lsy041015/capstone-design-hanyang-university/README.md

<p align="center">
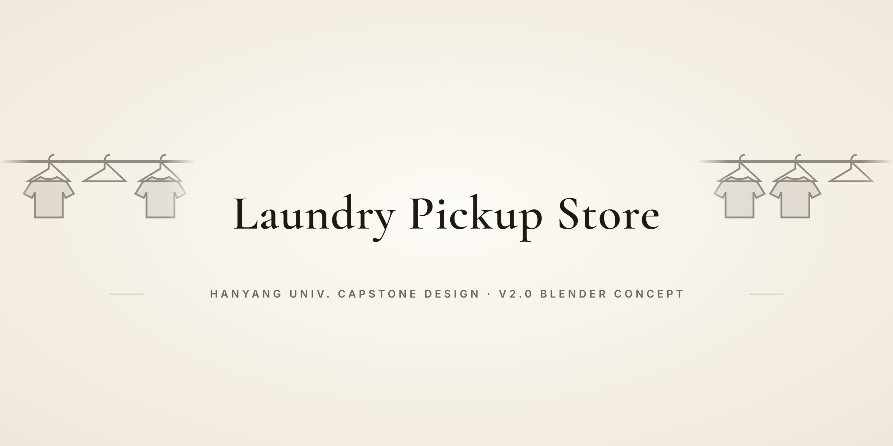
[picture p1: assets/capstone-banner.png]
무인 세탁물 수령 시스템 V2.0 — 세탁 완료품을 보관하고 인증한 고객에게 24시간 내주는 무인 세탁 수령소의 Blender 컨셉
  
</p>

<p align="center"><b>한국어</b> · <a href="README.en.md">English</a></p>

# 무인 세탁물 수령 시스템 (Automated Unmanned Laundry Pickup System)

한양대학교 캡스톤디자인(Hanyang University Capstone Design) 프로젝트입니다.

> **세탁이 끝난 의류와 신발을 자동화 셀이 보관하고, 인증한 고객에게 24시간 내주는 무인 세탁 수령소 컨셉입니다.**
> V2.0은 매장 전체(고객 로비, 셀프 빨래방, 자동화 셀, 직원 공간)와 직원·고객·휠체어 사용자의 동작을 하나의 1:1 Blender 타임라인에 담았습니다.
> 로봇은 옷감이나 신발 대신 운반구의 10 mm 고정 탭만 잡고, 사람은 움직이는 기계 밖에 머뭅니다.

> **상태: V2.0 — 시각·기하·동작 설계 컨셉입니다. 제작하거나 인증받은 기계가 아닙니다.** 저장한 모델을 다시 열어 자동 검사 7개를 통과했습니다
> (인터록 6,620프레임 위반 0, 로봇 동작 1,004프레임 간섭 0 등). 시간은 가정 축 속도로 계산한 모델 시간이고, 로봇 형상은 목표 기종 FR5e가 아닌
> UR5 CB-series 대체 메시입니다. [한계와 다음 단계](#16-한계와-다음-단계)를 먼저 읽어 주세요.

> **새 PoC (2026-11):** 졸업작품 2.5 m 셀 PoC(변형 4안, 포토 렌더, 2D 도면)는 [아래 최신 섹션](#최신-졸업작품-poc-25-m-셀-2026-11)에 모았습니다. → [poc_2.5m_cell/](poc_2.5m_cell/README.md)

---

## 목차

- [최신: 졸업작품 PoC 2.5 m 셀 (2026-11)](#최신-졸업작품-poc-25-m-셀-2026-11)

1. [왜 만들었나](#1-왜-만들었나)
2. [한눈에 보기](#2-한눈에-보기)
3. [동작 방식](#3-동작-방식)
4. [세부 공정 이미지](#4-세부-공정-이미지)
5. [모션스터디 티저 (V2.0)](#5-모션스터디-티저-v20)
6. [자료 보는 방법](#6-자료-보는-방법)
7. [매장 배치와 기구 구성](#7-매장-배치와-기구-구성)
8. [공정 순서와 허용 조건](#8-공정-순서와-허용-조건)
9. [사이클 시간](#9-사이클-시간)
10. [안전 · 정비 · 접근성](#10-안전--정비--접근성)
11. [검증](#11-검증)
12. [이전 버전 (v7 · v4)](#12-이전-버전-v7--v4)
13. [저장소 구조](#13-저장소-구조)
14. [기술 스택](#14-기술-스택)
15. [만들면서 고민한 것](#15-만들면서-고민한-것)
16. [한계와 다음 단계](#16-한계와-다음-단계)
17. [출처와 라이선스](#17-출처와-라이선스)

---

## 최신: 졸업작품 PoC 2.5 m 셀 (2026-11)

V2.0 매장의 의류 출고 공정만 2.5 m × 2.5 m 알루미늄 프로파일 셀 하나로 줄인 졸업작품 PoC입니다.
UR5e와 DH-Robotics AG-95 적응형 그리퍼를 쓰고, 같은 셀에서 옷을 보관해 로봇에게 가져다주는 방식만 바꾼 4안을 모델링했습니다.
상세 수치와 설계는 [poc_2.5m_cell/README.md](poc_2.5m_cell/README.md)에 있습니다.

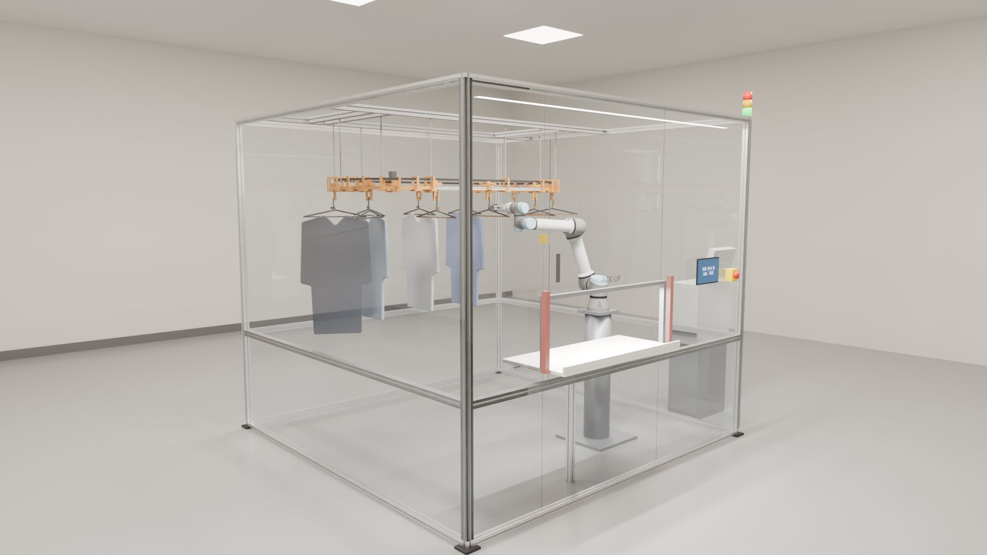
[picture p2: poc_2.5m_cell/renders/photo/P01_hero_front_left.jpg]
A안 PoC 셀 전경: 앞 왼쪽에서 본 2.5 m 프로파일 셀, UR5e, 오버헤드 컨베이어, 앞면 픽업 선반

<p align="center"><sub>A안, 앞 왼쪽에서 본 셀 전경 (Blender Cycles 포토 렌더)</sub></p>

**구성안 4가지**

A안이 처음 설계한 원안이고, B·C·D안은 접은 옷을 트레이에 담는 변형입니다. 셀 크기(2.5 × 2.5 m), 로봇, 그리퍼, 앞면 픽업 개구부는 같습니다.

| 안 | 보관 방식 | 용량 | 1사이클 (모델 시간) |
|---|---|---|---|
| A 오버헤드 컨베이어 | 옷걸이째 매달아 순환, 0.8 m 선반에 거치 | 캐리어 10개 | 46.9 s (고객 수령까지) |
| B 트레이 선반 | 접은 옷을 트레이에 담아 로봇 뒤 선반에 보관 | 2열 × 5단 = 10칸 | 38.1 s (고객이 꺼낼 때까지) |
| C 중앙 로봇 | 셀 중앙 로봇, 3면 트레이 선반, 픽업 벨트 | 3면 × 2열 × 5단 = 30칸 | 약 32.0 s (고객이 꺼낼 때까지) |
| D 서랍식 선반 | 얇은 트레이를 서랍처럼 꽂는 선반 + QR 확인, 빈 트레이는 되돌려 꽂음 | 3면 × 3열 × 15단 = 135칸 | 65.7 s (빈 트레이 복귀까지) |

사이클 시간은 끝나는 지점이 달라 그대로 비교할 수 없습니다.

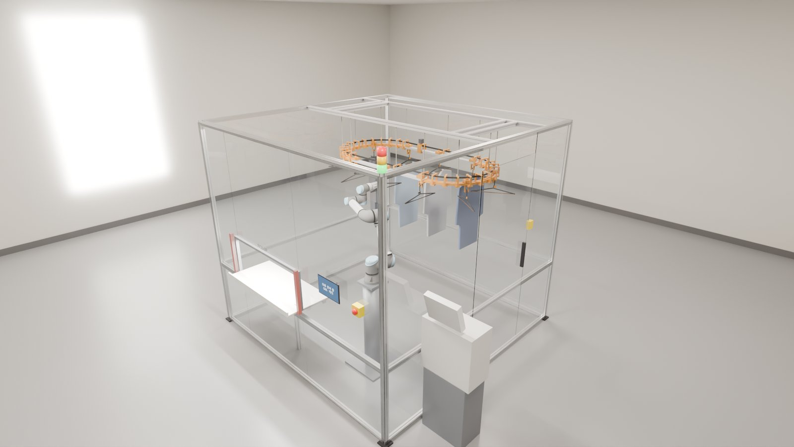
[picture p3: poc_2.5m_cell/renders/photo/P03_high_corner.jpg]
A안: 높은 모서리에서 본 오버헤드 컨베이어 셀
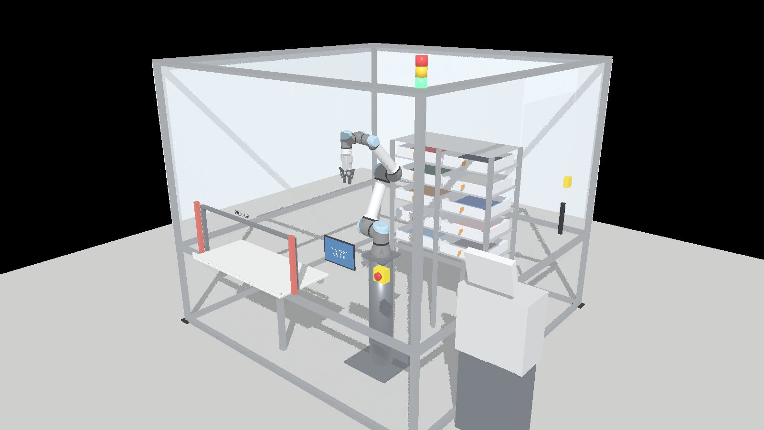
[picture p4: poc_2.5m_cell/renders/tray/T01_overview.jpg]
B안: 로봇 뒤 2열 5단 트레이 선반 전경

<p align="center"><sub>A안 오버헤드 컨베이어 (Cycles 포토) · B안 트레이 선반 (B안은 포토 렌더가 없어 Eevee 작업 렌더)</sub></p>
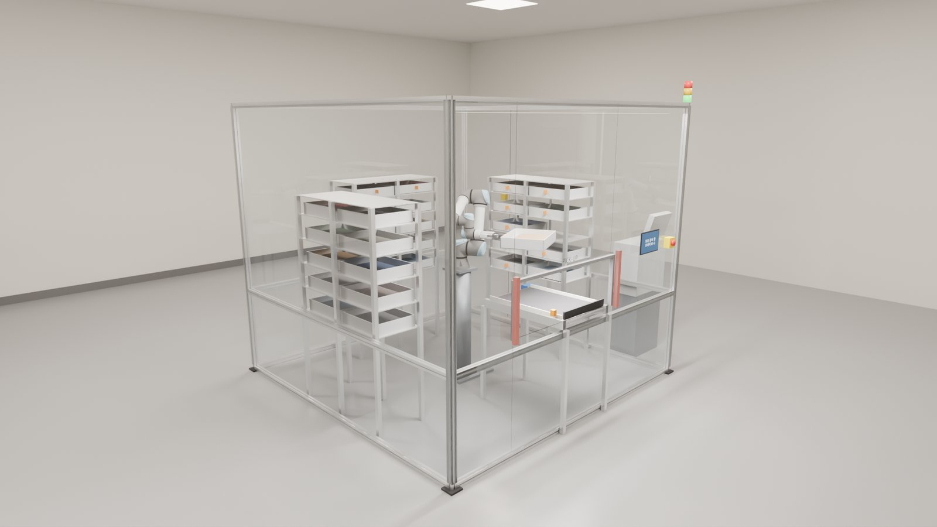
[picture p5: poc_2.5m_cell/renders/center_photo/S01_hero_front_left.jpg]
C안: 셀 중앙 로봇과 좌·뒤·우 3면 트레이 선반, 앞면 픽업 벨트
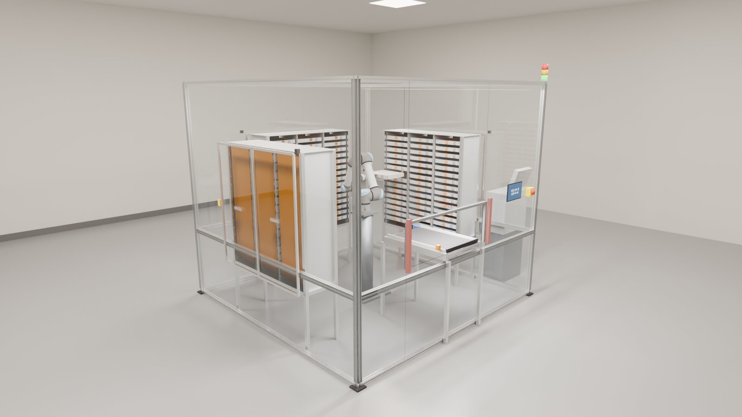
[picture p6: poc_2.5m_cell/renders/files_photo/F01_hero_front_left.jpg]
D안: 셀 중앙 로봇과 3면 135칸 서랍식 선반

<p align="center"><sub>C안 중앙 로봇과 30칸 선반 (Cycles 포토) · D안 135칸 서랍식 선반 (Cycles 포토)</sub></p>

**2D 도면**

Creo 13.4 교육용 버전에서 3각법 뷰를 만들고 ANSI C 또는 A3 도면으로 냈습니다. 치수는 Creo 뷰 위에 덧그린 주석입니다. 이미지를 누르면 PDF가 열립니다.

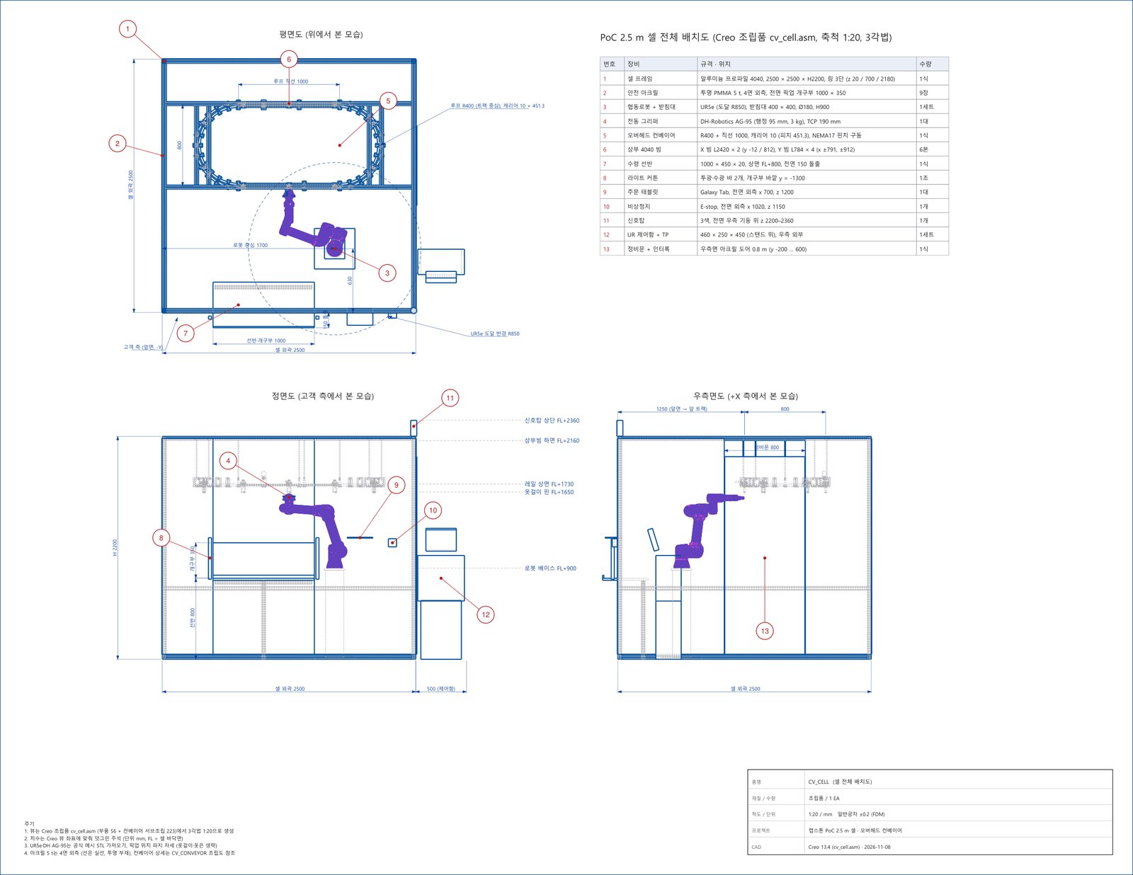
[picture p7: poc_2.5m_cell/drawings/preview/CV_CELL_LAYOUT.jpg]
A안 셀 전체 배치도 CV_CELL_LAYOUT: 평면도, 정면도, 우측면도와 부품표
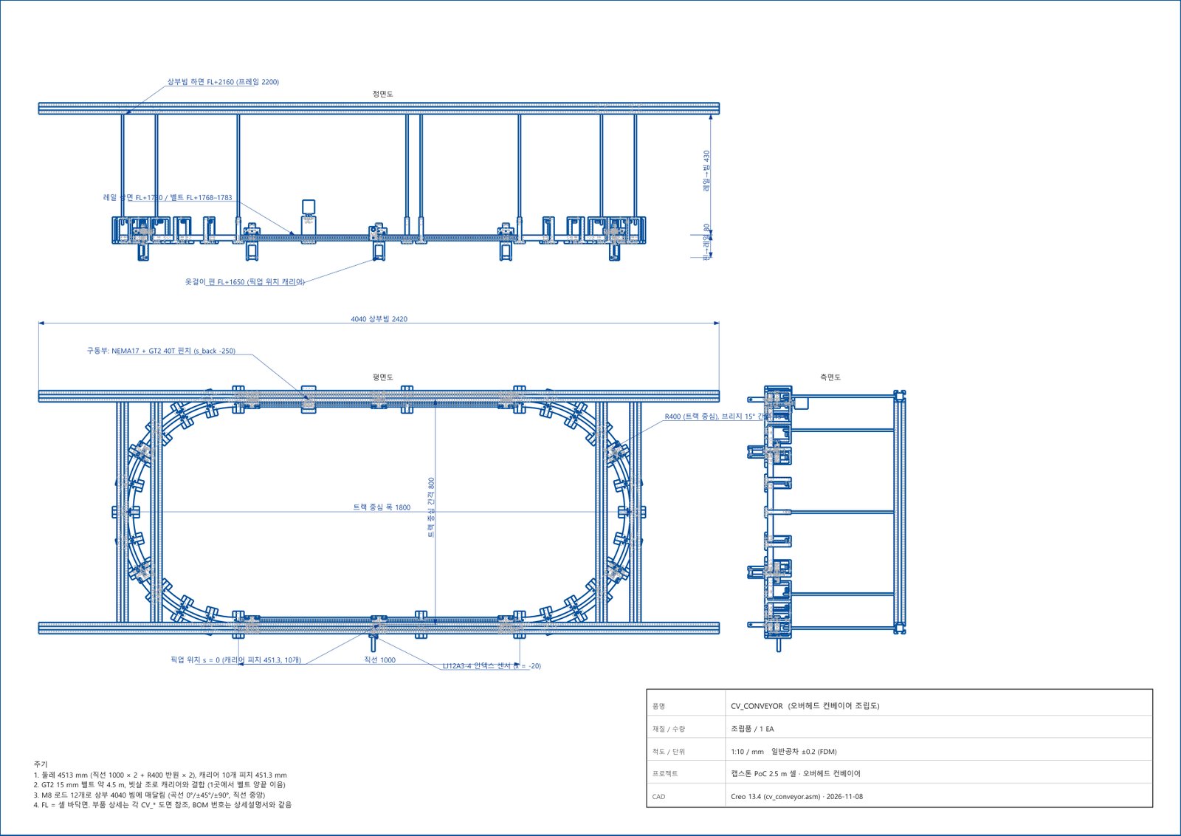
[picture p8: poc_2.5m_cell/drawings/preview/CV_CONVEYOR.jpg]
오버헤드 컨베이어 조립도 CV_CONVEYOR
<p align="center"> </p>
<p align="center"><sub>A안 셀 배치도 <code>CV_CELL_LAYOUT</code> (1:20) · 컨베이어 조립도 <code>CV_CONVEYOR</code> (1:10)</sub></p>
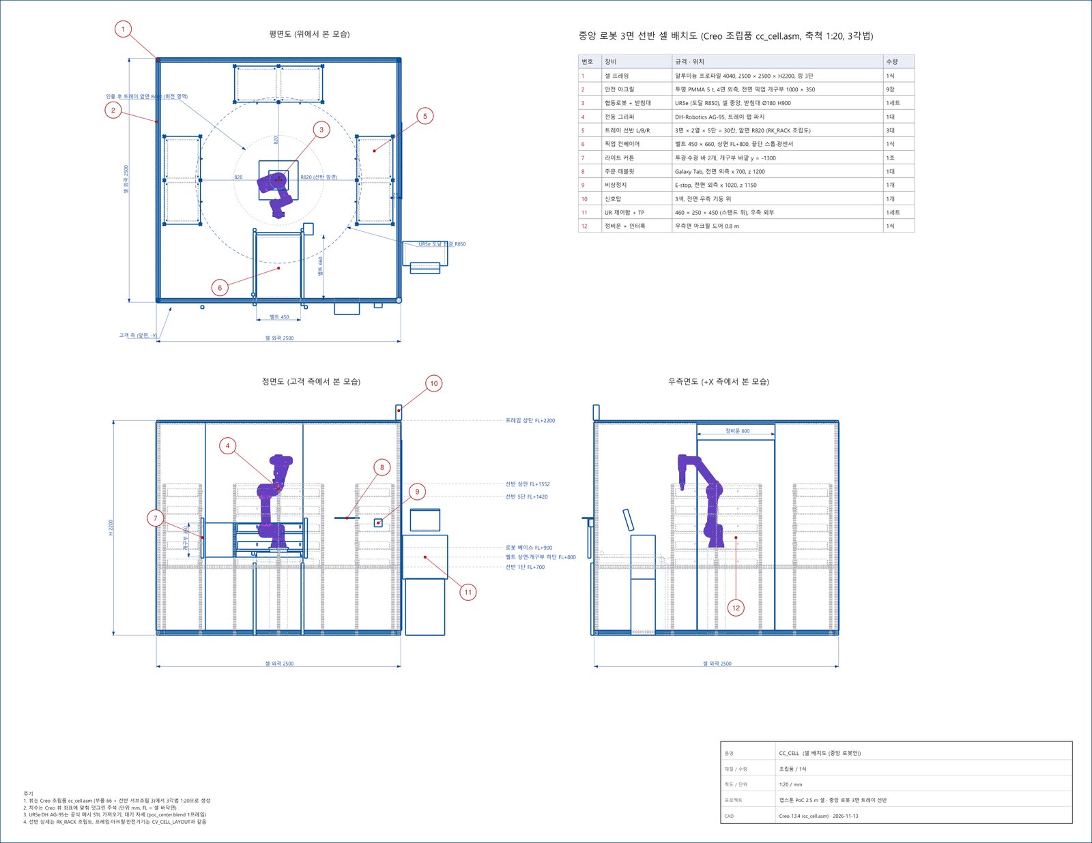
[picture p9: poc_2.5m_cell/drawings/preview/CC_CELL.jpg]
C안 셀 배치도 CC_CELL: 중앙 로봇과 3면 트레이 선반
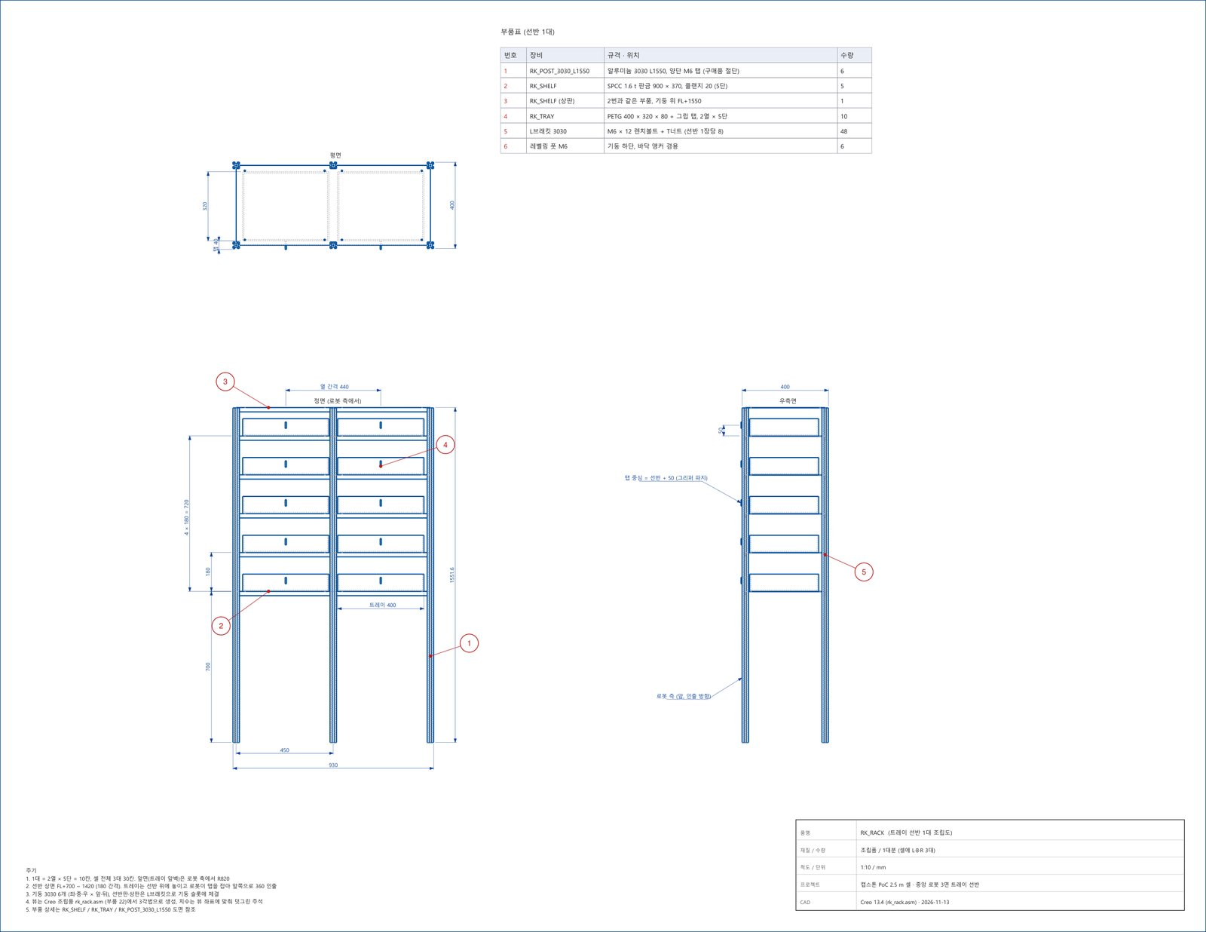
[picture p10: poc_2.5m_cell/drawings/preview/RK_RACK.jpg]
C안 트레이 선반 조립도 RK_RACK: 정면, 우측면, 평면과 부품표
<p align="center"> </p>
<p align="center"><sub>C안 셀 배치도 <code>CC_CELL</code> (1:20) · 트레이 선반 조립도 <code>RK_RACK</code> (1:10)</sub></p>

가공품 도면 묶음: [`CV_drawings_all.pdf`](poc_2.5m_cell/drawings/CV_drawings_all.pdf)(컨베이어 조립도와 가공품 9장), [`RK_drawings_all.pdf`](poc_2.5m_cell/drawings/rack_center/RK_drawings_all.pdf)(C안 선반 조립도, 선반 부품, 셀 배치도 5장).

**확인한 것과 모델뿐인 것**

- 확인한 것: A안은 Creo 파트 17종과 어셈블리 223개 컴포넌트를 배치했고(실패 0), 셀 사이클 2프레임 간격 524샘플에서 간섭 0건입니다. C안은 주문 접수부터 고객 수령까지 전체 사이클에서 0건, D안은 대표 15칸에서 0건입니다.
- 모델뿐인 것: 사이클 시간은 가정 축 속도로 계산한 모델 시간이고, 제작하거나 인증받은 설비가 아닙니다. D안의 나머지 120칸은 경로 계획만 했고, B안은 간섭 검사 결과를 남기지 않았습니다. B·C·D안의 선반, 트레이, 벨트는 Blender 개념 모델이고, Creo 선반 도면은 C안만 있습니다.
- 진행 중: 옷걸이 순환과 트레이 선반을 합친 하이브리드 변형안은 제작 중이며 아직 수치가 없습니다.

---

## 1. 왜 만들었나

매장 직원이 직접 건네주지 않아도 고객이 세탁 완료품을 찾아가게 하려면 세 가지를 함께 풀어야 합니다.

- **맞는 물품을 맞는 사람에게.** 인증한 고객에게 그 주문의 의류나 신발만 나와야 하고, 같은 재고를 두 요청이 가져가면 안 됩니다.
- **사람은 기계 밖에.** 직원이 물품을 넣을 때도, 고객이 꺼낼 때도 움직이는 기구에 손이 닿지 않아야 합니다.
- **모양이 다른 두 물품.** 옷걸이에 거는 의류와 한 켤레씩 담는 신발을 한 셀 안에서 따로 보관하고 내줘야 합니다.

V2.0은 셀만 따로 그리지 않고 매장 하나를 통째로 설계했습니다. 고객은 로비, 직원은 뒤쪽 직원 공간, 기계는 보호된 셀 안에만 있고,
서로 만나는 곳은 양문 수령함 2개와 라이트 커튼 보충구 2개뿐입니다. 직원이 무엇을 넣고 고객이 어디에 손을 뻗는지까지 1:1 시간으로 따라가며 확인했습니다.
세탁·건조, 옷을 옷걸이에 거는 일, 검수·포장은 사람의 일로 남깁니다. 저장소에는 시장 조사나 비용 분석 자료가 없습니다.

## 2. 한눈에 보기

시연 모델의 규모입니다. 상용 매장의 용량이나 수익성을 뜻하지 않습니다.

- 매장 실내 10.5 × 7.5 m(약 79 m²), 천장 2.8 m
- 의류 캐리어 26개(C01 순환 보관), 신발 트레이 12개(C03 수직 보관기, VLM)
- 직원 의류 보충창 1곳, VLM 직원 베이 1곳, 고객 수령함 A(의류)·B(신발)
- 로봇 셀 1개: FR5e 적용 검토를 위해 공식 UR5 CB-series STL을 형상·공칭 기구학 대체물로 사용
- 1:1 마스터 타임라인 6,620프레임(220.6초, 30 fps), 세부 공정 25단계

| 기능 | 하는 일 |
|---|---|
| **직원 입고** | 의류는 보충창 RFID 스캔 → 빈 캐리어 인덱싱 → 걸기 → 완료 버튼 순서입니다. 신발은 VLM이 빈 트레이를 직원 베이로 내보내면 새들백을 올리고 완료를 누릅니다. 라이트 커튼이 손을 감지하는 동안 해당 축은 멈춥니다. |
| **보관** | 의류는 C01 수평 체인 루프(캐리어 26개, 피치 203.2 mm)에, 신발은 C03 VLM(2열 × 7단, 보관 12칸)에 둡니다. |
| **고객 인증** | 키오스크에서 QR이나 수령번호로 인증하면 주문을 확인하고 물품을 예약한 뒤 준비를 시작합니다. 화면은 목업입니다. |
| **의류 출고** | C01 인덱싱·핀 체결·RFID 재확인 → C05 로봇 탭 파지 → 28 mm 리프트오프 → 0.5 m 인출 → 90° 회전 → A 수령 핀 거치·래치 → 내부 셔터 닫힘 → Y 450 mm 이송. |
| **신발 출고** | 의류와 동시에 VLM 승강·후크 추출 → 포트 컨베이어 → 로봇 → B 롤러 컨베이어 → 내부 셔터 닫힘 순서로 진행합니다. |
| **수령** | 양문 인터록: 내부 셔터가 닫히고 잠겨야 고객문이 열립니다. 옷걸이는 1.43 m, 신발 트레이 면은 0.85 m에서 받습니다. |
| **빈 운반구 회수** | 고객은 옷걸이째 의류와 새들백만 가져갑니다. 빈 어댑터는 원래 캐리어로, 빈 트레이는 VLM 빈 칸으로 자동 복귀합니다. |
| **접근성** | 낮은 위치 모드를 고르면 걸이를 23 cm 내려 1.20 m에서 받습니다. 회전 공간 지름 1.5 m, 조작부 0.4–1.2 m. |
| **정비** | SERVICE 키 → 로봇 원점·전 축 정지 확인 → 가드 잠금 해제 → 정비문 → LOTO → 닫힘·잠금 → AUTO 키 → 리셋. 자동 재기동은 없습니다. |
| **결과물** | 공정 분류도, 세부 공정 이미지 42장(6개 공정 폴더), 기구 분해도 8장, 2분 V2.0 티저와 한국어 자막, 공정 설계서, 검증 기록, 설계 신호·부품·제어 속성 목록(CSV). |

## 3. 동작 방식

매장은 고객 로비, 셀프 빨래방, 자동화 셀, 직원 공간으로 나뉩니다. 셀은 2.4 m 고정 가드와 메시 지붕으로 막혀 있고,
모든 전환은 위치·ID·안착·잠금 가운데 하나를 확인한 뒤에만 일어납니다.

```text
 1. 직원 입고 (라이트 커튼이 손을 감지하는 동안 해당 축 정지)
    의류: RFID 스캔 → 빈 캐리어 인덱싱 · 핀 → 보충창에 걸기 → 완료 · ID 재확인 → C01
    신발: 빈 트레이 → VLM 직원 베이 → 새들백 올리기 → 완료 → C03 빈 칸

 2. 고객 인증 (키오스크 QR 또는 수령번호)
    주문 확인 → 물품 예약 → 의류 · 신발 준비를 동시에 시작

 3. 의류 출고 (주문 → A 준비 27.5 s)
    C01 인덱싱 · 핀 · RFID → C05 탭 파지 → 28 mm 리프트오프 → 0.5 m 인출
    → 90° 회전 → C02 수령 핀 · 래치 → 내부 셔터 닫힘 → Y 450 mm → A 고객문 해제

 4. 신발 출고 (주문 → B 준비 40.1 s, 의류와 병렬)
    C03 승강 · 후크 추출 → 포트 컨베이어 → C05 → C06 롤러 → 내부 셔터 닫힘 → B 고객문 해제

 5. 수령과 회수
    옷걸이째 의류 · 새들백 수령 → 문 닫힘 · 제거 확인 → 주문 완료
    빈 어댑터 → C01 원래 캐리어, 빈 트레이 → C03 빈 칸

 6. 접근성과 정비
    낮은 위치 모드: Z 230 mm 하강 → 걸이 1.20 m
    SERVICE 키 → 로봇 원점 · 전 축 정지 → 가드 잠금 해제 → 정비 → 리셋 (자동 재기동 없음)
```

## 4. 세부 공정 이미지

V2.0 모델의 1:1 타임라인에서 세부 공정마다 뽑은 렌더 42장입니다. 공정별 폴더 `images/v2.0/<공정>/`에 나눠 두었고,
이미지마다 설명을 붙인 전체 목록은 [docs/v2.0_process_images.md](docs/v2.0_process_images.md)에 있습니다.
사람은 동선·도달 검토용 양식화 인형이고, 4-2 걸이 하강은 A 수령함 동쪽 라이너만 숨긴 단면 표현입니다.

먼저 공정 분류도로 전체 구성을 봅니다. 공정군 5개 아래 세부 공정 25단계를 두고, 단계마다 수행 주체(직원 · 고객 · 로봇 · 자동 설비)와 담당 모듈(C01–C06), 마스터 타임라인 시간을 붙였습니다. 모델 타임라인의 단계 목록에서 그대로 만들었습니다.

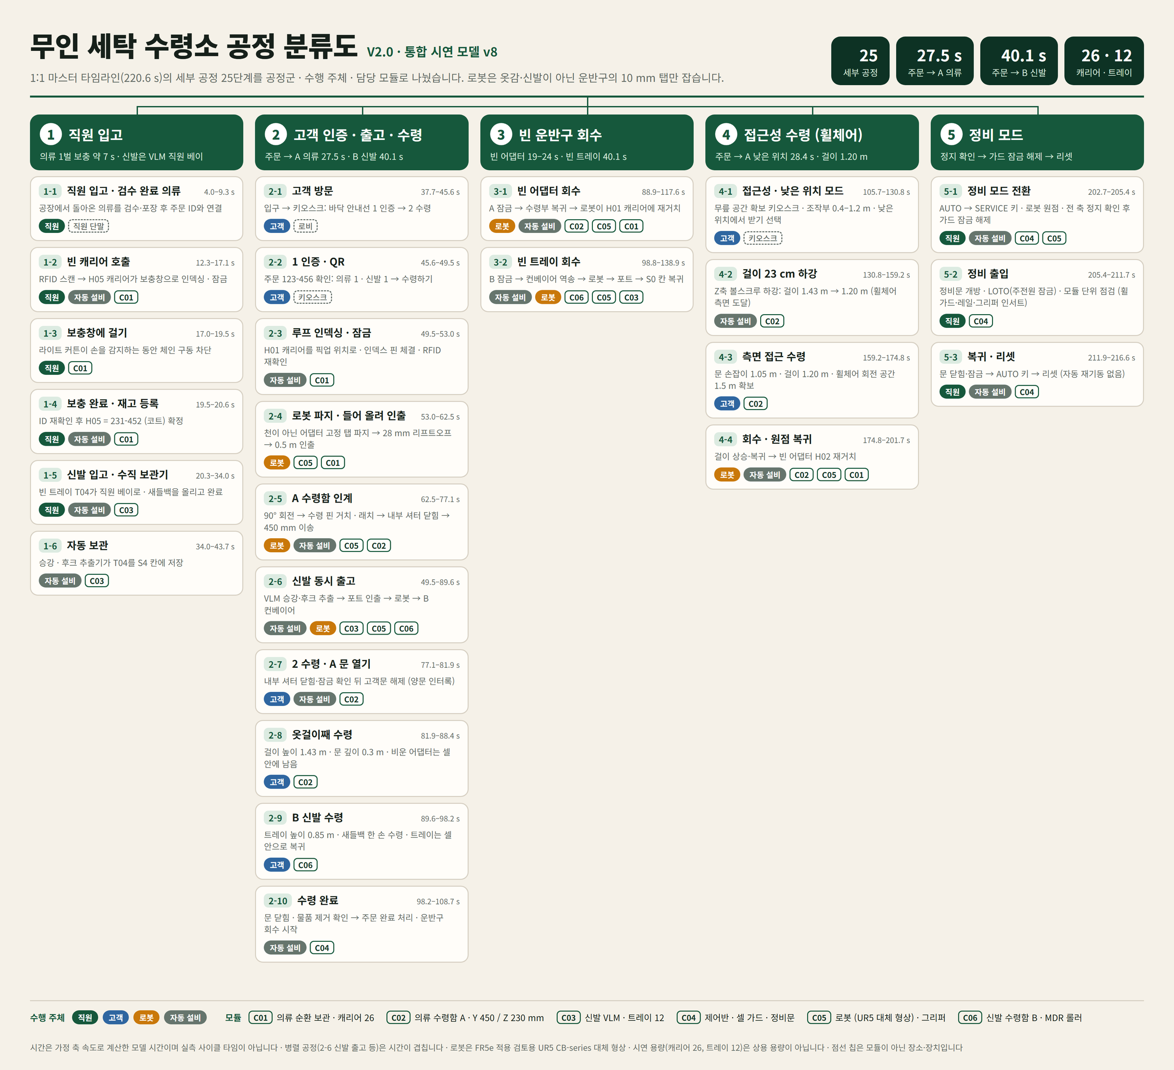
[picture p11: images/v2.0/process_map.png]
무인 세탁 수령소 V2.0 공정 분류도: 공정군 5개와 세부 공정 25단계를 수행 주체와 담당 모듈로 분류

<p align="center"><sub>공정 분류도 — 공정군 5개 · 세부 공정 25단계 · 수행 주체 · 담당 모듈 (시간은 가정 축 속도로 계산한 모델 시간)</sub></p>

<!-- v2.0-images:start -->
### 0 · 매장 구조와 동선

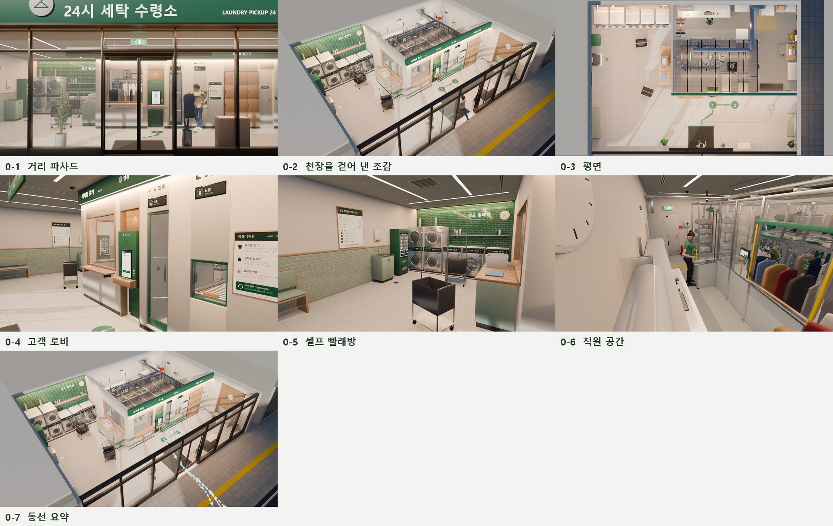
[picture p12: images/v2.0/0_store.jpg]
매장 구조와 동선 공정 이미지 모음


| 번호 | 공정 | 이미지 |
|---|---|---|
| 0-1 | 거리 파사드 — 24시 세탁 수령소 입구(자동문 폭 1.6 m), 옷을 찾아 나오는 고객 | [0-1_street_facade.jpg](images/v2.0/0_store/0-1_street_facade.jpg) |
| 0-2 | 천장을 걷어 낸 조감 — 셀프 빨래방 · 고객 로비 · 자동화 셀 · 직원 공간 | [0-2_cutaway_iso.jpg](images/v2.0/0_store/0-2_cutaway_iso.jpg) |
| 0-3 | 평면 — 실내 10.5 × 7.5 m, 자동화 셀 4.3 × 2.7 m | [0-3_plan.jpg](images/v2.0/0_store/0-3_plan.jpg) |
| 0-4 | 고객 로비 — 키오스크, A 의류 · B 신발 수령함, 이용 안내판, 대기 벤치 | [0-4_lobby.jpg](images/v2.0/0_store/0-4_lobby.jpg) |
| 0-5 | 셀프 빨래방 — 세탁기 3대, 2단 건조기 2조, 세제 자판기, 접이대 | [0-5_self_laundry.jpg](images/v2.0/0_store/0-5_self_laundry.jpg) |
| 0-6 | 직원 공간 — 검수 · 포장대, 의류 보충창, VLM 직원 베이 | [0-6_staff_area.jpg](images/v2.0/0_store/0-6_staff_area.jpg) |
| 0-7 | 동선 요약 — 고객 · 직원 · 휠체어 사용자의 이동 궤적 | [0-7_flow_summary.jpg](images/v2.0/0_store/0-7_flow_summary.jpg) |

### 1 · 직원 입고 (의류 · 신발)

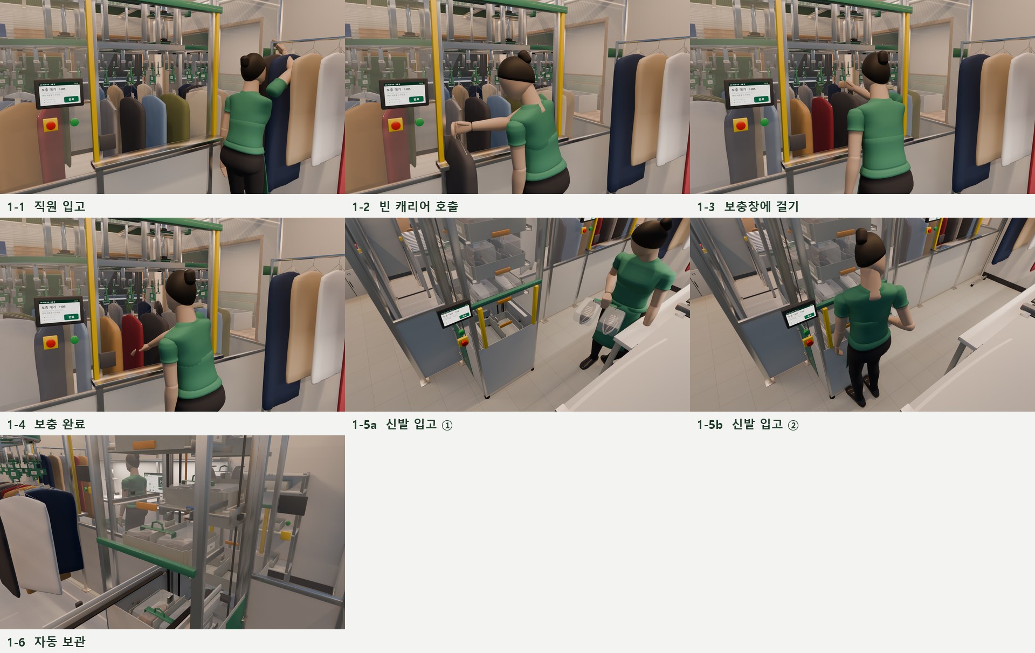
[picture p13: images/v2.0/1_staff_loading.jpg]
직원 입고 (의류 · 신발) 공정 이미지 모음


| 번호 | 공정 | 이미지 |
|---|---|---|
| 1-1 | 직원 입고 — 검수 · 포장한 의류를 주문 ID와 연결 | [1-1_inspect_garment.jpg](images/v2.0/1_staff_loading/1-1_inspect_garment.jpg) |
| 1-2 | 빈 캐리어 호출 — RFID 스캔 뒤 H05 캐리어가 보충창으로 인덱싱 · 잠금 | [1-2_call_empty_carrier.jpg](images/v2.0/1_staff_loading/1-2_call_empty_carrier.jpg) |
| 1-3 | 보충창에 걸기 — 라이트 커튼이 손을 감지하는 동안 체인 구동 차단 | [1-3_hang_at_window.jpg](images/v2.0/1_staff_loading/1-3_hang_at_window.jpg) |
| 1-4 | 보충 완료 — 완료 버튼, ID 재확인 뒤 재고 확정 | [1-4_confirm_stock.jpg](images/v2.0/1_staff_loading/1-4_confirm_stock.jpg) |
| 1-5a | 신발 입고 ① — 빈 트레이 T04가 VLM 직원 베이에 나오고, 직원이 새들백을 가져옴 | [1-5a_tray_to_staff_bay.jpg](images/v2.0/1_staff_loading/1-5a_tray_to_staff_bay.jpg) |
| 1-5b | 신발 입고 ② — 새들백을 트레이 칸막이에 걸쳐 올리고 완료 버튼 | [1-5b_place_saddle_bag.jpg](images/v2.0/1_staff_loading/1-5b_place_saddle_bag.jpg) |
| 1-6 | 자동 보관 — 승강 플랫폼과 후크 추출기가 T04를 S4 칸에 저장 | [1-6_vlm_auto_store.jpg](images/v2.0/1_staff_loading/1-6_vlm_auto_store.jpg) |

### 2 · 고객 인증 · 출고 · 수령

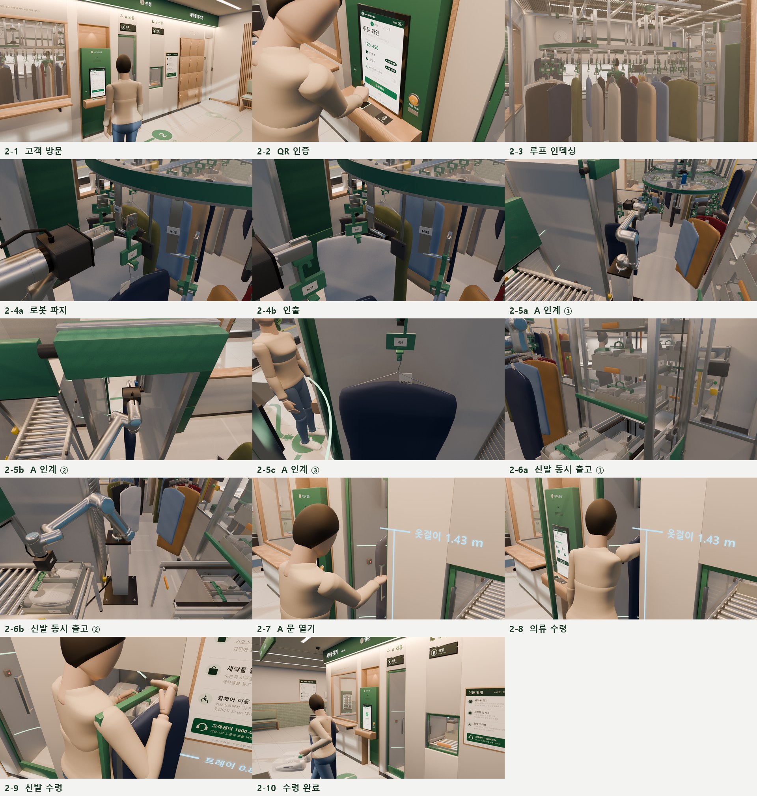
[picture p14: images/v2.0/2_order_pickup.jpg]
고객 인증 · 출고 · 수령 공정 이미지 모음


| 번호 | 공정 | 이미지 |
|---|---|---|
| 2-1 | 고객 방문 — 입구에서 바닥 안내선(1 인증 → 2 수령)을 따라 키오스크로 | [2-1_customer_arrives.jpg](images/v2.0/2_order_pickup/2-1_customer_arrives.jpg) |
| 2-2 | QR 인증 — 주문 123-456 확인: 의류 1 · 신발 1 | [2-2_kiosk_qr.jpg](images/v2.0/2_order_pickup/2-2_kiosk_qr.jpg) |
| 2-3 | 루프 인덱싱 — H01 캐리어가 픽업 위치로, 인덱스 핀 체결 · RFID 재확인 | [2-3_loop_indexing.jpg](images/v2.0/2_order_pickup/2-3_loop_indexing.jpg) |
| 2-4a | 로봇 파지 — 천이 아닌 어댑터의 10 mm 고정 탭을 잡음 | [2-4a_robot_tab_grip.jpg](images/v2.0/2_order_pickup/2-4a_robot_tab_grip.jpg) |
| 2-4b | 인출 — 28 mm 들어 올려 핀에서 빼고 반지름 방향으로 0.5 m 인출 | [2-4b_liftoff_extract.jpg](images/v2.0/2_order_pickup/2-4b_liftoff_extract.jpg) |
| 2-5a | A 인계 ① — 의류를 든 채 90° 회전 이송 | [2-5a_rotate_to_a.jpg](images/v2.0/2_order_pickup/2-5a_rotate_to_a.jpg) |
| 2-5b | A 인계 ② — 수령 핀에 거치, 래치 체결 뒤 그리퍼 개방 | [2-5b_place_on_receiver.jpg](images/v2.0/2_order_pickup/2-5b_place_on_receiver.jpg) |
| 2-5c | A 인계 ③ — 내부 셔터가 닫힌 뒤 Y축이 450 mm 이송해 고객문 뒤에 도착 (라이너를 숨긴 단면) | [2-5c_y_transfer.jpg](images/v2.0/2_order_pickup/2-5c_y_transfer.jpg) |
| 2-6a | 신발 동시 출고 ① — VLM 승강 · 후크 추출로 T01 인출 | [2-6a_vlm_fetch.jpg](images/v2.0/2_order_pickup/2-6a_vlm_fetch.jpg) |
| 2-6b | 신발 동시 출고 ② — 포트 컨베이어 → 로봇 → B 롤러 컨베이어 | [2-6b_port_to_b.jpg](images/v2.0/2_order_pickup/2-6b_port_to_b.jpg) |
| 2-7 | A 문 열기 — 내부 셔터 닫힘 · 잠금 확인 뒤 고객문 해제(양문 인터록) | [2-7_open_a_door.jpg](images/v2.0/2_order_pickup/2-7_open_a_door.jpg) |
| 2-8 | 의류 수령 — 옷걸이째 꺼냄(걸이 높이 1.43 m), 어댑터는 셀 안에 남음 | [2-8_take_garment.jpg](images/v2.0/2_order_pickup/2-8_take_garment.jpg) |
| 2-9 | 신발 수령 — 트레이 면 0.85 m, 새들백을 한 손으로 꺼냄 | [2-9_take_shoes.jpg](images/v2.0/2_order_pickup/2-9_take_shoes.jpg) |
| 2-10 | 수령 완료 — 문 닫힘 · 물품 제거 확인 뒤 주문 완료, 운반구 회수 시작 | [2-10_order_complete.jpg](images/v2.0/2_order_pickup/2-10_order_complete.jpg) |

### 3 · 빈 운반구 회수

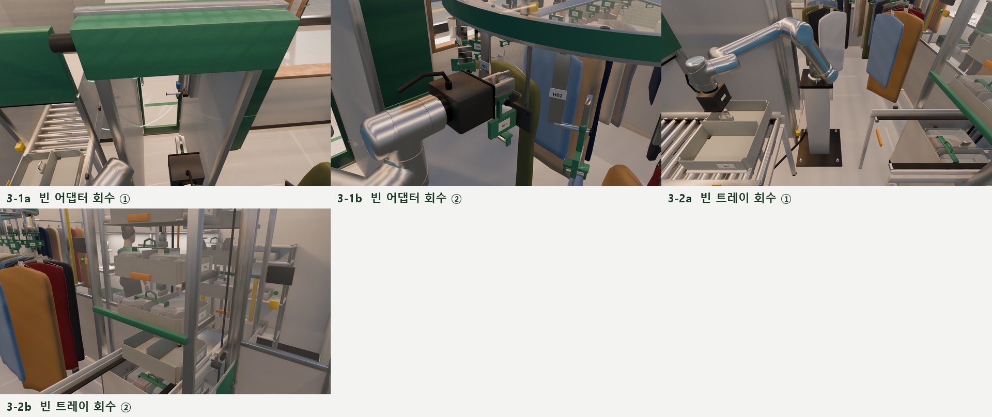
[picture p15: images/v2.0/3_carrier_return.jpg]
빈 운반구 회수 공정 이미지 모음


| 번호 | 공정 | 이미지 |
|---|---|---|
| 3-1a | 빈 어댑터 회수 ① — A 잠금, Y 복귀, 로봇이 빈 어댑터를 집음 | [3-1a_adapter_from_a.jpg](images/v2.0/3_carrier_return/3-1a_adapter_from_a.jpg) |
| 3-1b | 빈 어댑터 회수 ② — 원래 H01 캐리어 핀에 다시 거치 | [3-1b_rehang_on_h01.jpg](images/v2.0/3_carrier_return/3-1b_rehang_on_h01.jpg) |
| 3-2a | 빈 트레이 회수 ① — B 컨베이어 역송 → 로봇 → VLM 포트 | [3-2a_tray_back_to_port.jpg](images/v2.0/3_carrier_return/3-2a_tray_back_to_port.jpg) |
| 3-2b | 빈 트레이 회수 ② — 추출기가 트레이를 S0 칸으로 되돌림 | [3-2b_tray_to_s0.jpg](images/v2.0/3_carrier_return/3-2b_tray_to_s0.jpg) |

### 4 · 접근성 수령 (휠체어)

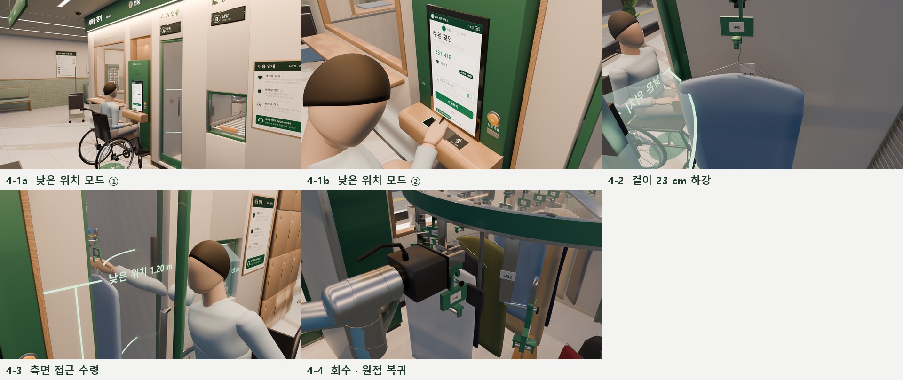
[picture p16: images/v2.0/4_accessible_pickup.jpg]
접근성 수령 (휠체어) 공정 이미지 모음


| 번호 | 공정 | 이미지 |
|---|---|---|
| 4-1a | 낮은 위치 모드 ① — 무릎 공간이 있는 키오스크에 휠체어로 정면 접근 | [4-1a_kiosk_knee_space.jpg](images/v2.0/4_accessible_pickup/4-1a_kiosk_knee_space.jpg) |
| 4-1b | 낮은 위치 모드 ② — 주문 231-418 인증, 낮은 위치에서 받기 선택 (조작부 0.4–1.2 m) | [4-1b_low_position_select.jpg](images/v2.0/4_accessible_pickup/4-1b_low_position_select.jpg) |
| 4-2 | 걸이 23 cm 하강 — Z축 볼스크루가 1.43 m → 1.20 m (라이너를 숨긴 단면) | [4-2_hanger_lowering.jpg](images/v2.0/4_accessible_pickup/4-2_hanger_lowering.jpg) |
| 4-3 | 측면 접근 수령 — 손잡이 1.05 m, 걸이 1.20 m, 회전 공간 1.5 m | [4-3_side_reach.jpg](images/v2.0/4_accessible_pickup/4-3_side_reach.jpg) |
| 4-4 | 회수 · 원점 복귀 — 빈 어댑터를 H02 캐리어에 재거치 | [4-4_return_home.jpg](images/v2.0/4_accessible_pickup/4-4_return_home.jpg) |

### 5 · 정비 모드

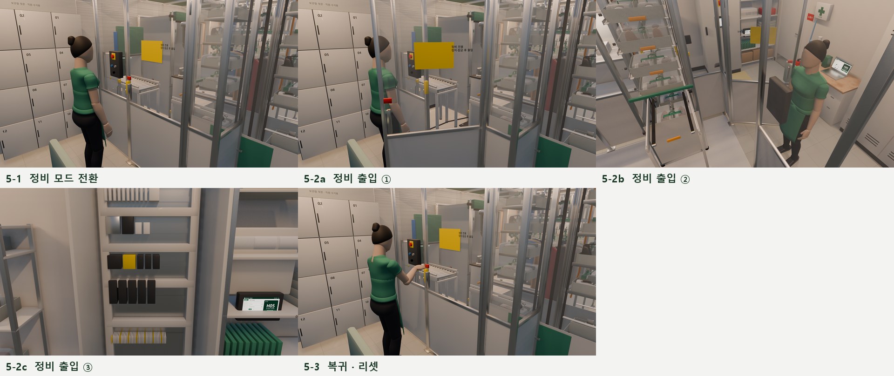
[picture p17: images/v2.0/5_service.jpg]
정비 모드 공정 이미지 모음


| 번호 | 공정 | 이미지 |
|---|---|---|
| 5-1 | 정비 모드 전환 — SERVICE 키, 로봇 원점 · 전 축 정지 확인 뒤 가드 잠금 해제 | [5-1_service_key.jpg](images/v2.0/5_service/5-1_service_key.jpg) |
| 5-2a | 정비 출입 ① — 정비문 개방(바깥 여닫이 60°) | [5-2a_service_door_open.jpg](images/v2.0/5_service/5-2a_service_door_open.jpg) |
| 5-2b | 정비 출입 ② — 셀 안에서 본 열린 정비문과 공구함을 든 정비 담당자 | [5-2b_door_from_inside.jpg](images/v2.0/5_service/5-2b_door_from_inside.jpg) |
| 5-2c | 정비 출입 ③ — C04 제어반 내부 (문을 연 상태로 렌더) · 셀 안 작업 전 주차단기에 LOTO | [5-2c_cabinet_inside.jpg](images/v2.0/5_service/5-2c_cabinet_inside.jpg) |
| 5-3 | 복귀 · 리셋 — 문 닫힘 · 잠금 → AUTO 키 → 리셋(자동 재기동 없음) | [5-3_close_and_reset.jpg](images/v2.0/5_service/5-3_close_and_reset.jpg) |

<!-- v2.0-images:end -->

## 5. 모션스터디 티저 (V2.0)

1:1 마스터 타임라인에서 15개 샷을 잘라 공정과 매장 구조, 사람과 기계가 만나는 지점을 2분 동안 설명하는 영상입니다.

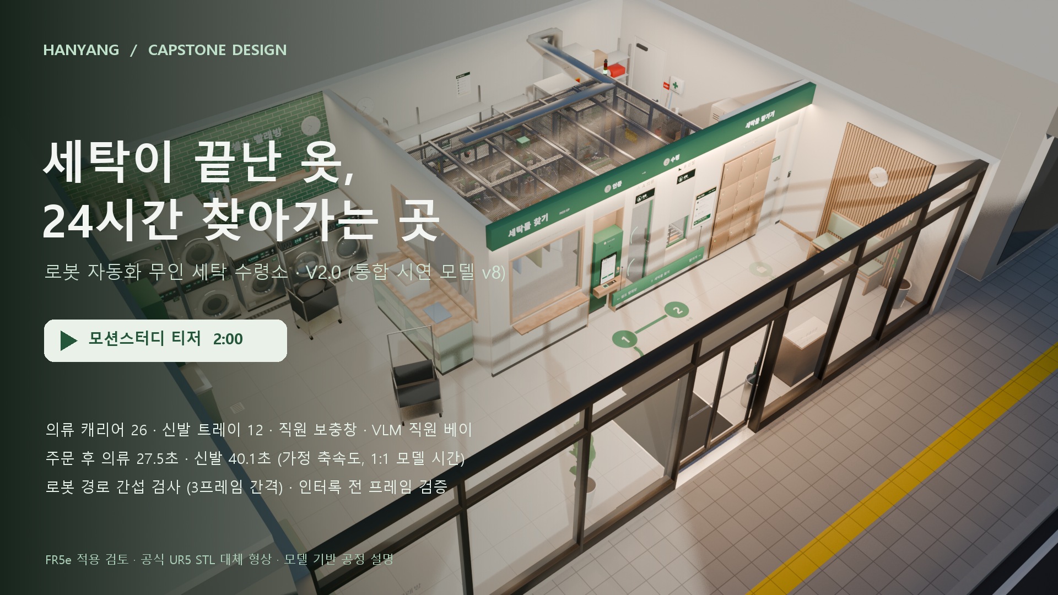
[picture p18: images/v2.0_teaser_poster.jpg]
V2.0 모션스터디 티저 포스터 — 누르면 영상 파일로 이동합니다


**[V2.0 티저 보기](videos/process_v2.0_teaser_120s_1080p30.mp4)** · 2:00 · 1920×1080 · 30 fps · 한국어 내레이션·그래픽 · [한국어 자막](videos/process_v2.0_ko.srt) · [샷별 설명](docs/v2.0_teaser.md)

- **재생**: GitHub은 저장소의 MP4를 README 안에서 재생하지 않습니다. 포스터를 누르면 파일 페이지로 이동하고, 내려받아 재생할 수 있습니다.
- **규격**: 120.0초, 3,600프레임, H.264(yuv420p) 1920×1080 30 fps, AAC 48 kHz 2채널, 챕터 15개, 36.9 MB. 음량은 −16 LUFS 목표로 정규화했습니다.
- **소리**: Windows Microsoft Heami Desktop 한국어 합성 음성과 NumPy로 합성한 앰비언트 배경음입니다. 내레이션 구간에서는 배경음이 자동으로 줄어듭니다.
- **자막**: MP4 안에 자막 트랙은 없습니다. 한국어 대사는 `videos/process_v2.0_ko.srt`에 있습니다. 화면 그래픽은 한국어입니다.

| 화면 시간 | 샷 | 카메라 | 마스터 구간 (s) |
|---|---|---|---|
| 0:00–0:06 | 오프닝 · 거리 파사드 | `CAM_STREET` | 0–6 |
| 0:06–0:14 | 매장 구조 · 절개 조감 | `CAM_ISO` | 37.5–45.5 |
| 0:14–0:26 | 직원 의류 보충 (라이트 커튼, RFID) | `CAM_STAFF_LOOP` | 8.7–20.7 |
| 0:26–0:34 | 직원 신발 보충 (VLM 베이) ×2 | `CAM_STAFF_VLM` | 25.1–41.1 |
| 0:34–0:47 | 고객 방문 · 키오스크 QR 인증 | `CAM_ENTRY`, `CAM_KIOSK` | 38.0–50.5 |
| 0:47–1:04 | 인덱싱 · 탭 파지 · 인출 · 90° 이송 (×2) | `CAM_TIP`, `CAM_ROBOT` | 51.0–76.0 |
| 1:04–1:10 | 신발 포트 → B 컨베이어 ×2 | `CAM_PORT_B` | 75.6–87.6 |
| 1:10–1:29 | A·B 수령, 높이 표시 | `CAM_A_CUST`, `CAM_B_CUST` | 77.7–97.4 |
| 1:29–1:42 | 걸이 23 cm 하강 (단면) · 휠체어 측면 접근 | `CAM_A_SECTION`, `CAM_A_WHEEL` | 151.7–174.4 |
| 1:42–1:51 | 정비 모드 · 가드 잠금 ×1.2 | `CAM_SERVICE` | 203.7–214.5 |
| 1:51–2:00 | 요약 · 동선 트레일 | `CAM_ISO` | 211.4–220.4 |

**영상을 볼 때 알아 둘 것.** 대기 구간만 1.2–2배로 압축했고, 압축한 샷에는 화면에 배속 표시가 붙습니다. 나머지는 모델의 1:1 시간입니다.
1:1 시간도 가정 축 속도로 계산한 값이며 측정한 설비 처리 속도가 아닙니다. QR 화면, 센서, 인터록은 Blender 논리 상태로 표현한 설계 신호입니다.

## 6. 자료 보는 방법

설치하거나 빌드할 소프트웨어가 없는 문서·미디어 저장소입니다.

**필요한 것**: 웹 브라우저. 자막과 함께 보려면 외부 SRT 자막을 불러올 수 있는 동영상 재생기.

```bash
git clone https://github.com/lsy041015/capstone-design-hanyang-university.git
cd capstone-design-hanyang-university

# 예: mpv에서 한국어 자막을 붙여 V2.0 티저 재생
mpv --sub-file=videos/process_v2.0_ko.srt videos/process_v2.0_teaser_120s_1080p30.mp4
```

- 읽는 순서: 이 README → [docs/v2.0_process_images.md](docs/v2.0_process_images.md)(공정별 이미지) →
  [docs/v2.0_process_design.md](docs/v2.0_process_design.md)(공정 설계서) → [docs/v2.0_verification.md](docs/v2.0_verification.md)(검증 기록).
- 설계 신호 52개는 [docs/v2.0_io_signals.csv](docs/v2.0_io_signals.csv), 부품 분류와 정비 제안은 [docs/v2.0_parts_maintenance.csv](docs/v2.0_parts_maintenance.csv),
  제어 리그의 축·신호 속성은 [docs/v2.0_control_properties.csv](docs/v2.0_control_properties.csv)에 있습니다.
- 편집 가능한 Blender 모델(`.blend`)과 생성 스크립트는 V2.0에도 포함하지 않았습니다. 모델을 직접 열거나 검사를 다시 돌릴 수는 없습니다.

## 7. 매장 배치와 기구 구성

실내 10.5 × 7.5 m를 네 구역으로 나눴습니다. 좌표는 모델 원점(남서쪽 모서리) 기준입니다.

| 구역 | 범위 (x, y m) | 내용 |
|---|---|---|
| 고객 로비 | 4.2–10.5, 0–3.0 | 자동문 입구(폭 1.6 m), 키오스크, A 의류·B 신발 수령함, 맡기기 사물함 12칸, 대기 벤치 |
| 셀프 빨래방 | 0–4.2, 0–7.5 | 세탁기 3대, 2단 건조기 2조, 세제 자판기, 접이대, 개수대 |
| 자동화 셀 | 4.2–8.5, 3.0–5.7 | 로봇(받침대 1.0 m), C01 순환 보관, C02·C06 수령부, C03 VLM, 가드 높이 2.4 m + 메시 지붕 |
| 직원 공간 | 4.2–8.5 × 5.7–7.5, 8.5–10.5 × 3.0–7.5 | 검수·포장대, 보충창, VLM 베이, C04 제어반, 로봇 컨트롤러, 정비문, 후문 |

셀은 C01–C06 여섯 모듈로 나뉩니다. 치수는 모델의 공칭 설계값이고, 부품명은 분류 예시입니다. V2.0의 모듈 번호는 v7과 뜻이 다릅니다.

| 코드 | 모듈 | 구성과 사양 |
|---|---|---|
| **C01** | 의류 순환 보관 | 수평 사이드플렉스 체인(피치 25.4 mm, 208 링크)을 알루미늄 U 트랙에 넣고 8링크(203.2 mm)마다 캐리어를 둡니다. 128포켓 휠 2개(피치 지름 1,035 mm), 경로 5.283 m. 동쪽 휠은 감속 모터·브레이크·절대 엔코더와 인덱스 핀(부시 16개), 서쪽 휠은 스크루 테이크업입니다. 가정 속도 0.25 m/s. |
| **C02** | 의류 수령함 A | 로봇 쪽 롤업 셔터(슬랫 46장), 타이밍벨트 Y축(행정 450 mm), 볼스크루 Z축(Ø12, 리드 10 mm, 행정 230 mm), 수령 핀과 솔레노이드 래치, 유리 고객문(0.46 × 1.85 m, 손잡이 1.05 m). |
| **C03** | 신발 수직 보관기 (VLM) | 남쪽 열(로봇 측)·북쪽 열(직원 측) 각 7단, 피치 250 mm. 2단(0.85 m)은 남쪽 로봇 포트와 북쪽 직원 베이입니다. 양측 타이밍벨트 승강(0.5 m/s 가정), 16 mm 상승 후크 추출기, 0.41 m 포트 컨베이어. |
| **C04** | 제어반과 셀 구조 | 800 × 550 × 2,000 mm 제어반(전원부 → 보호 → 24 V·UPS·안전 접촉기 → PLC·안전 컨트롤러·I/O → 서보 드라이브 → 단자대), 45 mm 프로파일 가드, 동쪽 정비문, 신호탑. |
| **C05** | 로봇과 그리퍼 | UR5 CB-series 대체 형상, 받침대 기준면 1.00 m. 서보 평행 그리퍼의 POM 인서트에 V 리브 2줄이 있어 탭 리브와 맞물립니다. 접근 간격 30 mm, 파지 간격 10 mm, TCP는 플랜지에서 170 mm. |
| **C06** | 신발 수령함 B | 24 V MDR 롤러 컨베이어(Ø50, 피치 75 mm, 14본). 트레이가 0.65 m 이동해 수직 슬라이딩 내부 셔터를 지나 고객 수령 위치에 섭니다. 롤러 면 0.85 m, 고객문 0.48 × 0.52 m. |

세 가지 공통 운반구가 모든 인계를 맡습니다.

| 운반구 | 형상 | 인터페이스 |
|---|---|---|
| 의류 어댑터 | PC 몸체, J-컬 새들, 스테인리스 탭, 하부 걸이봉, RFID | 캐리어·수령 핀 Ø12 위에 앉고, 28 mm 들어 올리면 빠집니다. 고객은 일반 철사 옷걸이째 가져가고 어댑터는 셀에 남습니다. |
| 신발 트레이 | 420 × 320 × 100 mm, 측면 POM 러너, 양 끝 추출 홈, 칸막이 위 탭(바닥 위 190 mm) | VLM 레일·덱·벨트·롤러의 공통 바닥면 |
| 신발 새들백 | 투명 파우치 2개를 칸막이 위 스트랩으로 연결, 손잡이 고리 | 고객·직원이 한 손으로 한 켤레를 넣고 뺍니다. 스트랩은 로봇 탭과 겹치지 않게 앞쪽 100 mm에 있습니다. |

### 기구 분해도

모듈마다 부품 그룹을 벌려 놓고 정사영으로 렌더한 분해도 8장입니다. C01–C06 여섯 모듈에, 핵심 세부 공정인 2-4 탭 파지의 그리퍼·어댑터·캐리어 인터페이스와 신발 트레이·새들백을 더했습니다. 부품 번호표는 [docs/v2.0_exploded_views.md](docs/v2.0_exploded_views.md)에 있습니다.

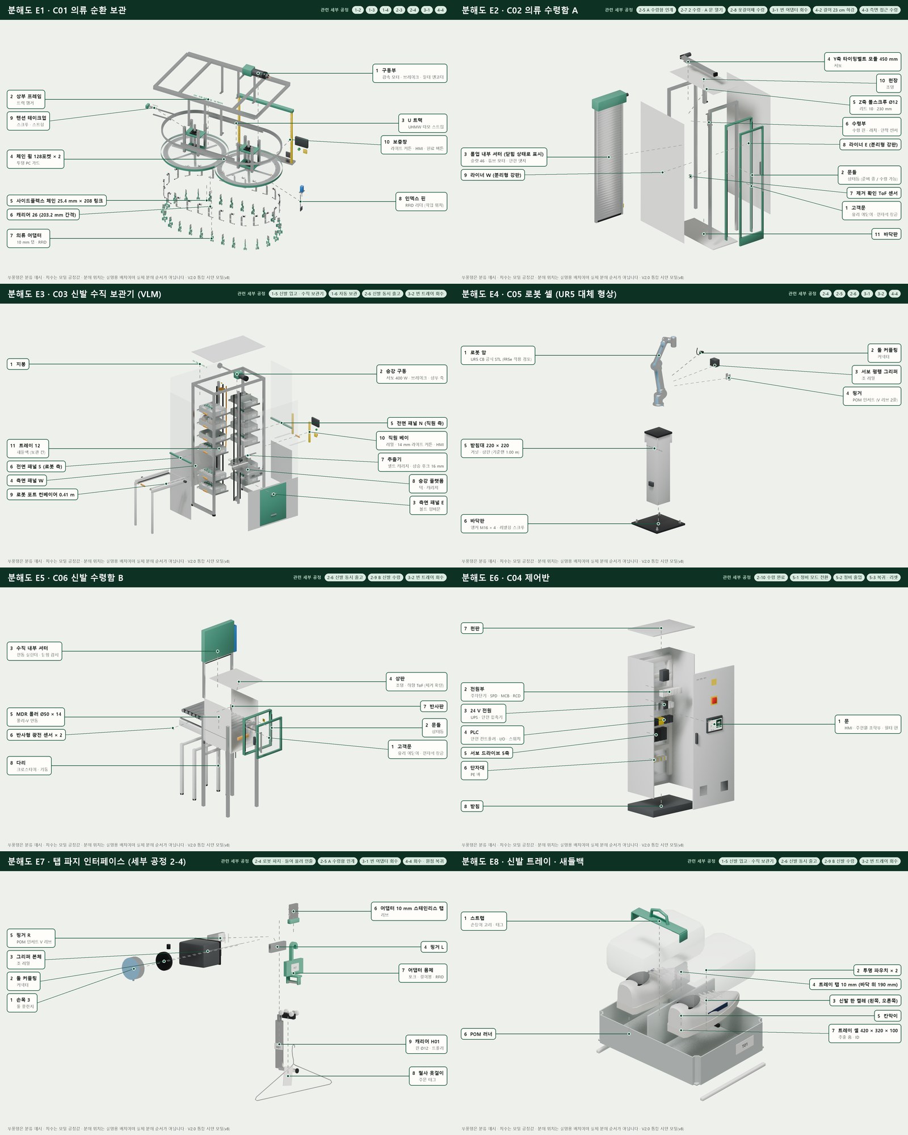
[picture p19: images/v2.0/exploded_sheet.jpg]
기구 분해도 8장 모음: C01 의류 루프, C02 A 수령함, C03 VLM, C05 로봇 셀, C06 B 수령함, C04 제어반, 탭 파지 인터페이스, 신발 트레이·새들백


<!-- v2.0-exploded:start -->
| 분해도 | 대상 | 관련 세부 공정 |
|---|---|---|
| [E1](images/v2.0/exploded/E1_c01_garment_loop.png) | C01 의류 순환 보관 | 1-2 · 1-3 · 1-4 · 2-3 · 2-4 · 3-1 · 4-4 |
| [E2](images/v2.0/exploded/E2_c02_garment_compartment_a.png) | C02 의류 수령함 A | 2-5 · 2-7 · 2-8 · 3-1 · 4-2 · 4-3 |
| [E3](images/v2.0/exploded/E3_c03_shoe_vlm.png) | C03 신발 수직 보관기 (VLM) | 1-5 · 1-6 · 2-6 · 3-2 |
| [E4](images/v2.0/exploded/E4_c05_robot_cell.png) | C05 로봇 셀 (UR5 대체 형상) | 2-4 · 2-5 · 2-6 · 3-1 · 3-2 · 4-4 |
| [E5](images/v2.0/exploded/E5_c06_shoe_compartment_b.png) | C06 신발 수령함 B | 2-6 · 2-9 · 3-2 |
| [E6](images/v2.0/exploded/E6_c04_control_cabinet.png) | C04 제어반 | 2-10 · 5-1 · 5-2 · 5-3 |
| [E7](images/v2.0/exploded/E7_tab_grip_interface.png) | 탭 파지 인터페이스 (세부 공정 2-4) | 2-4 · 2-5 · 3-1 · 4-4 |
| [E8](images/v2.0/exploded/E8_shoe_tray_saddle_bag.png) | 신발 트레이 · 새들백 | 1-5 · 2-6 · 2-9 · 3-2 |
<!-- v2.0-exploded:end -->

분해 위치는 설명용 배치이며 실제 분해 순서가 아닙니다. E2는 내부 셔터를 닫힌 상태로, E7은 2-4 탭 파지 순간(마스터 56.5 s)의 자세로 렌더했습니다.

## 8. 공정 순서와 허용 조건

각 동작 뒤에는 확인이 하나씩 붙고, 확인이 실패하면 다음 동작을 막습니다. 전체 표는 [공정 설계서 5장](docs/v2.0_process_design.md#5-공정-순서와-허용-조건)에 있습니다.

| 공정 | 동작 | 다음 단계 허용 조건 |
|---|---|---|
| 직원 의류 입고 | 태그를 보충창 RFID 패드에 댐 → 빈 캐리어(H05) 인덱싱·핀 체결 → 옷걸이를 어댑터에 걺 → 완료 버튼 | 주문 ID 유효·빈 캐리어 있음 → 엔코더 위치 = 목표·핀 체결 → 커튼 차단 중 체인 구동 금지 → 캐리어 ID와 품목 ID 일치 |
| 직원 신발 입고 | 빈 트레이(T04)가 직원 베이로 → 새들백 올리고 완료 → 추출기가 S4에 저장 | 베이 비어 있음 → 커튼 차단 중 승강·추출 금지 → 슬롯 점유 센서 확인 뒤 재고 확정 |
| 인증 | QR 인증 → 주문 확인 → 수령하기 | 주문 유효·중복 작업 없음 → 물품 예약 |
| 의류 출고 | 인덱싱·핀·RFID → 탭 파지 → 리프트오프·인출 → 90° 이송 → 거치 → 래치 → 해제 → 후퇴 → 셔터 닫힘 → Y 이송 | 로봇 원점·캐리어 정지 → 그리퍼 위치 센서 → 안착 센서 → 래치 닫힘 뒤 그리퍼 개방 → 로봇이 A 밖·셔터 잠금·고객문 잠금일 때만 Y 이동 |
| 신발 출고 | 승강 → 후크 → 덱 → 2단 → 포트 → 로봇 → B 컨베이어 → 셔터 닫힘 | 포트·안쪽 끝 광전 센서, 셔터 잠금 |
| 수령 | A에서 옷걸이째, B에서 새들백을 꺼냄 | 제거 확인 + 문 닫힘 → 주문 완료 |
| 회수 | 빈 어댑터: A 잠금 → Y 복귀 → 셔터 개방 → 파지 → 래치 해제 → −90° 이송 → H01 거치. 빈 트레이: B 잠금 → 역송 → 로봇 → 포트 → 추출기 → S0 | 문 잠금 확인 뒤에만 셀 쪽 동작 |
| 정비 | SERVICE 키 → 신호탑 황색 → 로봇 원점 → 전 축 정지 → 가드 잠금 해제 → 정비문(60°) → 점검 → 닫힘·잠금 → AUTO 키 → 리셋 | 셀 안 작업 전 C04 주차단기에 개인 자물쇠(LOTO) |

## 9. 사이클 시간

모델 1:1 타임라인에서 잰 시간입니다. 가정 축 속도로 계산했으며 실측값이 아닙니다.

| 작업 | 시간 | 비고 |
|---|---:|---|
| 주문 → A 의류 준비 | 27.5 s | 인덱싱·핀 체결·RFID 약 4 s 포함 |
| 주문 → B 신발 준비 | 40.1 s | VLM은 주문 즉시 병렬 시작, 로봇은 의류 뒤 |
| 주문 → A 준비 (낮은 위치) | 28.4 s | Z 230 mm 하강 포함 |
| 빈 어댑터 회수 | 19–24 s | 로봇 대기 포함 |
| 빈 트레이 회수 | 40.1 s | VLM 저장까지 |
| 직원 의류 1벌 보충 | 약 7 s | 스캔 → 인덱싱 → 걸기 → 완료 |

축 한계 가정: 로봇 관절 90°/s·180°/s²(UR5 최대 180°/s의 절반), 직선 0.25 m/s·삽입 0.06 m/s, 체인 0.25 m/s, VLM 승강 0.5 m/s,
추출기 0.3 m/s, 수령부 Y 0.3 m/s·Z 0.1 m/s, 컨베이어 0.25 m/s.

## 10. 안전 · 정비 · 접근성

안전 개념은 설계 의도이며 적합성 평가가 아닙니다. 참고한 규격은 ISO 10218, ISO 13857, ISO 14119, ISO 14120, ISO 13856-2, IEC 60204-1이고,
이 모델로 위험성 평가나 적합성 확인을 하지 않았습니다.

| 위험 지점 | 대책 | 모델 표현 |
|---|---|---|
| 로봇·체인·승강기 | 2.4 m 고정 가드 + 메시 지붕. 개구부는 수령함 2곳과 보충구 2곳뿐 | 셀 프레임 |
| 고객 수령함 A·B | 양문 인터록: 내부 셔터 닫힘·잠금 전 고객문 해제 금지, 고객문 열림 중 Y·컨베이어 구동 금지 | `a_*`, `b_*` 신호, 전 프레임 논리 검사 |
| 직원 보충창·VLM 베이 | Type 4 라이트 커튼(30 / 14 mm). 차단 시 해당 축 정지 | `curtain` 신호 |
| 정비문 | 가드 잠금 인터록, 정지 확인 뒤 해제, LOTO | `svc_door`, 조작반 |
| 체인 휠 협착점 · 셔터 하단 | 볼트 고정 투명 PC 가드 · 감압식 안전 엣지 | C01 가드, C02 셔터 |

정비는 모듈 단위입니다. C01–C06은 각자 프레임을 가진 교체 단위이고, 커버는 볼트 체결, 점검창은 투명 PC, 그리스 니플은 노란색으로 표시했습니다.
예: C01 체인 윤활 월 1회·늘어남 6개월 점검(2 % 교체), C05 핑거 인서트 V홈 마모 0.5 mm 교체(주기는 가정). 전체는 [부품·정비 목록](docs/v2.0_parts_maintenance.csv)에 있습니다.

| 접근성 항목 | 높이·치수 |
|---|---|
| 키오스크 화면 중심 / QR 리더 | 1.10 m (조작부 ≤ 1.16 m) / 0.84 m |
| A 고객문 손잡이 | 1.05 m |
| 옷걸이 (기본 / 낮은 위치) | 1.43 m / 1.20 m |
| B 트레이 면 / 새들백 손잡이 | 0.85 m / 1.00 m |
| 회전 공간 | 지름 1.5 m (수령함 앞 x 5.8–8.2, y 1.4–3.0을 비워 둠) |

휠체어 사용자는 문에 평행하게 대고 손잡이를 당겨 연 뒤 옆으로 손을 뻗어 옷걸이를 잡습니다. 측면 도달 약 0.65 m는 모형 기준 추정값입니다.

## 11. 검증

검사는 저장한 모델을 다시 열어 프레임을 실제로 평가하는 방식입니다. Blender 안의 형상·논리 상태만 확인하며,
실물 하중, 구매품 정격, PLC·안전 회로, FR5e 실측 기구학은 검사 대상이 아닙니다. 원자료는 [docs/v2.0_verification.json](docs/v2.0_verification.json)입니다.

| 검사 | 기준 | 결과 |
|---|---|---|
| 드라이버 | 모두 유효 + 단순식(Python 자동 실행 불필요) | 223개, 오류 0, 비단순식 0 |
| 기구 연동 | 휠 각 = s/R, 캐리어 = 경로 위치, Y 풀리 = −y/r, Z 스크루 = z/리드×2π, 롤러 = x/r, 승강 = z | 414 표본, 최대 오차 캐리어 0.024 mm |
| 로봇 리그 | Blender TCP = numpy 공칭 순기구학 | 최대 1.2 × 10⁻⁶ m |
| 관절 한계·속도 | ±360°, ≤ 180°/s (UR5 CB 공칭) | 최대 관절 속도 72°/s, TCP 최대 1.08 m/s |
| 화물 인계 연속성 | 모든 소켓 전환 순간의 위치 차 < 2 mm | 31회, 최대 0.78 mm |
| 인터록 논리 | 전 프레임: 양문 동시 개방, 문 열림 중 이송, 핀 체결·커튼 차단 중 체인 구동, 추출기 전개 중 승강, 정비문 개방 중 구동, 셔터 완전 개방 전 A 진입 금지 | 6,620프레임 위반 0 |
| 로봇 간섭 | 로봇 모션 3,012프레임 중 3프레임마다, 로봇 7링크 + 그리퍼 + 들고 있는 화물 vs 반경 2 m 안의 모든 메시 | 1,004프레임 교차 0 |
| 루프 의류 간격 | 체인 위치 12곳 × 의류 26벌 상호 교차 | 2,680쌍, 교차 0 |

- **사람 모형**: 접지 중 발 미끄럼 0.00 mm(접지 구간 195개), 접촉·유지 중 손끝과 목표의 차이 ≤ 0.01 mm(938프레임), 보폭 0.61–0.66 m.
- **화면 확인**: 카메라 샷 26개의 중간 프레임과 티저 15개 샷을 1080p로 렌더해 형상·가림·동작·주석 위치를 눈으로 확인하고, 벽 속 카메라 4대와
  가시성 버그 등을 고쳤습니다.
- **카메라–사람 간격**: 영상 3,600프레임과 공정 이미지 42장에서 카메라가 사람 기준점과 수평 0.5 m 안에 들어간 경우 0건입니다.
- **영상**: 게시 MP4 판정 `PASS`. 3,600프레임 전체 디코딩 오류 0, 챕터 15개, 음량 평균 −18.7 dB · 최대 −1.5 dB. SHA-256 `cc1de31781b3…`, 전체 값은 [docs/v2.0_video_verification.json](docs/v2.0_video_verification.json)에 있습니다.
- **검사하지 않은 것**: 3프레임 간격 사이의 순간 접촉, 의류의 유연 변형, 로봇 자기 충돌, 동역학, 실제 센서 응답, 안전 기능의 성능 수준(PL), 정지 거리, 전장 설계.

자세한 기준과 고친 문제는 [docs/v2.0_verification.md](docs/v2.0_verification.md)에 있습니다.

## 12. 이전 버전 (v7 · v4)

V2.0 이전 공개본의 자료는 지우지 않고 그대로 둡니다. v7 README 전문은 [docs/v7_overview.md](docs/v7_overview.md)에 옮겨 두었습니다.

- **v7 원본 검사 모델**: 정지 검사 포즈 31개, 자동 검사 177개. 렌더 12장은 `images/01_…`–`images/12_…`, 모음 이미지는 `images/process_gallery.jpg`입니다.
- **v7 티저**: [videos/process_v7_teaser_120s_1080p30.mp4](videos/process_v7_teaser_120s_1080p30.mp4) · 2:00 · 21장면 · 한국어·영문 자막 · [장면별 설명](docs/v7_process_teaser.md)
- **v4 영상**: [videos/process_v4_60s_1080p30.mp4](videos/process_v4_60s_1080p30.mp4) · 60초 · 86개 세부 공정 · 음성 없음

v7은 셀만 다룬 모델이고 시연 용량(의류 8, 신발 트레이 4)과 모듈 번호(C01–C07)가 V2.0과 다릅니다. 두 버전의 수치를 섞어 쓰지 마세요.

## 13. 저장소 구조

V2.0 자료는 이름에 `v2.0`이 붙어 있고, 이전 자료는 원래 이름 그대로입니다.

```text
capstone-design-hanyang-university/
├── README.md / README.en.md          # 프로젝트 설명 (한국어 / 영어)
├── assets/capstone-banner.png        # README 배너
├── docs/
│   ├── v2.0_process_images.md          # V2.0 세부 공정 이미지 42장과 설명
│   ├── v2.0_process_design.md          # V2.0 공정 설계서: 배치, 모듈, 순서, 시간, 안전, 정비
│   ├── v2.0_exploded_views.md          # V2.0 기구 분해도 8장과 부품 번호표
│   ├── v2.0_verification.md / .json    # V2.0 모델 검증 기록 7/7
│   ├── v2.0_video_verification.json    # V2.0 티저 검증 기록
│   ├── v2.0_teaser.md                  # V2.0 티저 샷별 설명
│   ├── v2.0_io_signals.csv             # 설계 신호 52개
│   ├── v2.0_parts_maintenance.csv      # 부품 분류 예시와 정비 제안
│   ├── v2.0_control_properties.csv     # 제어 리그 축·신호 속성
│   ├── v7_overview.md / .en.md         # 이전 v7 README (보관)
│   ├── v7_process_teaser.md, v7_video_verification.json
│   └── UR5_LICENSE.txt                 # UR5 메시의 BSD-3-Clause 고지
├── images/
│   ├── v2.0/<공정>/*.jpg                 # 0_store … 5_service, 공정 폴더 6개
│   ├── v2.0/<공정>.jpg                   # 공정별 모음 이미지
│   ├── v2.0/process_map.png              # 공정 분류도 (공정군 5 · 세부 공정 25)
│   ├── v2.0/exploded/*.png               # 기구 분해도 8장 (E1–E8) + exploded_sheet.jpg
│   ├── v2.0_teaser_poster.jpg
│   └── 01–12 렌더, process_gallery.jpg, v7_teaser_poster.jpg   # v7
└── videos/
    ├── process_v2.0_teaser_120s_1080p30.mp4   # V2.0 티저
    ├── process_v2.0_ko.srt                    # V2.0 한국어 대사
    └── process_v7_* / process_v4_*            # 이전 영상과 자막
```

## 14. 기술 스택

모델과 영상은 스크립트로 처음부터 생성했습니다. 스크립트는 저장소에 없고, 버전은 제작 환경에서 확인한 값입니다.

| 도구·자료 | 쓰임 | 버전 |
|---|---|---|
| Blender (EEVEE) | 매장·기구·사람 모델, 1:1 타임라인, 렌더 | 5.2.1 LTS |
| Python (시스템) + NumPy, SciPy, Pillow | 로봇 역기구학, 영상 합성·배경음, 이미지 모음 | 3.10.9 · 1.26.4 · 1.10.0 · 9.5.0 |
| FFmpeg | H.264·AAC 인코딩, 음량 정규화, 챕터 | 8.1.1 |
| UR5 CB-series 메시 | 목표 기종 FR5e 대신 쓴 로봇 형상과 공칭 기구학 | ROS 2 Description 커밋 `89bbe795f38a7ab00fb66fe8831dfff79dc99edf` |
| Microsoft Heami Desktop | 한국어 합성 내레이션 (Windows 음성) | 기록 없음 |

## 15. 만들면서 고민한 것

- **끝단에서 반지름 방향으로 뺍니다.** 의류는 레일에 직교로 걸려 있어서 휠 끝단에서는 이웃 의류가 부채꼴로 벌어집니다. 로봇이 탭을 잡고
  28 mm 들어 올린 뒤 반지름 방향으로 0.5 m 빼면 이웃 의류의 바깥 끝을 지납니다(`images/v2.0/2_order_pickup/2-4b_liftoff_extract.jpg`).
- **어댑터와 트레이가 같은 탭을 씁니다.** 두 운반구 모두 10 mm 스테인리스 탭을 가져서 그리퍼 인서트 하나로 의류와 신발을 다룹니다.
  로봇은 천이나 신발을 직접 잡지 않습니다.
- **팔꿈치를 높게 두는 해를 고릅니다.** 초기 경로에서 로봇 팔이 A 수령함 모서리 기둥을 지나갔습니다. 역기구학에서 팔꿈치-상향 해를 우선하고
  셔터 앞 후퇴 거리를 0.16 m에서 0.40 m로 늘린 뒤, 로봇 동작 1,004프레임에서 간섭이 0이 됐습니다.
- **제어 리그 하나로 움직입니다.** 셀의 모든 축과 신호가 `V8_CTRL`의 속성이고, 드라이버 223개가 모두 단순식이라 Python 자동 실행 없이 동작합니다.
  타임라인은 이 속성만 키로 가집니다([제어 속성 목록](docs/v2.0_control_properties.csv)).
- **물품은 한 번에 한 주인만 가집니다.** 옷걸이·트레이·새들백은 캐리어, 로봇, 수령부, 사람 손 가운데 한 곳에만 붙어 있고, 31번의 인계에서 위치가
  0.78 mm 넘게 튀지 않습니다. 직원이 포장대에서 새들백을 드는 순간이 가장 큽니다.
- **보이지 않으면 단면으로 보여 줍니다.** 걸이 하강은 내부 셔터가 닫힌 뒤에 일어나 밖에서 보이지 않습니다. 기구를 옮기지 않고 A 수령함 동쪽 라이너만
  숨긴 단면 카메라로 보여 주고, 화면에 단면 표현이라고 밝혔습니다(`4-2_hanger_lowering.jpg`).
- **카메라도 사람 동선 밖에 둡니다.** 직원이 신발 베이로 걸어가다 카메라 위치를 지나가서, 영상에 약 0.5초 동안 인형 안쪽이 비치는 검은 화면이 섞였습니다.
  카메라와 사람 사이의 수평 거리를 프레임마다 계산하는 검사를 만들고, VLM 베이 카메라를 직원 경로에서 0.98 m 떨어진 곳으로 옮겨 해당 샷을 다시 렌더했습니다.
- **화면 글자도 공정과 맞춥니다.** 처음에는 키오스크 화면이 한 주문용뿐이라 휠체어 사용자에게도 앞 고객의 주문번호가 떴습니다. 두 번째 주문(231-418, 의류만,
  낮은 위치)용 화면 3장을 따로 두고, 보충창·VLM 베이·직원 단말이 실제 입고 대상(캐리어 H05, 트레이 T04, 주문 231-452)을 표시하게 고쳤습니다.

## 16. 한계와 다음 단계

이 저장소는 시각·기하·동작 컨셉을 기록합니다. 실제로 만들 수 있는 기계임을 보여 주지 않습니다. 제작이나 상용 배치 전에 다음 작업이 필요합니다.

- 실제 FR5e CAD·TCP·툴 질량으로 경로와 자기 충돌을 다시 검증해야 합니다. 의류의 흔들림(유연체)은 강체로 근사했습니다.
- 체인·벨트·볼스크루·브레이크·그리퍼를 하중·토크·처짐·정지 거리로 선정해야 합니다. 지금의 부품명은 분류 예시입니다.
- PLC와 독립 안전 회로(이중 채널, 정지 범주, 재기동)를 구현하고 현물로 시험해야 합니다.
- 직원 보충·고객 수령 동작을 실제 사람으로 측정하고, 휠체어 측면 도달 0.65 m를 실측해야 합니다.
- 결제, QR, 주문, 재고, 알림 서비스를 검증해야 합니다. 지금은 화면과 논리 조건만 있습니다.

그 밖의 주의점입니다.

- 시연 용량(의류 26, 신발 트레이 12)을 상용 매장의 용량이나 수익성으로 해석하면 안 됩니다.
- 1:1 시간과 영상의 2분은 측정한 사이클 타임이 아닙니다.
- 사람 모형은 동선·도달 검토용 양식화 인형입니다. 특정 인구 통계의 대표값을 검증하지 않았습니다.
- 편집 가능한 `.blend` 파일과 생성 스크립트가 없어서, 저장소만으로는 모델을 열거나 검사를 재현할 수 없습니다.

## 17. 출처와 라이선스

이 저장소에 쓰인 외부 자료와 권리 표시입니다.

- **라이선스**: 저장소 전체에 적용되는 라이선스 파일은 없습니다. 아래 UR5 고지는 UR5 메시에만 해당하며, 이 저장소의 글·이미지·영상에는 적용되지 않습니다.
- **UR5 메시**: 렌더와 영상 속 로봇은 Universal Robots의 공식 UR5 CB-series 단순화 STL 형상입니다. 출처는
  [Universal Robots ROS 2 Description](https://github.com/UniversalRobots/Universal_Robots_ROS2_Description/tree/89bbe795f38a7ab00fb66fe8831dfff79dc99edf/meshes/ur5/collision)의
  커밋 `89bbe795f38a7ab00fb66fe8831dfff79dc99edf`로 고정했고, BSD-3-Clause 고지는 [docs/UR5_LICENSE.txt](docs/UR5_LICENSE.txt)에 있습니다.
  이 프로젝트의 창작물이 아닙니다.
- **대체 로봇 주의**: 적용을 검토한 로봇은 FR5e입니다. UR5 메시는 배치와 공칭 기구학 검토를 위한 대체물이며, UR5 사양·형상을 FR5e 성능 자료로 제시하면 안 됩니다.
- **소리**: 내레이션은 Windows Microsoft Heami Desktop 한국어 합성 음성입니다. V2.0 배경음은 NumPy로 직접 합성했고 외부 음원을 쓰지 않았습니다.
- **참고 자료**: [Universal Robots UR5 기술 사양서](https://www.universal-robots.com/media/1828033/ur5_tech_spec_web_en.pdf) ·
  [Universal Robots ROS 2 Description 저장소](https://github.com/UniversalRobots/Universal_Robots_ROS2_Description) ·
  [Metalprogetti 자동 드라이클리닝 시스템](https://www.metalprogetti.it/en/products/automated-dry-cleaning/)

한양대학교 캡스톤디자인 · 무인 세탁물 수령 시스템

---

<p align="center"><sub>LSY.KOR · <a href="https://github.com/lsy041015">다른 프로젝트 보기</a></sub></p>
