lsy041015/capstone-design-hanyang-university/poc_2.5m_cell/drawings/CV_drawings_all.pdf

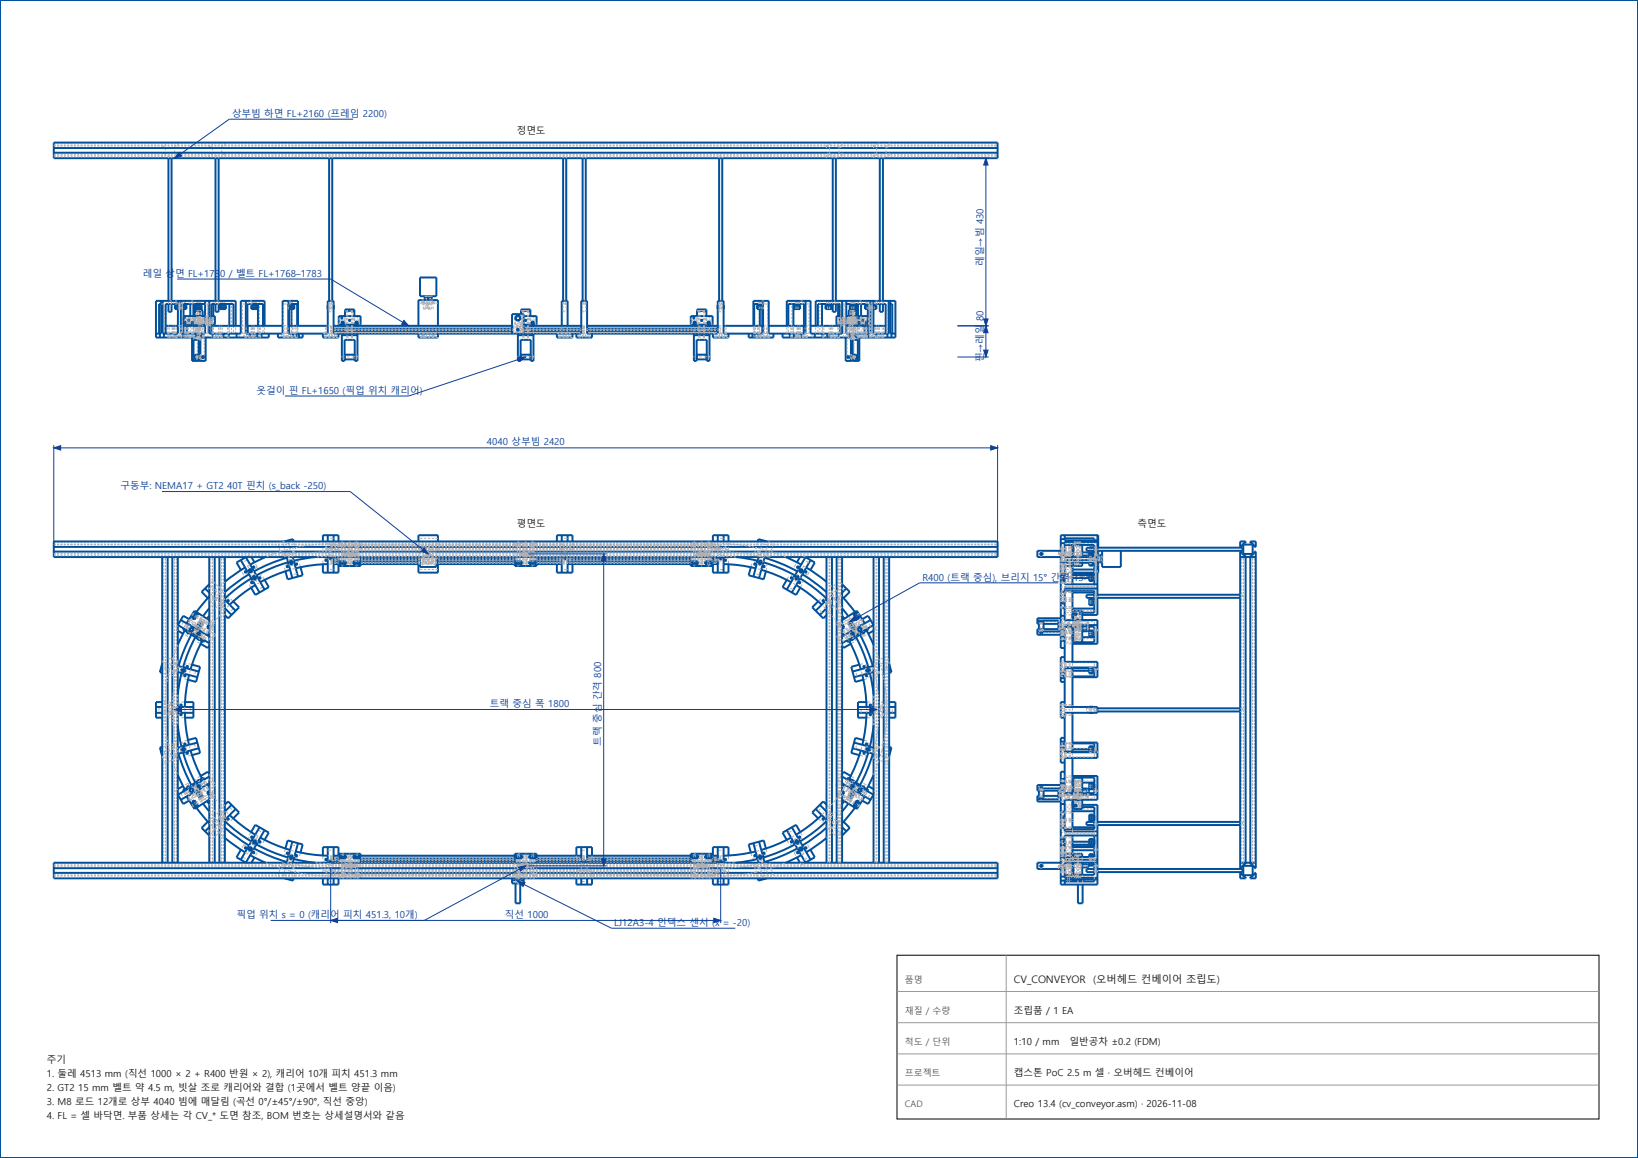
[picture p66: page 1]
구동부: NEMA17 + GT2 40T 핀치 (s_back -250); LJ12A3-4 인덱스 센서 (x = -20); 4040 상부빔 2420; CV_CONVEYOR (오버헤드 컨베이어 조립도); 조립품 / 1 EA; 1:10 / mm 일반공차 ±0.2 (FDM); 프로젝트; 캡스톤 PoC 2.5 m 셀 · 오버헤드 컨베이어; CAD; Creo 13.4 (cv_conveyor.asm) · 2026-11-08; 평면도; 정면도; 측면도

상부빔 하면 FL+2160 (프레임 2200)

옷걸이 핀 FL+1650 (픽업 위치 캐리어)

R400 (트랙 중심), 브리지 15° 간격 13개

픽업 위치 s = 0 (캐리어 피치 451.3, 10개)

1. 둘레 4513 mm (직선 1000 × 2 + R400 반원 × 2), 캐리어 10개 피치 451.3 mm
2. GT2 15 mm 벨트 약 4.5 m, 빗살 조로 캐리어와 결합 (1곳에서 벨트 양끝 이음)
3. M8 로드 12개로 상부 4040 빔에 매달림 (곡선 0°/±45°/±90°, 직선 중앙)
4. FL = 셀 바닥면. 부품 상세는 각 CV_* 도면 참조, BOM 번호는 상세설명서와 같음

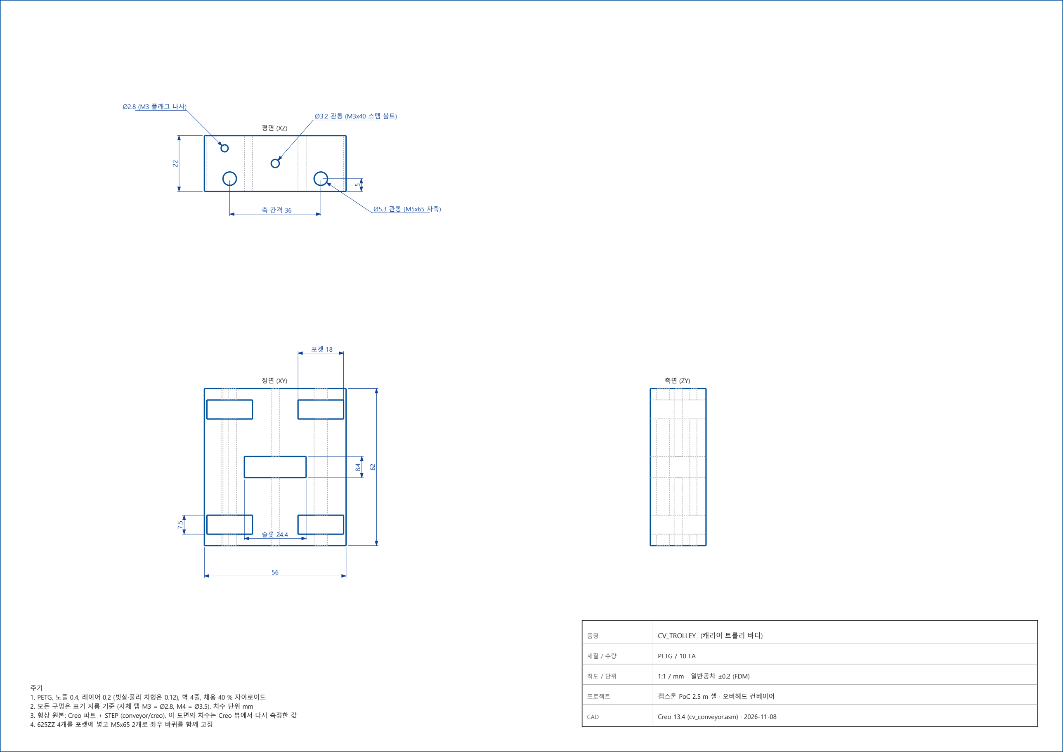
[picture p67: figure]
Ø2.8 (M3 플래그 나사); CV_TROLLEY (캐리어 트롤리 바디); PETG / 10 EA; 1:1 / mm 일반공차 ±0.2 (FDM)

1. PETG, 노즐 0.4, 레이어 0.2 (빗살·풀리 치형은 0.12), 벽 4줄, 채움 40 % 자이로이드
2. 모든 구멍은 표기 지름 기준 (자체 탭 M3 = Ø2.8, M4 = Ø3.5). 치수 단위 mm
3. 형상 원본: Creo 파트 + STEP (conveyor/creo). 이 도면의 치수는 Creo 뷰에서 다시 측정한 값
4. 625ZZ 4개를 포켓에 넣고 M5x65 2개로 좌우 바퀴를 함께 고정

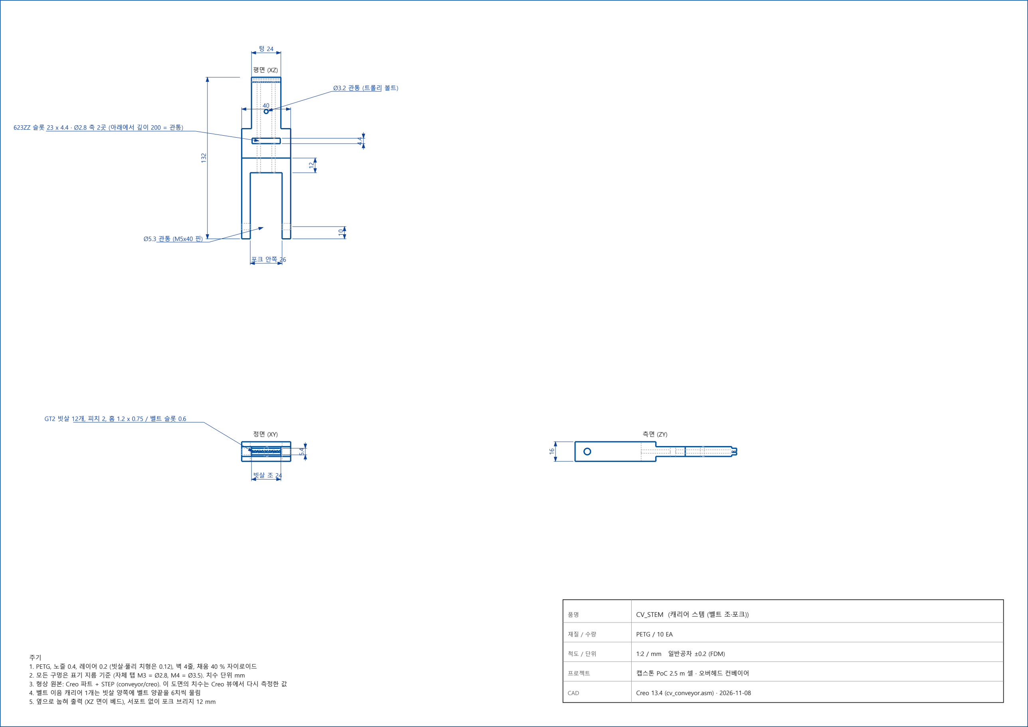
[picture p68: figure]
Ø3.2 관통 (트롤리 볼트); CV_STEM (캐리어 스템 (벨트 조·포크)); PETG / 10 EA; 1:2 / mm 일반공차 ±0.2 (FDM); 4. 벨트 이음 캐리어 1개는 빗살 양쪽에 벨트 양끝을 6치씩 물림

623ZZ 슬롯 23 x 4.4 · Ø2.8 축 2곳 (아래에서 깊이 200 = 관통)

GT2 빗살 12개, 피치 2, 홈 1.2 x 0.75 / 벨트 슬롯 0.6

5. 옆으로 눕혀 출력 (XZ 면이 베드), 서포트 없이 포크 브리지 12 mm

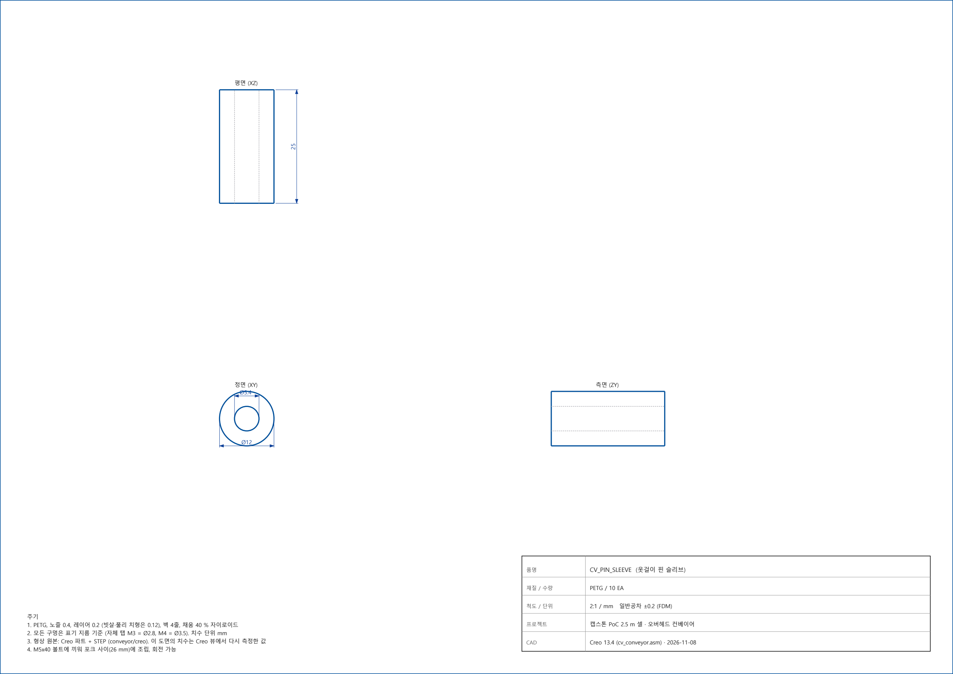
[picture p69: figure]
CV_PIN_SLEEVE (옷걸이 핀 슬리브); PETG / 10 EA; 2:1 / mm 일반공차 ±0.2 (FDM); 4. M5x40 볼트에 끼워 포크 사이(26 mm)에 조립, 회전 가능

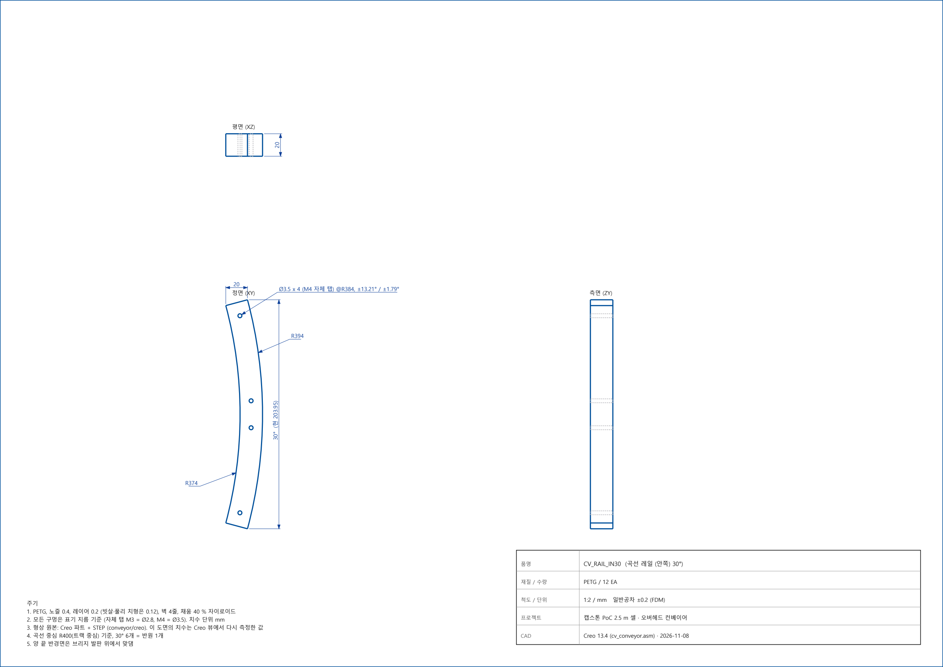
[picture p70: figure]
CV_RAIL_IN30 (곡선 레일 (안쪽) 30°); PETG / 12 EA; 1:2 / mm 일반공차 ±0.2 (FDM); 4. 곡선 중심 R400(트랙 중심) 기준, 30° 6개 = 반원 1개 5. 양 끝 반경면은 브리지 발판 위에서 맞댐

Ø3.5 x 4 (M4 자체 탭) @R384, ±13.21° / ±1.79°

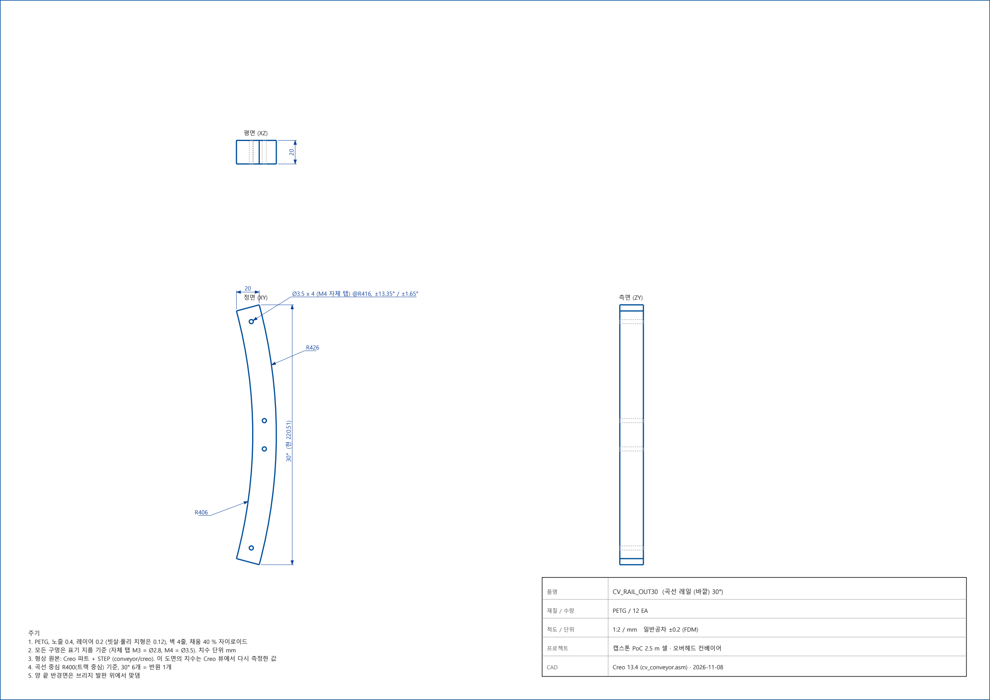
[picture p71: figure]
CV_RAIL_OUT30 (곡선 레일 (바깥) 30°); PETG / 12 EA; 1:2 / mm 일반공차 ±0.2 (FDM); 4. 곡선 중심 R400(트랙 중심) 기준, 30° 6개 = 반원 1개 5. 양 끝 반경면은 브리지 발판 위에서 맞댐

Ø3.5 x 4 (M4 자체 탭) @R416, ±13.35° / ±1.65° ²⁰

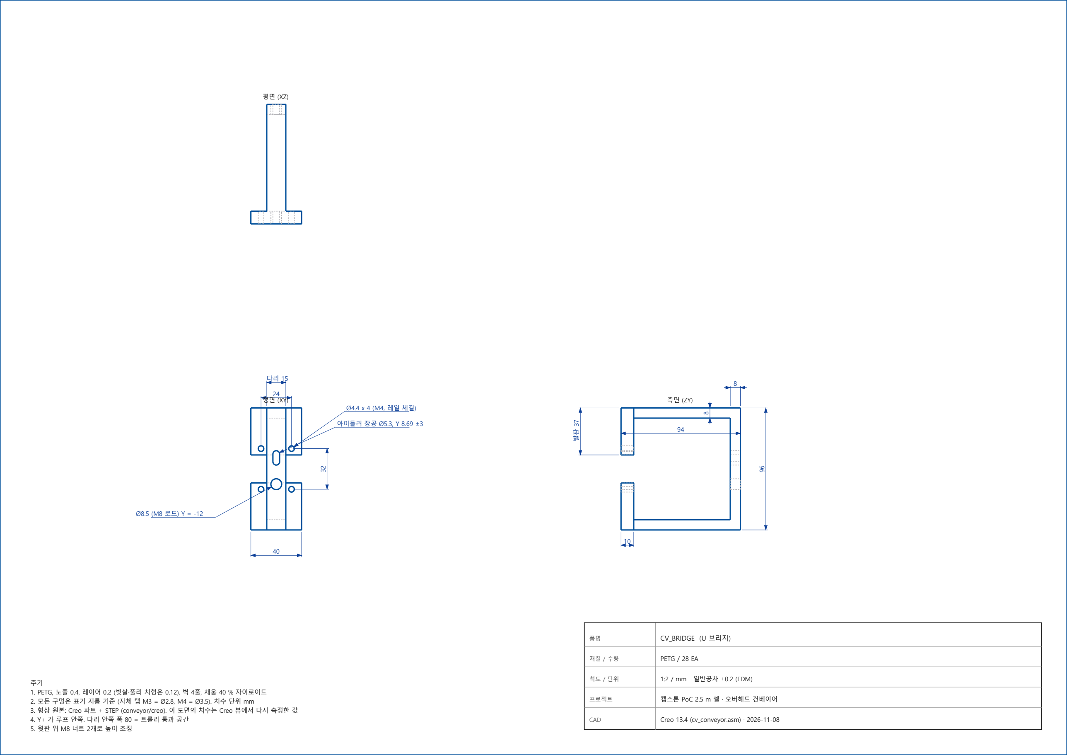
[picture p72: figure]
아이들러 장공 Ø5.3, Y 8.69 ±3; CV_BRIDGE (U 브리지); PETG / 28 EA; 1:2 / mm 일반공차 ±0.2 (FDM); 4. Y+ 가 루프 안쪽. 다리 안쪽 폭 80 = 트롤리 통과 공간 5. 윗판 위 M8 너트 2개로 높이 조정

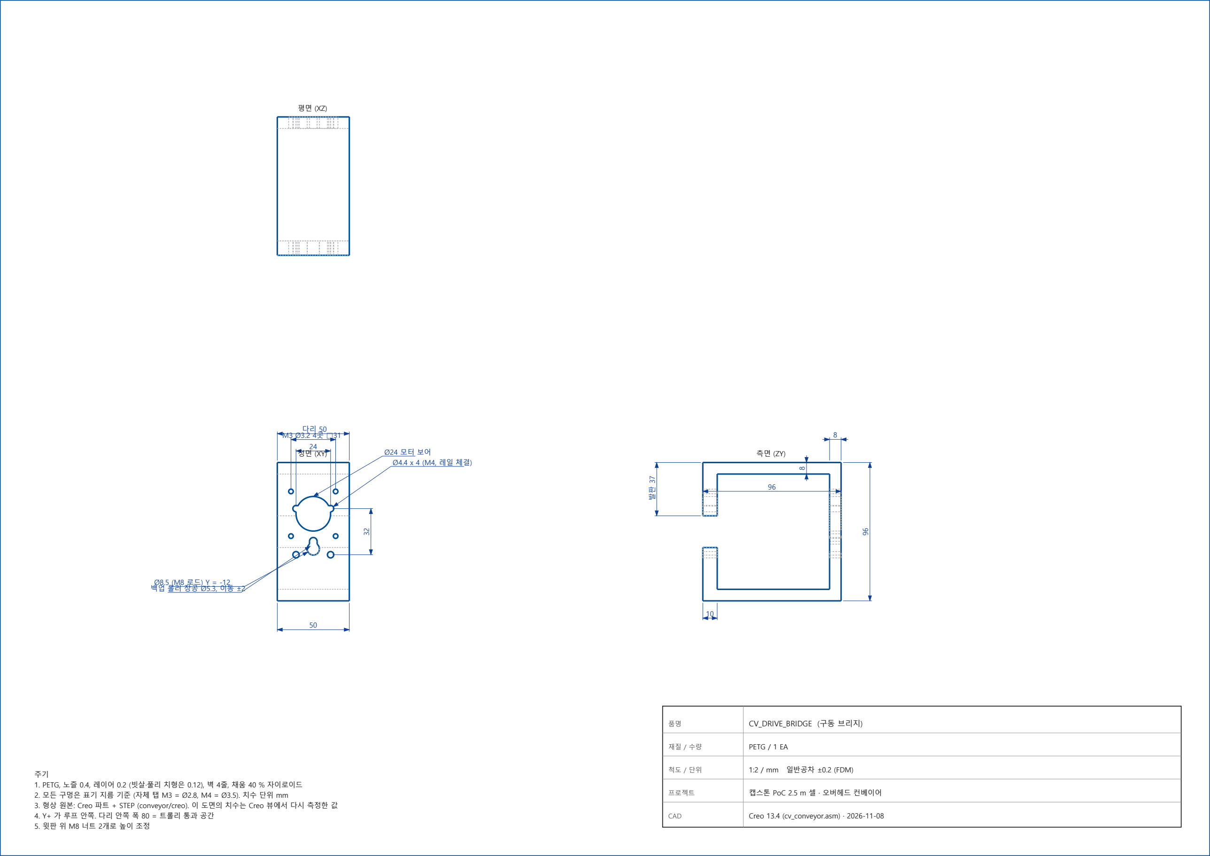
[picture p73: figure]
CV_DRIVE_BRIDGE (구동 브리지); PETG / 1 EA; 1:2 / mm 일반공차 ±0.2 (FDM); 4. Y+ 가 루프 안쪽. 다리 안쪽 폭 80 = 트롤리 통과 공간 5. 윗판 위 M8 너트 2개로 높이 조정

# Ø5.1 보어 (5 mm 축, 리밍) ³²

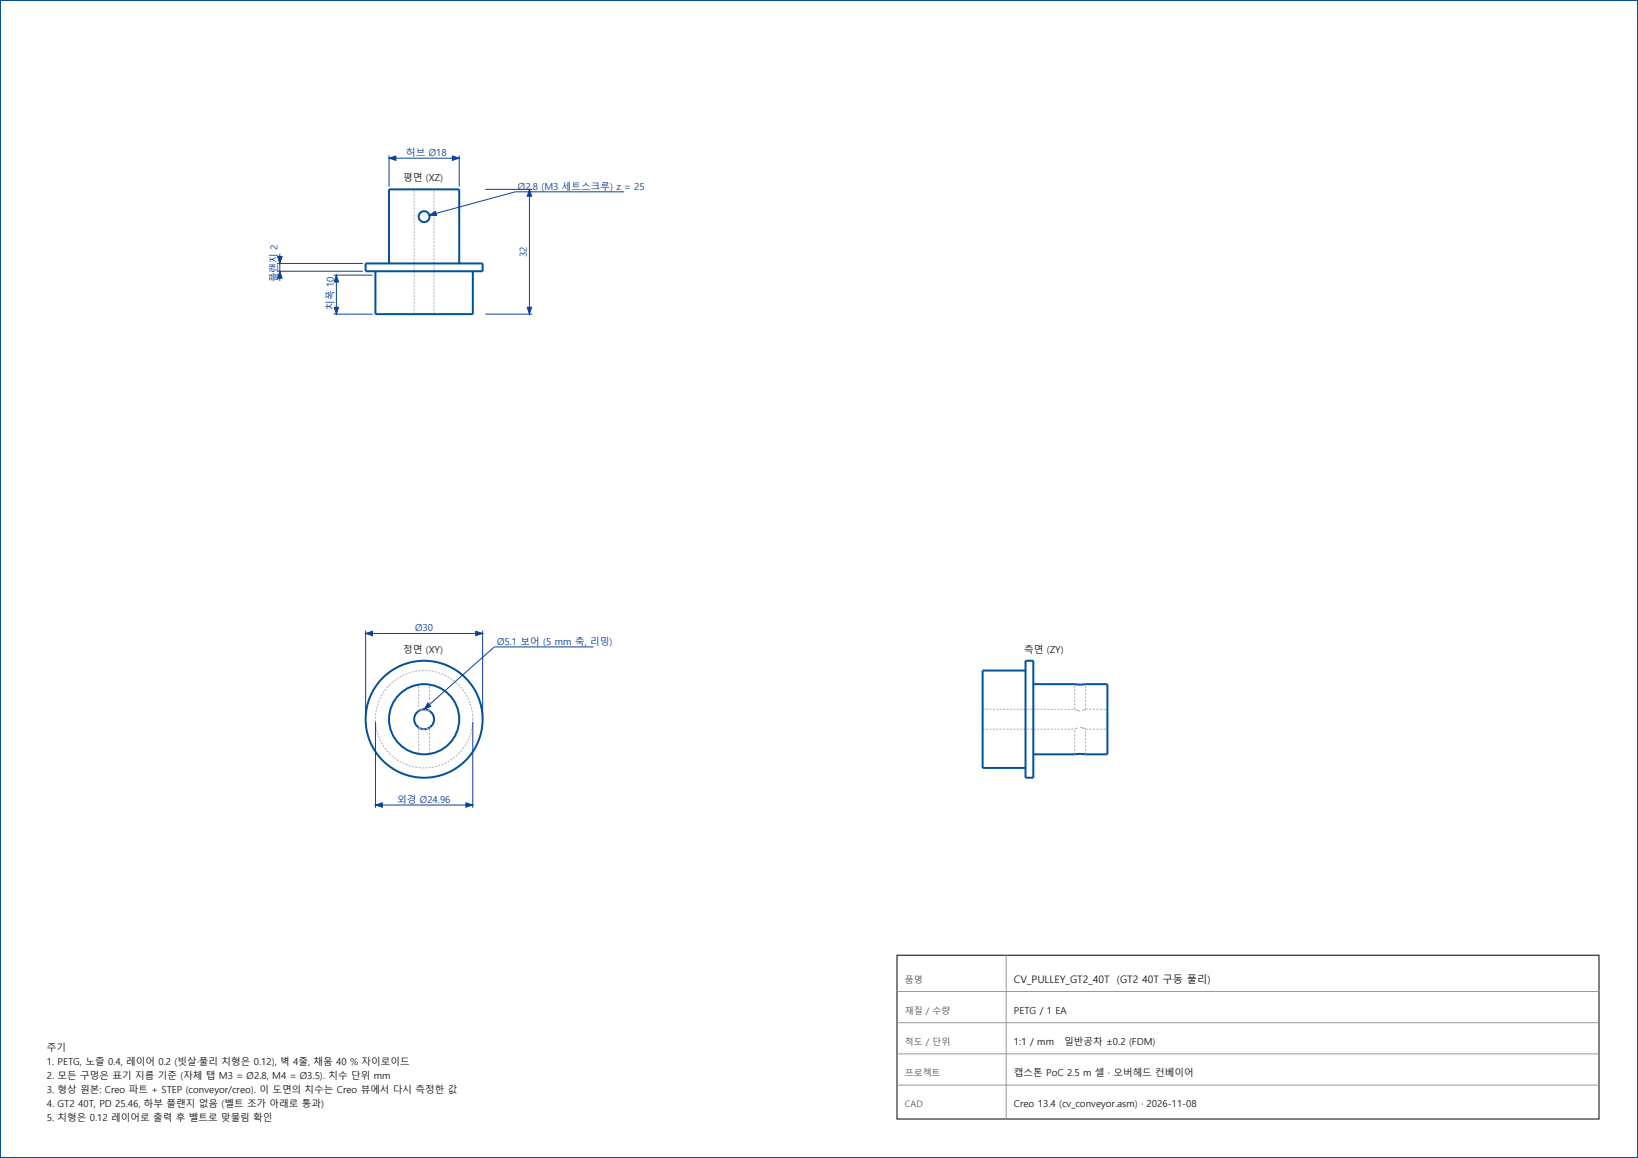
[picture p74: page 9]
플랜지 2; Ø2.8 (M3 세트스크루) z = 25; CV_PULLEY_GT2_40T (GT2 40T 구동 풀리); PETG / 1 EA; 1:1 / mm 일반공차 ±0.2 (FDM)

4. GT2 40T, PD 25.46, 하부 플랜지 없음 (벨트 조가 아래로 통과)
5. 치형은 0.12 레이어로 출력 후 벨트로 맞물림 확인

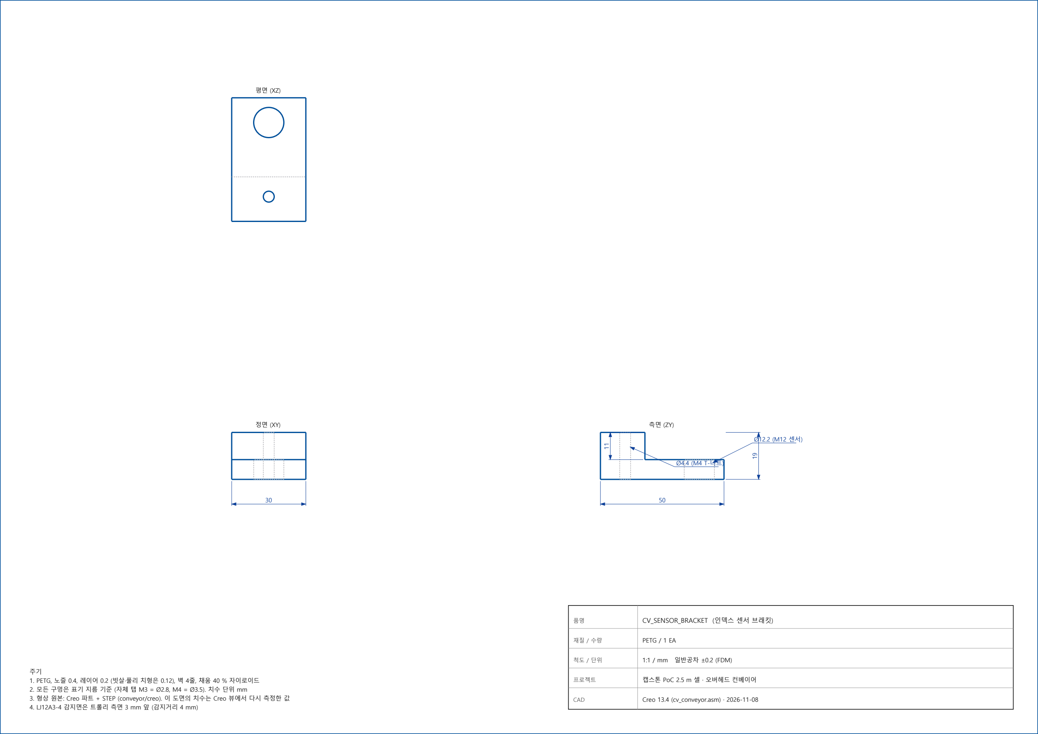
[picture p75: figure]
CV_SENSOR_BRACKET (인덱스 센서 브래킷); PETG / 1 EA; 1:1 / mm 일반공차 ±0.2 (FDM)

4. LJ12A3-4 감지면은 트롤리 측면 3 mm 앞 (감지거리 4 mm)
