lsy041015/capstone-design-hanyang-university/docs/v2.0_process_images.md

# V2.0 세부 공정 이미지

통합 시연 모델(내부 버전 v8)의 1:1 마스터 타임라인에서 세부 공정마다 뽑은 렌더 42장입니다. 1920×1080, Blender 5.2.1 EEVEE, 64 samples. 괄호 안 시간은 마스터 타임라인 위치(모델 시간)이며 측정한 설비 사이클 타임이 아닙니다. 사람은 동선·도달 검토용 양식화 인형입니다. [README로 돌아가기](../README.md)

## 공정 분류도

<p align="center">V2.0 공정 분류도: 공정군 5개와 세부 공정 25단계를 수행 주체와 담당 모듈로 분류</p>

## 0. 매장 구조와 동선

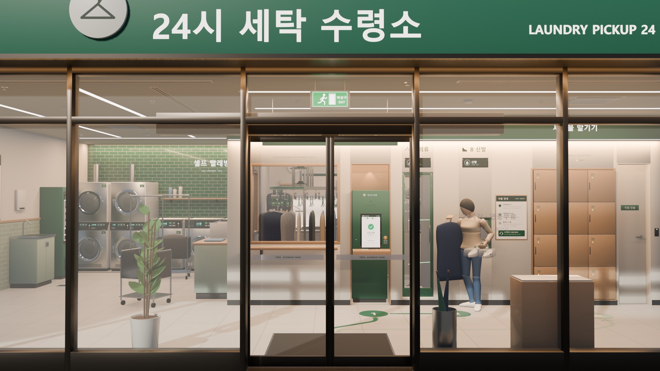
[picture p76: images/v2.0/0_store/0-1_street_facade.jpg]
거리 파사드 — 24시 세탁 수령소 입구(자동문 폭 1.6 m), 옷을 찾아 나오는 고객

<p align="center"><sub>0-1 거리 파사드 — 24시 세탁 수령소 입구(자동문 폭 1.6 m), 옷을 찾아 나오는 고객 (100.0 s · CAM_STREET)</sub></p>

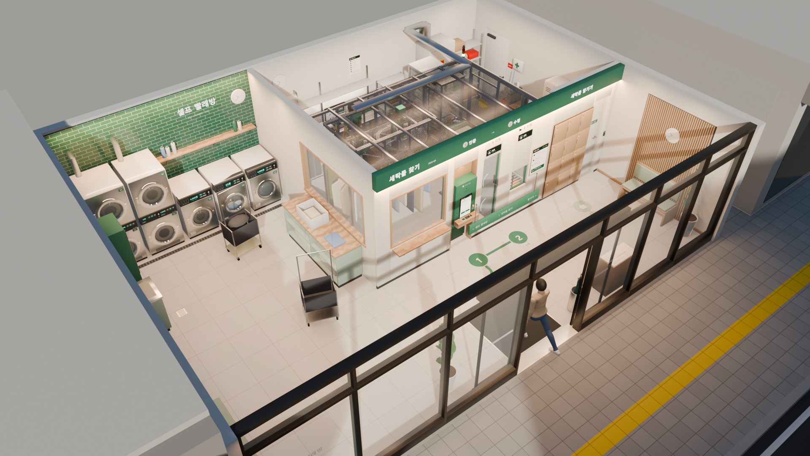
[picture p77: images/v2.0/0_store/0-2_cutaway_iso.jpg]
천장을 걷어 낸 조감 — 셀프 빨래방 · 고객 로비 · 자동화 셀 · 직원 공간

<p align="center"><sub>0-2 천장을 걷어 낸 조감 — 셀프 빨래방 · 고객 로비 · 자동화 셀 · 직원 공간 (41.5 s · CAM_ISO)</sub></p>

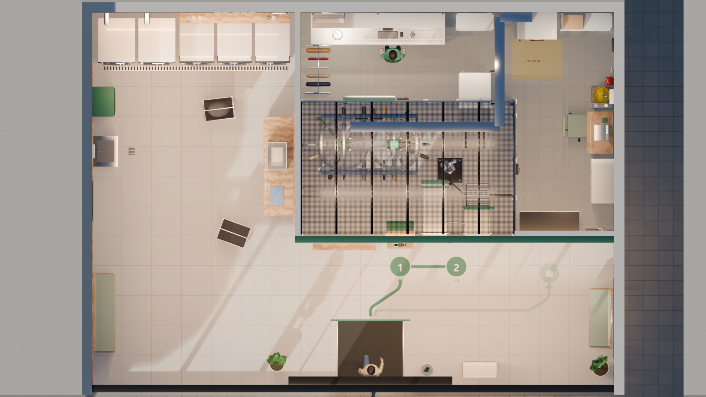
[picture p78: images/v2.0/0_store/0-3_plan.jpg]
평면 — 실내 10.5 × 7.5 m, 자동화 셀 4.3 × 2.7 m

<p align="center"><sub>0-3 평면 — 실내 10.5 × 7.5 m, 자동화 셀 4.3 × 2.7 m (41.5 s · CAM_PLAN_FULL)</sub></p>

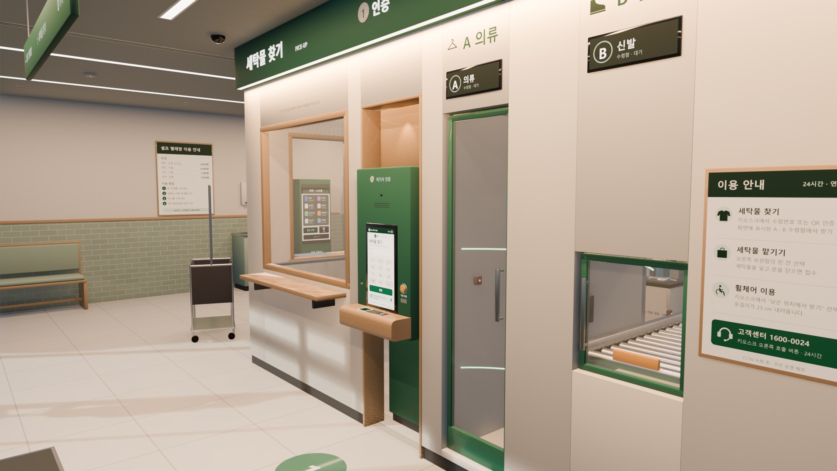
[picture p79: images/v2.0/0_store/0-4_lobby.jpg]
고객 로비 — 키오스크, A 의류 · B 신발 수령함, 이용 안내판, 대기 벤치

<p align="center"><sub>0-4 고객 로비 — 키오스크, A 의류 · B 신발 수령함, 이용 안내판, 대기 벤치 (41.0 s · CAM_LOBBY)</sub></p>

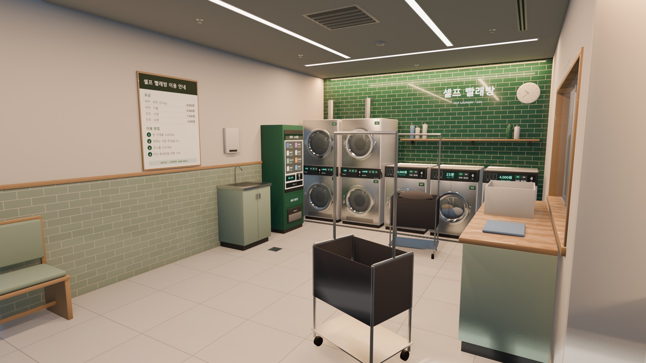
[picture p80: images/v2.0/0_store/0-5_self_laundry.jpg]
셀프 빨래방 — 세탁기 3대, 2단 건조기 2조, 세제 자판기, 접이대

<p align="center"><sub>0-5 셀프 빨래방 — 세탁기 3대, 2단 건조기 2조, 세제 자판기, 접이대 (41.0 s · CAM_LAUNDRY)</sub></p>

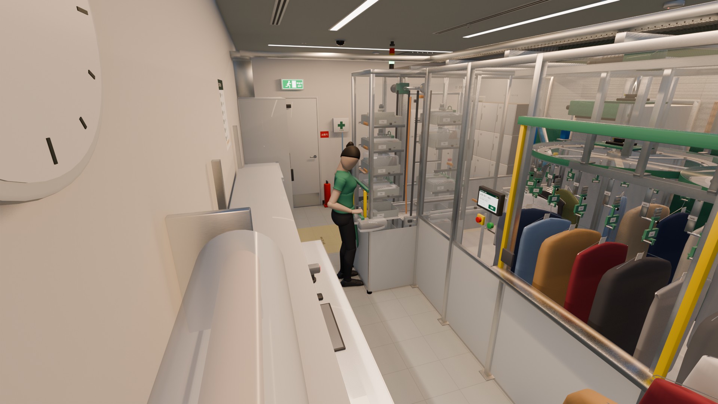
[picture p81: images/v2.0/0_store/0-6_staff_area.jpg]
직원 공간 — 검수 · 포장대, 의류 보충창, VLM 직원 베이

<p align="center"><sub>0-6 직원 공간 — 검수 · 포장대, 의류 보충창, VLM 직원 베이 (30.0 s · CAM_STAFF_NW)</sub></p>

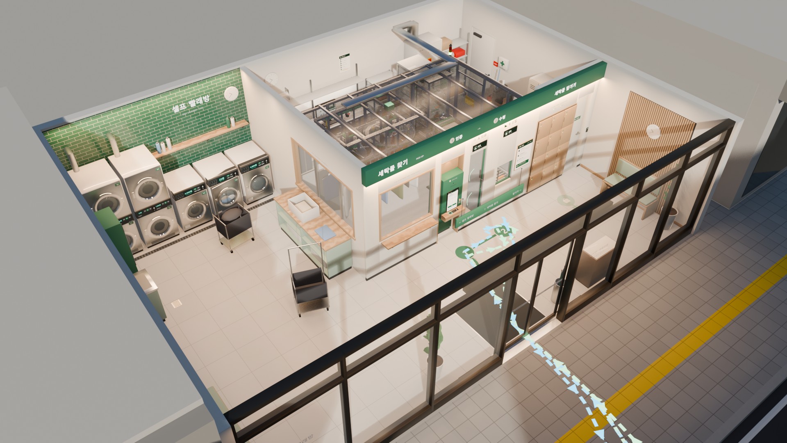
[picture p82: images/v2.0/0_store/0-7_flow_summary.jpg]
동선 요약 — 고객 · 직원 · 휠체어 사용자의 이동 궤적

<p align="center"><sub>0-7 동선 요약 — 고객 · 직원 · 휠체어 사용자의 이동 궤적 (219.0 s · CAM_ISO)</sub></p>

## 1. 직원 입고 (의류 · 신발)

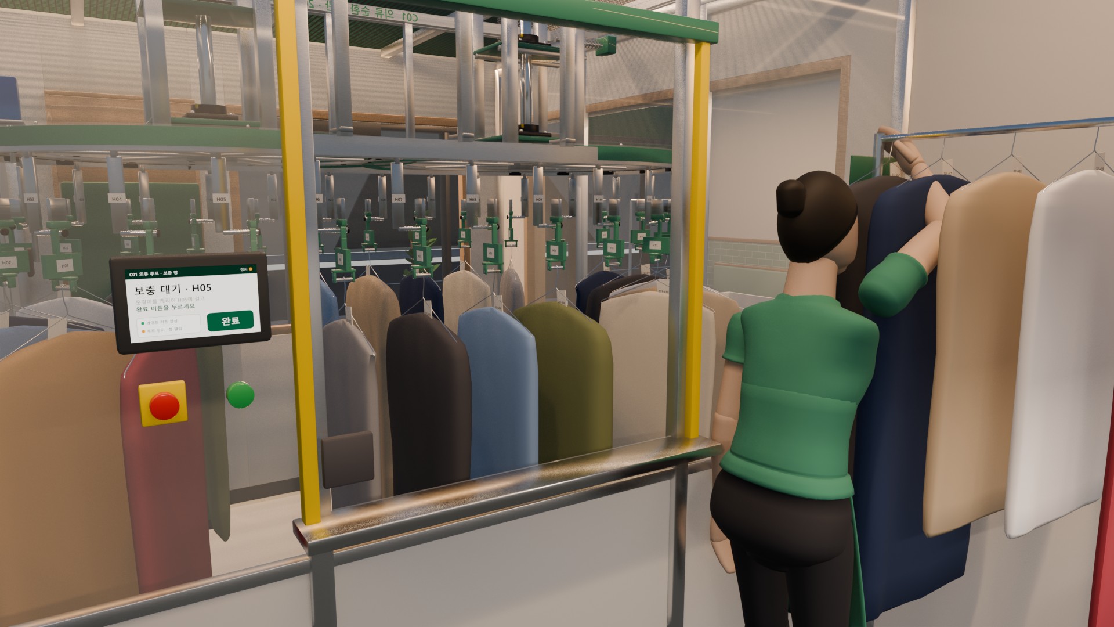
[picture p83: images/v2.0/1_staff_loading/1-1_inspect_garment.jpg]
직원 입고 — 검수 · 포장한 의류를 주문 ID와 연결

<p align="center"><sub>1-1 직원 입고 — 검수 · 포장한 의류를 주문 ID와 연결 (9.0 s · CAM_STAFF_LOOP)</sub></p>

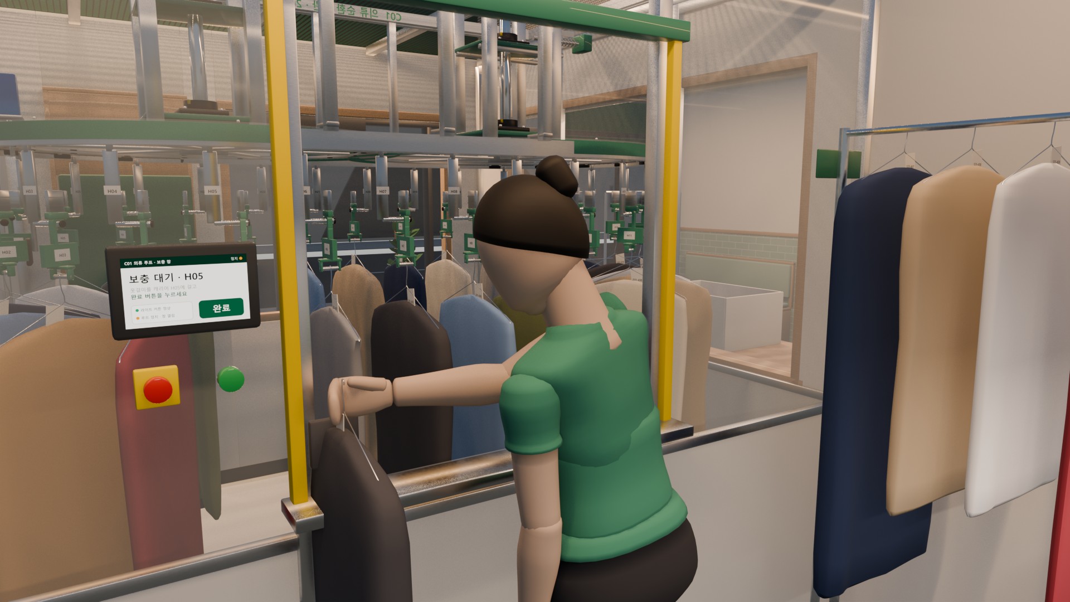
[picture p84: images/v2.0/1_staff_loading/1-2_call_empty_carrier.jpg]
빈 캐리어 호출 — RFID 스캔 뒤 H05 캐리어가 보충창으로 인덱싱 · 잠금

<p align="center"><sub>1-2 빈 캐리어 호출 — RFID 스캔 뒤 H05 캐리어가 보충창으로 인덱싱 · 잠금 (12.8 s · CAM_STAFF_LOOP)</sub></p>

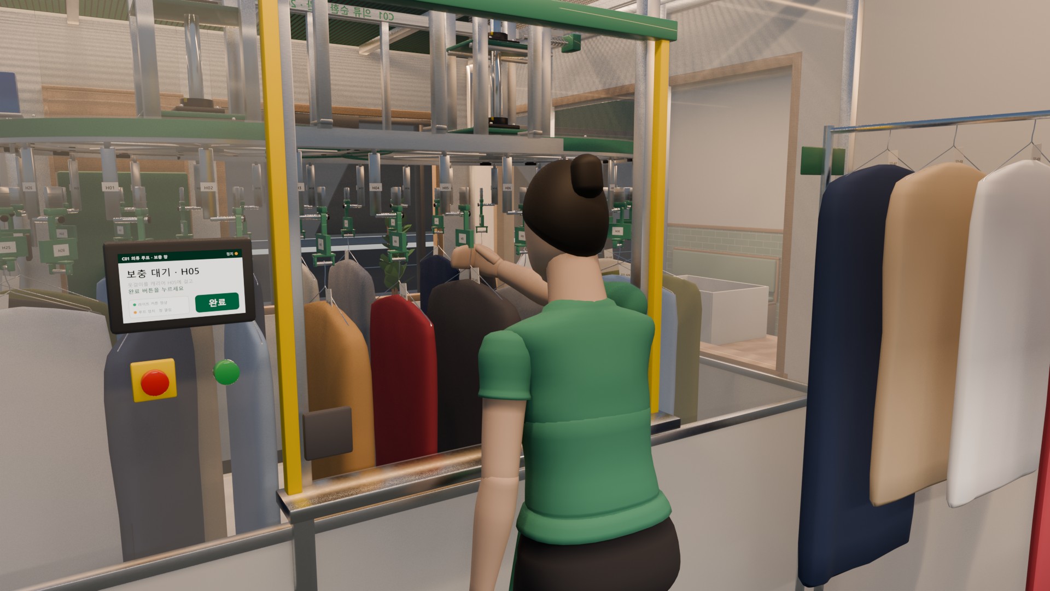
[picture p85: images/v2.0/1_staff_loading/1-3_hang_at_window.jpg]
보충창에 걸기 — 라이트 커튼이 손을 감지하는 동안 체인 구동 차단

<p align="center"><sub>1-3 보충창에 걸기 — 라이트 커튼이 손을 감지하는 동안 체인 구동 차단 (18.3 s · CAM_STAFF_LOOP)</sub></p>

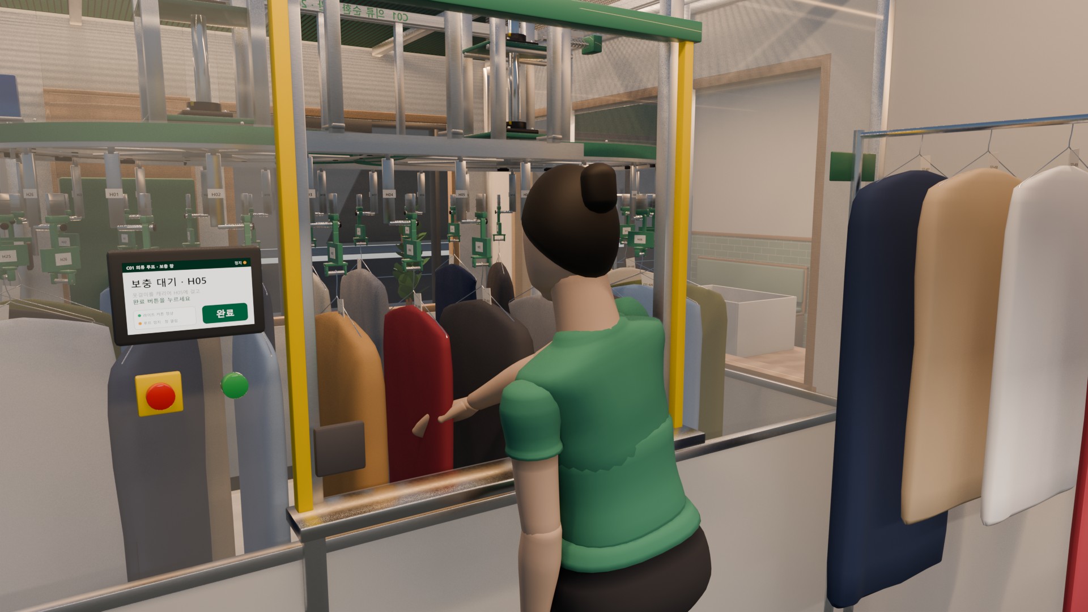
[picture p86: images/v2.0/1_staff_loading/1-4_confirm_stock.jpg]
보충 완료 — 완료 버튼, ID 재확인 뒤 재고 확정

<p align="center"><sub>1-4 보충 완료 — 완료 버튼, ID 재확인 뒤 재고 확정 (20.4 s · CAM_STAFF_LOOP)</sub></p>

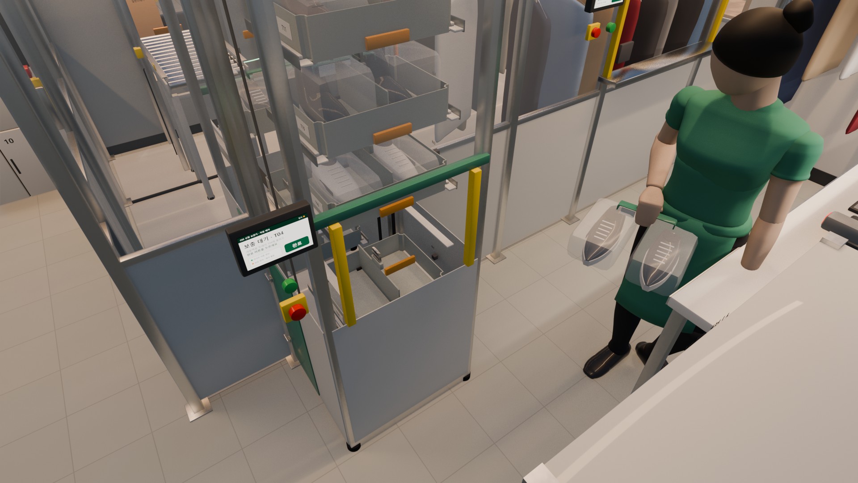
[picture p87: images/v2.0/1_staff_loading/1-5a_tray_to_staff_bay.jpg]
신발 입고 ① — 빈 트레이 T04가 VLM 직원 베이에 나오고, 직원이 새들백을 가져옴

<p align="center"><sub>1-5a 신발 입고 ① — 빈 트레이 T04가 VLM 직원 베이에 나오고, 직원이 새들백을 가져옴 (26.5 s · CAM_STAFF_VLM)</sub></p>

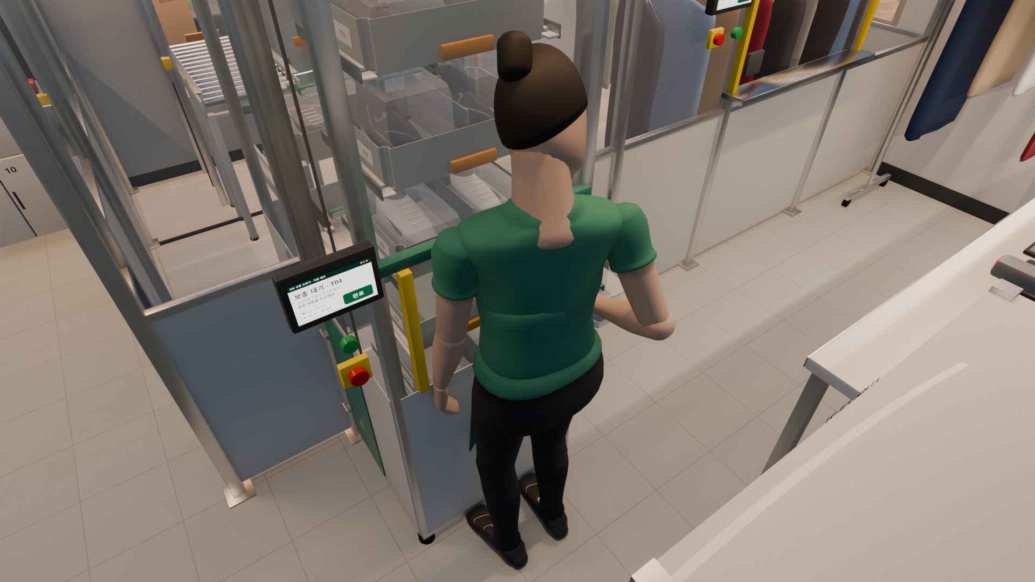
[picture p88: images/v2.0/1_staff_loading/1-5b_place_saddle_bag.jpg]
신발 입고 ② — 새들백을 트레이 칸막이에 걸쳐 올리고 완료 버튼

<p align="center"><sub>1-5b 신발 입고 ② — 새들백을 트레이 칸막이에 걸쳐 올리고 완료 버튼 (30.5 s · CAM_STAFF_VLM)</sub></p>

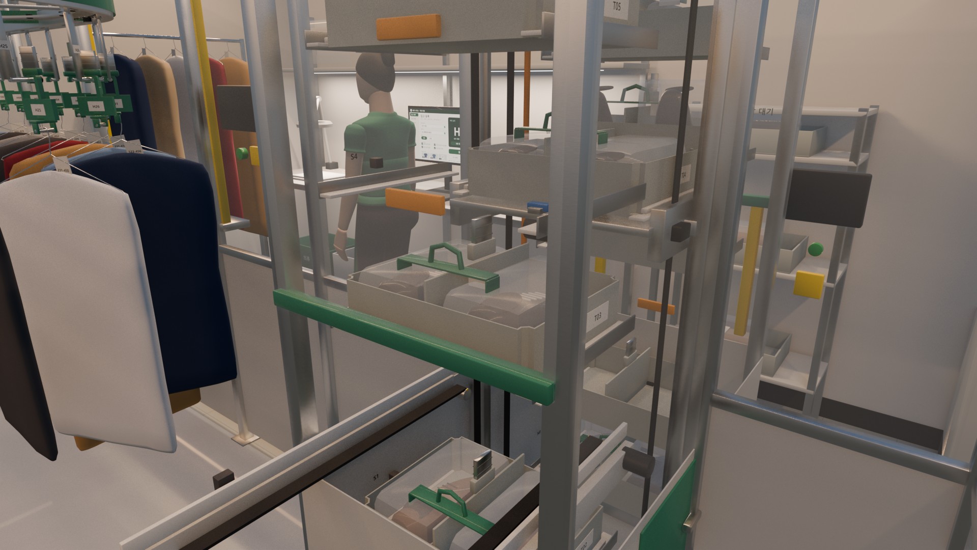
[picture p89: images/v2.0/1_staff_loading/1-6_vlm_auto_store.jpg]
자동 보관 — 승강 플랫폼과 후크 추출기가 T04를 S4 칸에 저장

<p align="center"><sub>1-6 자동 보관 — 승강 플랫폼과 후크 추출기가 T04를 S4 칸에 저장 (38.5 s · CAM_VLM)</sub></p>

## 2. 고객 인증 · 출고 · 수령

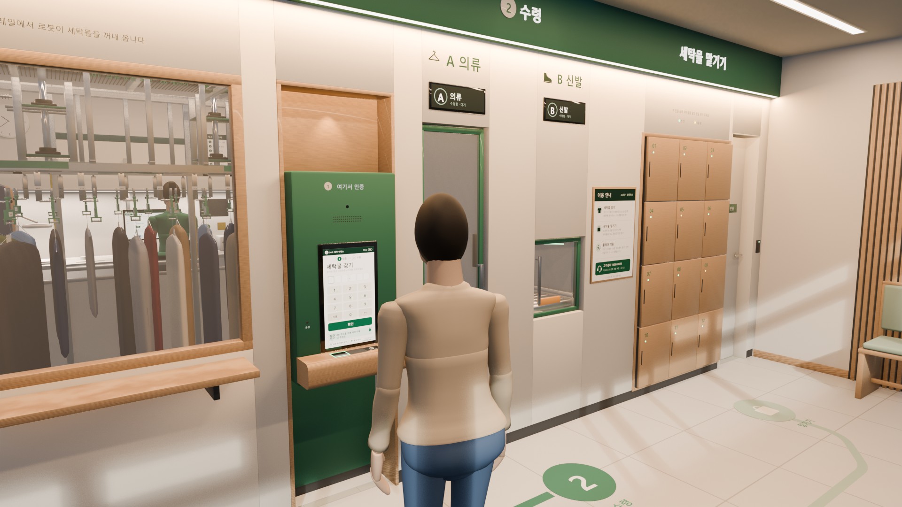
[picture p90: images/v2.0/2_order_pickup/2-1_customer_arrives.jpg]
고객 방문 — 입구에서 바닥 안내선(1 인증 → 2 수령)을 따라 키오스크로

<p align="center"><sub>2-1 고객 방문 — 입구에서 바닥 안내선(1 인증 → 2 수령)을 따라 키오스크로 (44.0 s · CAM_ENTRY)</sub></p>

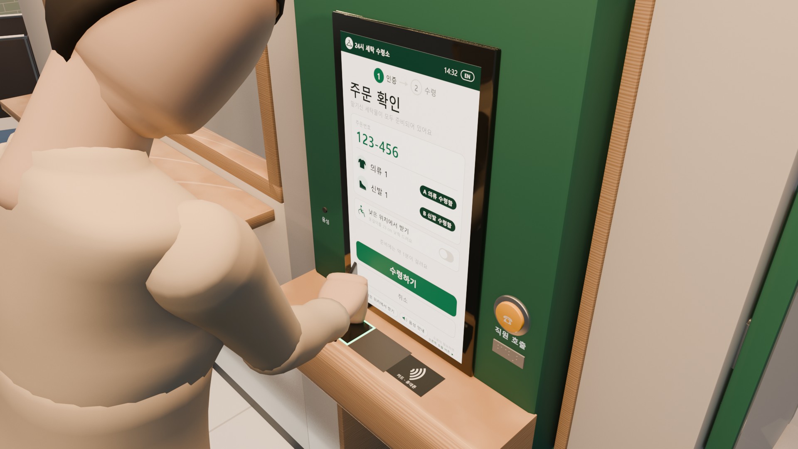
[picture p91: images/v2.0/2_order_pickup/2-2_kiosk_qr.jpg]
QR 인증 — 주문 123-456 확인: 의류 1 · 신발 1

<p align="center"><sub>2-2 QR 인증 — 주문 123-456 확인: 의류 1 · 신발 1 (47.5 s · CAM_KIOSK)</sub></p>

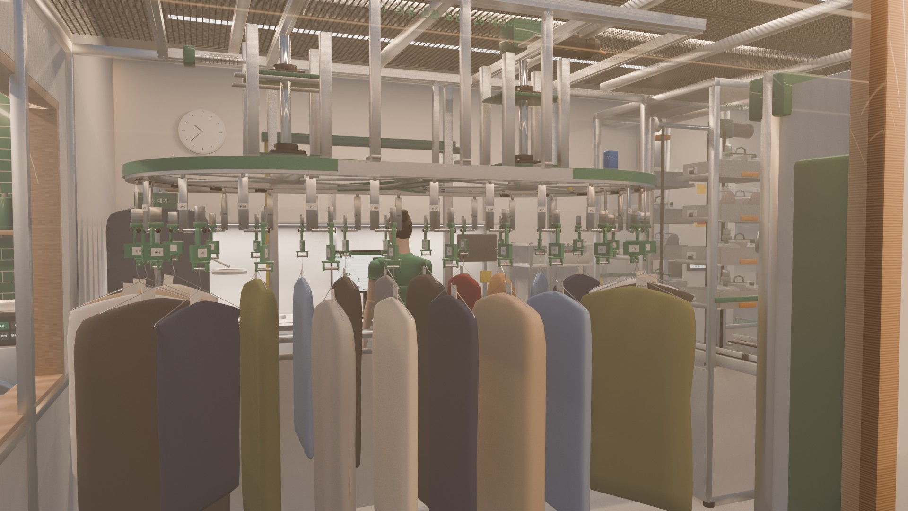
[picture p92: images/v2.0/2_order_pickup/2-3_loop_indexing.jpg]
루프 인덱싱 — H01 캐리어가 픽업 위치로, 인덱스 핀 체결 · RFID 재확인

<p align="center"><sub>2-3 루프 인덱싱 — H01 캐리어가 픽업 위치로, 인덱스 핀 체결 · RFID 재확인 (51.5 s · CAM_VIEWWIN)</sub></p>

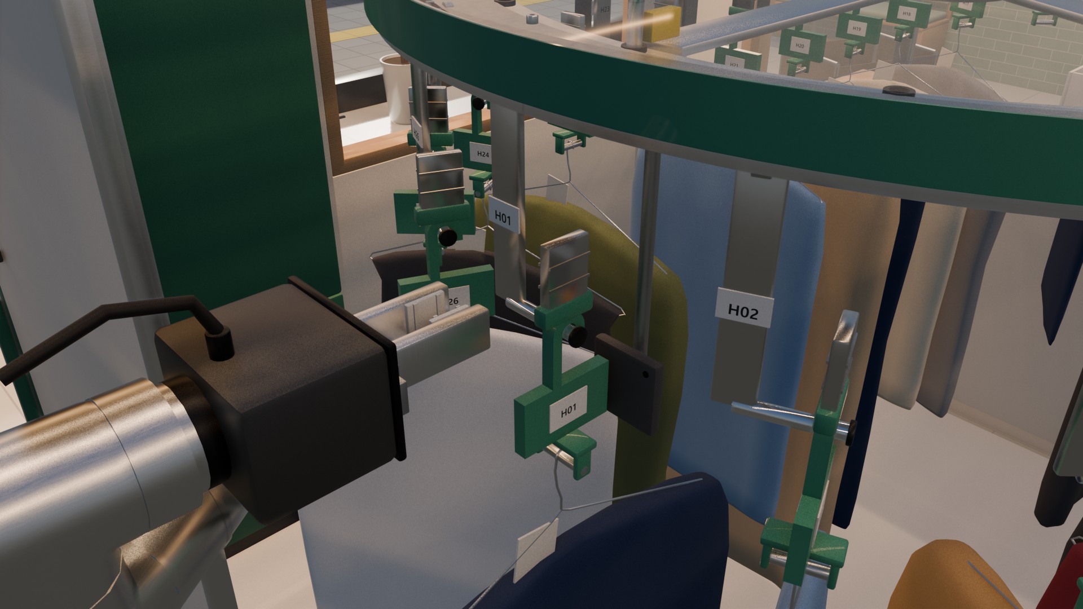
[picture p93: images/v2.0/2_order_pickup/2-4a_robot_tab_grip.jpg]
로봇 파지 — 천이 아닌 어댑터의 10 mm 고정 탭을 잡음

<p align="center"><sub>2-4a 로봇 파지 — 천이 아닌 어댑터의 10 mm 고정 탭을 잡음 (56.5 s · CAM_TIP)</sub></p>

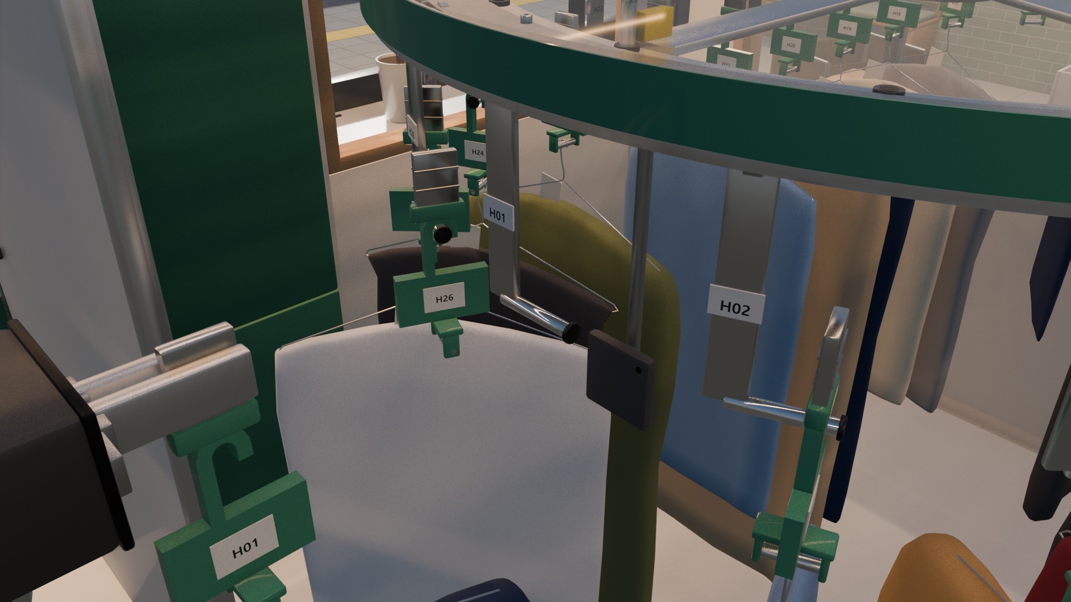
[picture p94: images/v2.0/2_order_pickup/2-4b_liftoff_extract.jpg]
인출 — 28 mm 들어 올려 핀에서 빼고 반지름 방향으로 0.5 m 인출

<p align="center"><sub>2-4b 인출 — 28 mm 들어 올려 핀에서 빼고 반지름 방향으로 0.5 m 인출 (61.0 s · CAM_TIP)</sub></p>

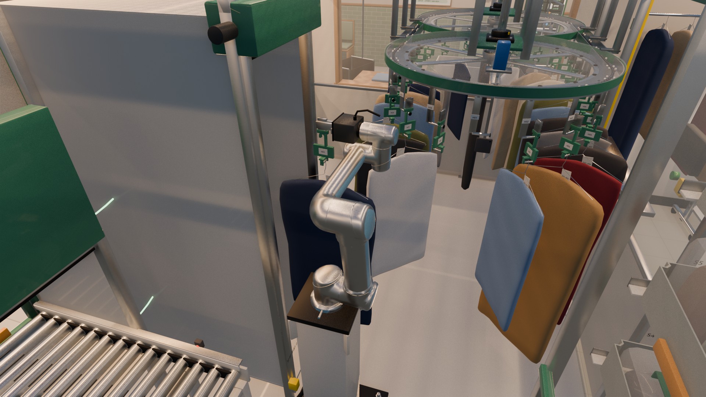
[picture p95: images/v2.0/2_order_pickup/2-5a_rotate_to_a.jpg]
A 인계 ① — 의류를 든 채 90° 회전 이송

<p align="center"><sub>2-5a A 인계 ① — 의류를 든 채 90° 회전 이송 (64.5 s · CAM_ROBOT)</sub></p>

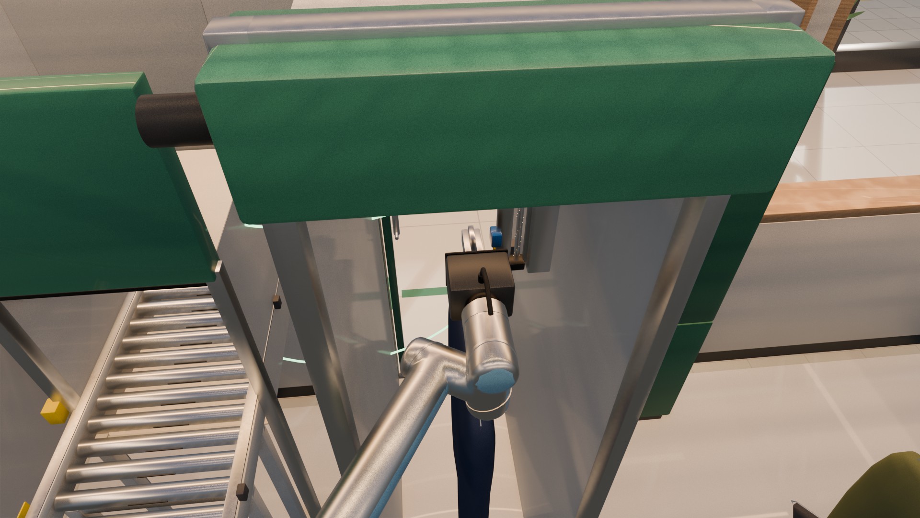
[picture p96: images/v2.0/2_order_pickup/2-5b_place_on_receiver.jpg]
A 인계 ② — 수령 핀에 거치, 래치 체결 뒤 그리퍼 개방

<p align="center"><sub>2-5b A 인계 ② — 수령 핀에 거치, 래치 체결 뒤 그리퍼 개방 (69.0 s · CAM_A_IN)</sub></p>

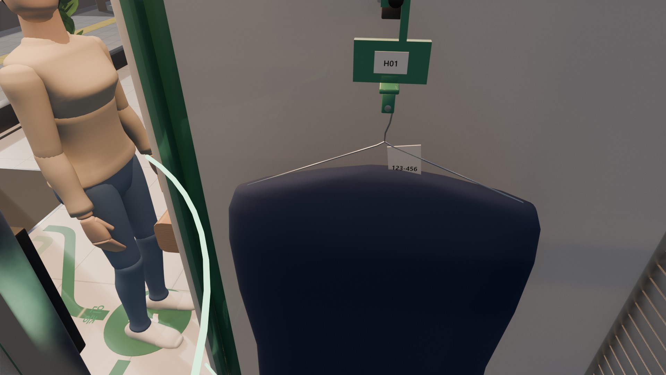
[picture p97: images/v2.0/2_order_pickup/2-5c_y_transfer.jpg]
A 인계 ③ — 내부 셔터가 닫힌 뒤 Y축이 450 mm 이송해 고객문 뒤에 도착 (라이너를 숨긴 단면)

<p align="center"><sub>2-5c A 인계 ③ — 내부 셔터가 닫힌 뒤 Y축이 450 mm 이송해 고객문 뒤에 도착 (라이너를 숨긴 단면) (76.5 s · CAM_A_SECTION)</sub></p>

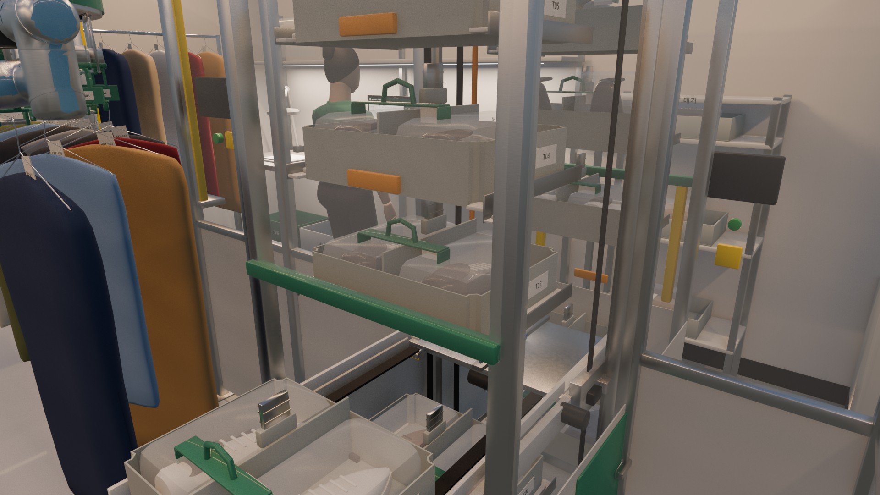
[picture p98: images/v2.0/2_order_pickup/2-6a_vlm_fetch.jpg]
신발 동시 출고 ① — VLM 승강 · 후크 추출로 T01 인출

<p align="center"><sub>2-6a 신발 동시 출고 ① — VLM 승강 · 후크 추출로 T01 인출 (62.0 s · CAM_VLM)</sub></p>

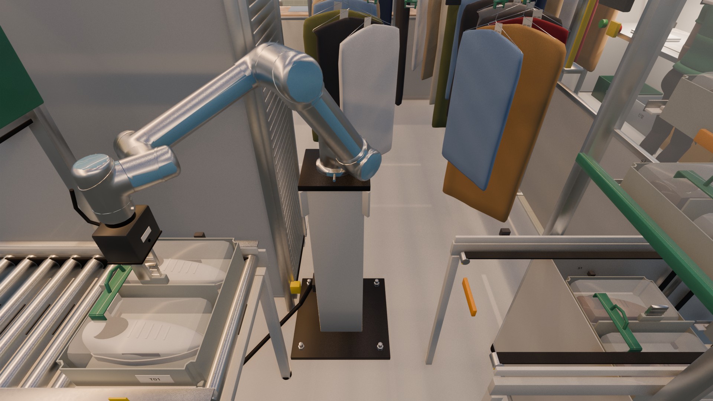
[picture p99: images/v2.0/2_order_pickup/2-6b_port_to_b.jpg]
신발 동시 출고 ② — 포트 컨베이어 → 로봇 → B 롤러 컨베이어

<p align="center"><sub>2-6b 신발 동시 출고 ② — 포트 컨베이어 → 로봇 → B 롤러 컨베이어 (84.0 s · CAM_PORT_B)</sub></p>

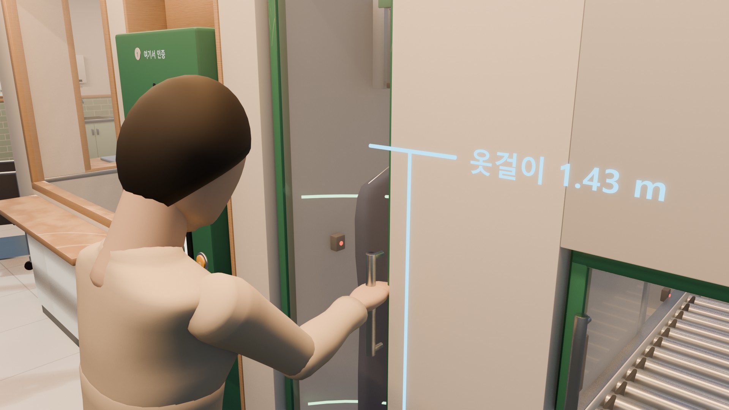
[picture p100: images/v2.0/2_order_pickup/2-7_open_a_door.jpg]
A 문 열기 — 내부 셔터 닫힘 · 잠금 확인 뒤 고객문 해제(양문 인터록)

<p align="center"><sub>2-7 A 문 열기 — 내부 셔터 닫힘 · 잠금 확인 뒤 고객문 해제(양문 인터록) (80.5 s · CAM_A_CUST)</sub></p>

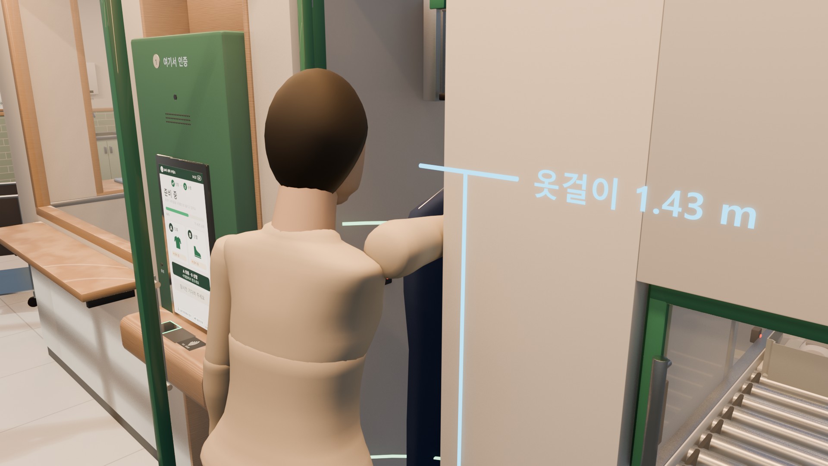
[picture p101: images/v2.0/2_order_pickup/2-8_take_garment.jpg]
의류 수령 — 옷걸이째 꺼냄(걸이 높이 1.43 m), 어댑터는 셀 안에 남음

<p align="center"><sub>2-8 의류 수령 — 옷걸이째 꺼냄(걸이 높이 1.43 m), 어댑터는 셀 안에 남음 (84.5 s · CAM_A_CUST)</sub></p>

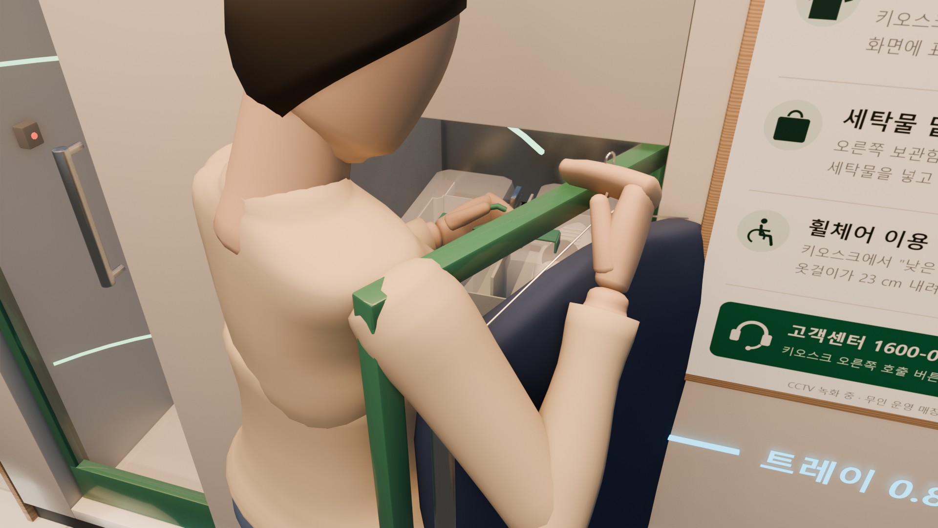
[picture p102: images/v2.0/2_order_pickup/2-9_take_shoes.jpg]
신발 수령 — 트레이 면 0.85 m, 새들백을 한 손으로 꺼냄

<p align="center"><sub>2-9 신발 수령 — 트레이 면 0.85 m, 새들백을 한 손으로 꺼냄 (96.0 s · CAM_B_CUST)</sub></p>

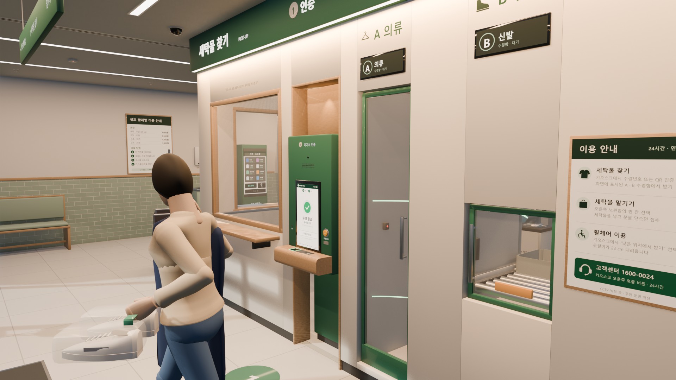
[picture p103: images/v2.0/2_order_pickup/2-10_order_complete.jpg]
수령 완료 — 문 닫힘 · 물품 제거 확인 뒤 주문 완료, 운반구 회수 시작

<p align="center"><sub>2-10 수령 완료 — 문 닫힘 · 물품 제거 확인 뒤 주문 완료, 운반구 회수 시작 (102.0 s · CAM_LOBBY)</sub></p>

## 3. 빈 운반구 회수

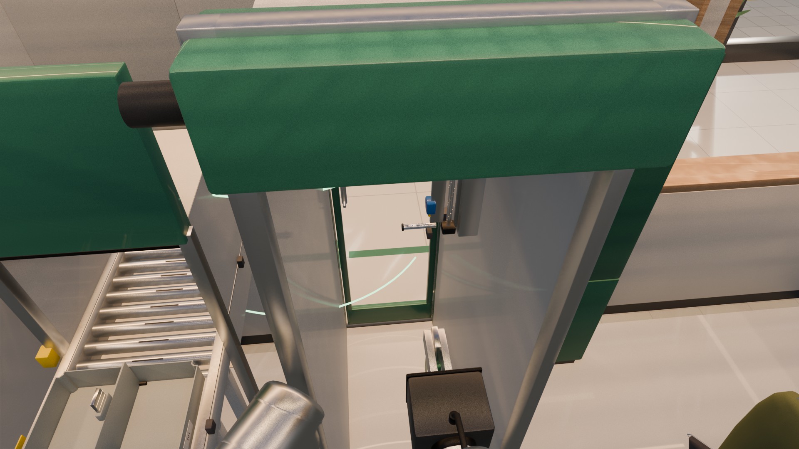
[picture p104: images/v2.0/3_carrier_return/3-1a_adapter_from_a.jpg]
빈 어댑터 회수 ① — A 잠금, Y 복귀, 로봇이 빈 어댑터를 집음

<p align="center"><sub>3-1a 빈 어댑터 회수 ① — A 잠금, Y 복귀, 로봇이 빈 어댑터를 집음 (103.0 s · CAM_A_IN)</sub></p>

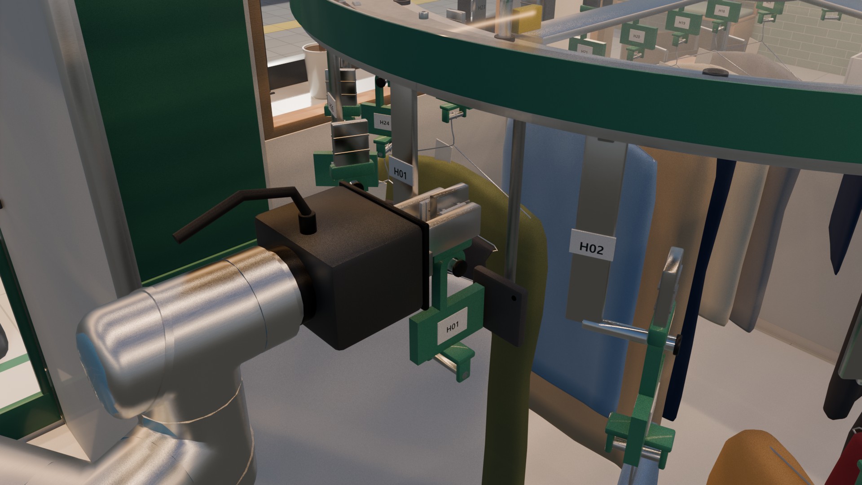
[picture p105: images/v2.0/3_carrier_return/3-1b_rehang_on_h01.jpg]
빈 어댑터 회수 ② — 원래 H01 캐리어 핀에 다시 거치

<p align="center"><sub>3-1b 빈 어댑터 회수 ② — 원래 H01 캐리어 핀에 다시 거치 (112.0 s · CAM_TIP)</sub></p>

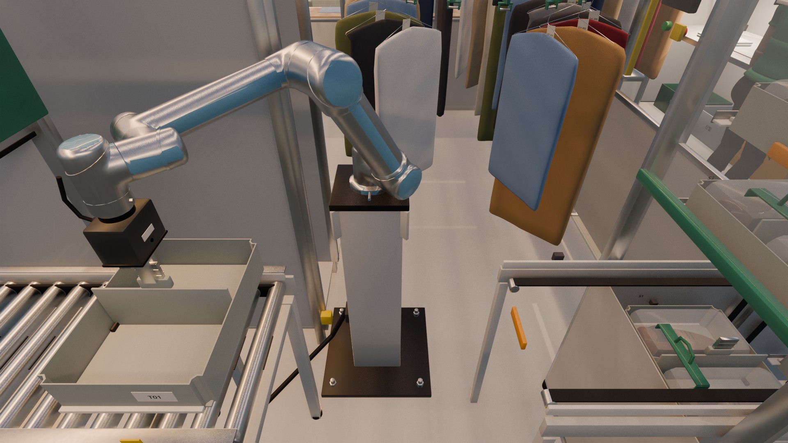
[picture p106: images/v2.0/3_carrier_return/3-2a_tray_back_to_port.jpg]
빈 트레이 회수 ① — B 컨베이어 역송 → 로봇 → VLM 포트

<p align="center"><sub>3-2a 빈 트레이 회수 ① — B 컨베이어 역송 → 로봇 → VLM 포트 (122.5 s · CAM_PORT_B)</sub></p>

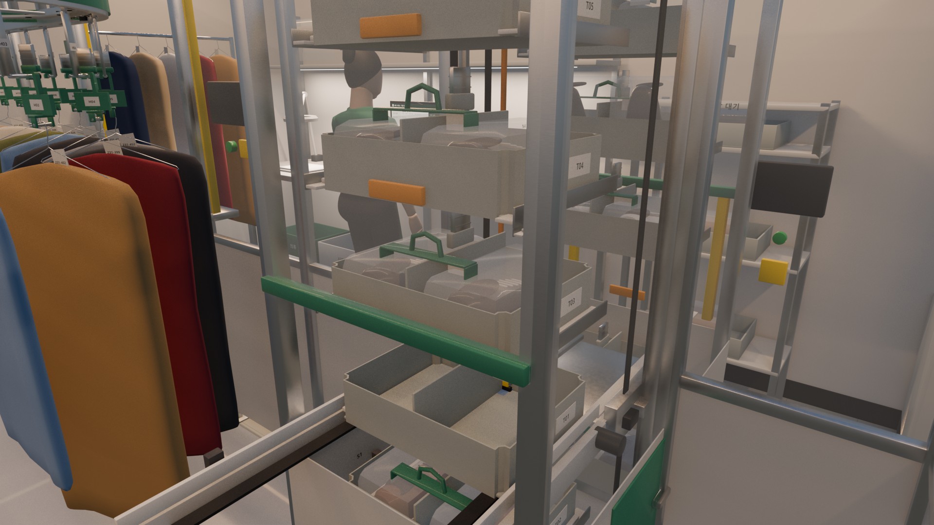
[picture p107: images/v2.0/3_carrier_return/3-2b_tray_to_s0.jpg]
빈 트레이 회수 ② — 추출기가 트레이를 S0 칸으로 되돌림

<p align="center"><sub>3-2b 빈 트레이 회수 ② — 추출기가 트레이를 S0 칸으로 되돌림 (133.0 s · CAM_VLM)</sub></p>

## 4. 접근성 수령 (휠체어)

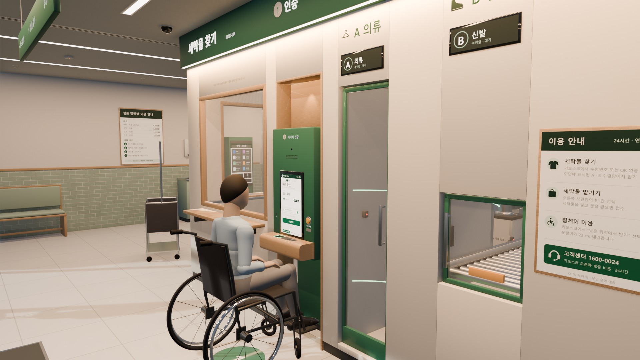
[picture p108: images/v2.0/4_accessible_pickup/4-1a_kiosk_knee_space.jpg]
낮은 위치 모드 ① — 무릎 공간이 있는 키오스크에 휠체어로 정면 접근

<p align="center"><sub>4-1a 낮은 위치 모드 ① — 무릎 공간이 있는 키오스크에 휠체어로 정면 접근 (124.0 s · CAM_LOBBY)</sub></p>

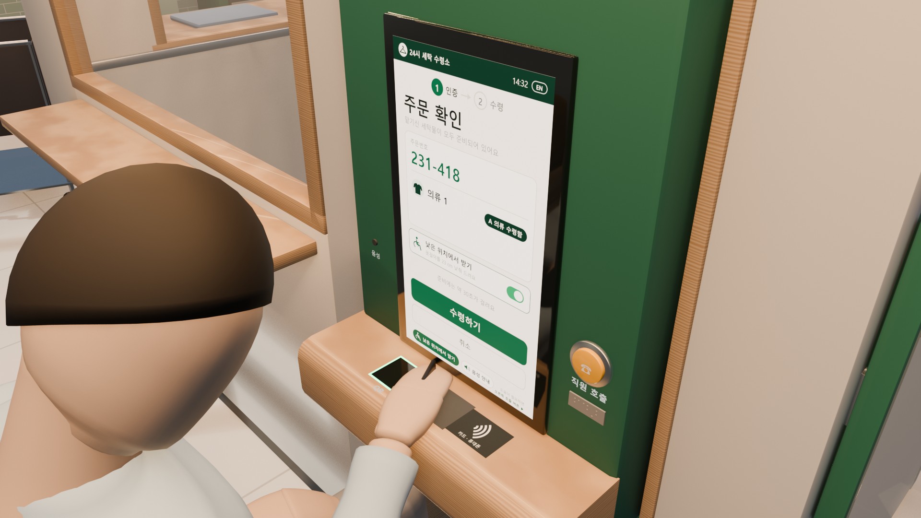
[picture p109: images/v2.0/4_accessible_pickup/4-1b_low_position_select.jpg]
낮은 위치 모드 ② — 주문 231-418 인증, 낮은 위치에서 받기 선택 (조작부 0.4–1.2 m)

<p align="center"><sub>4-1b 낮은 위치 모드 ② — 주문 231-418 인증, 낮은 위치에서 받기 선택 (조작부 0.4–1.2 m) (122.0 s · CAM_KIOSK)</sub></p>

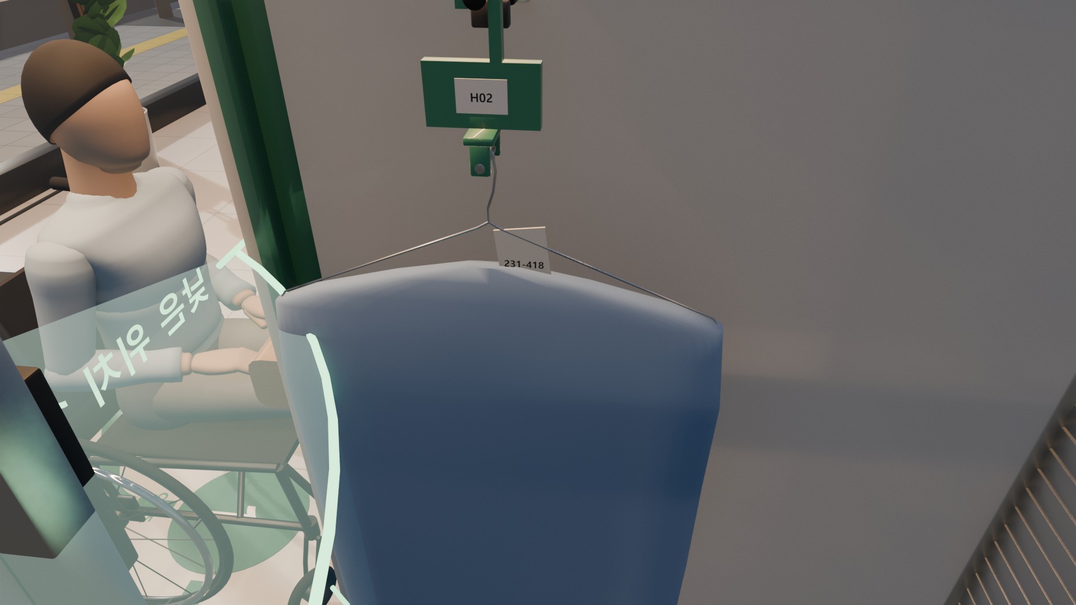
[picture p110: images/v2.0/4_accessible_pickup/4-2_hanger_lowering.jpg]
걸이 23 cm 하강 — Z축 볼스크루가 1.43 m → 1.20 m (라이너를 숨긴 단면)

<p align="center"><sub>4-2 걸이 23 cm 하강 — Z축 볼스크루가 1.43 m → 1.20 m (라이너를 숨긴 단면) (156.7 s · CAM_A_SECTION)</sub></p>

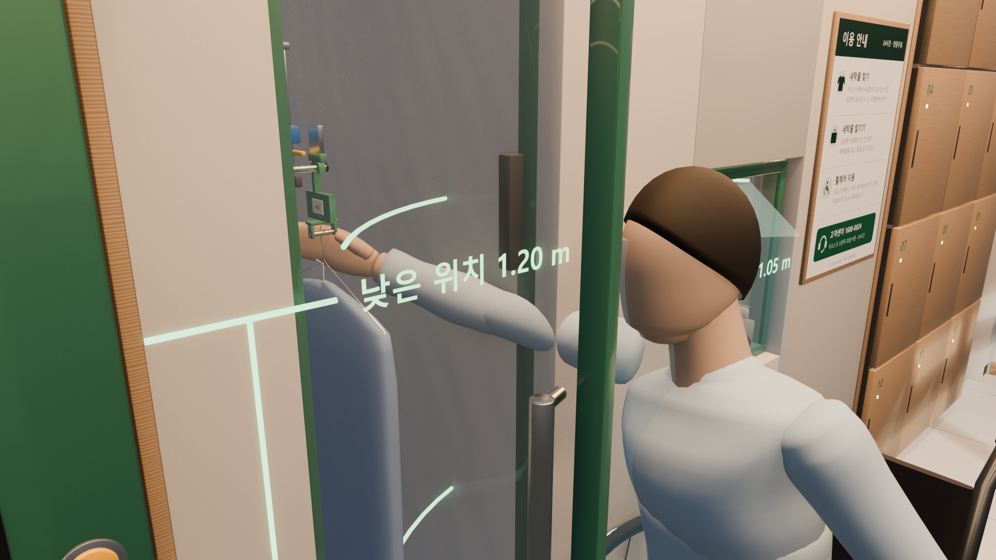
[picture p111: images/v2.0/4_accessible_pickup/4-3_side_reach.jpg]
측면 접근 수령 — 손잡이 1.05 m, 걸이 1.20 m, 회전 공간 1.5 m

<p align="center"><sub>4-3 측면 접근 수령 — 손잡이 1.05 m, 걸이 1.20 m, 회전 공간 1.5 m (171.5 s · CAM_A_WHEEL)</sub></p>

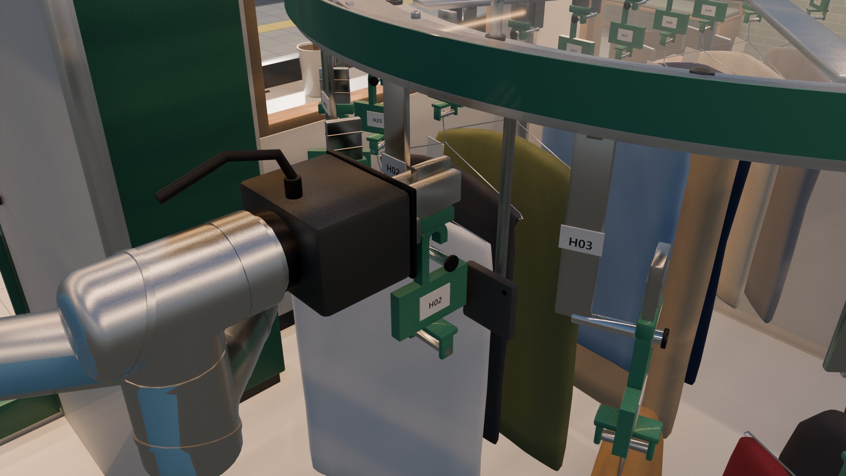
[picture p112: images/v2.0/4_accessible_pickup/4-4_return_home.jpg]
회수 · 원점 복귀 — 빈 어댑터를 H02 캐리어에 재거치

<p align="center"><sub>4-4 회수 · 원점 복귀 — 빈 어댑터를 H02 캐리어에 재거치 (196.0 s · CAM_TIP)</sub></p>

## 5. 정비 모드

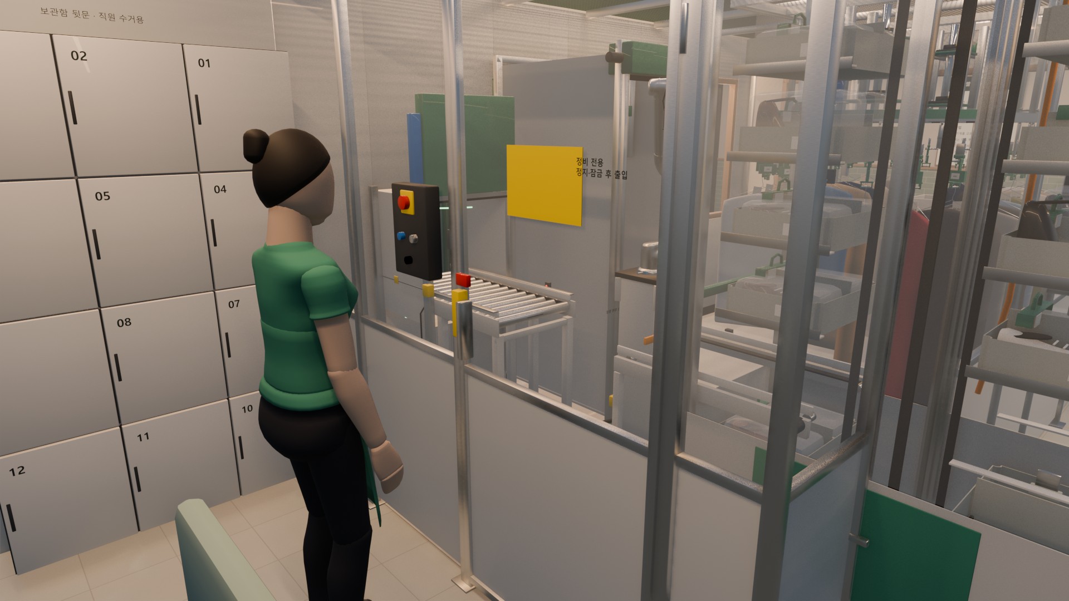
[picture p113: images/v2.0/5_service/5-1_service_key.jpg]
정비 모드 전환 — SERVICE 키, 로봇 원점 · 전 축 정지 확인 뒤 가드 잠금 해제

<p align="center"><sub>5-1 정비 모드 전환 — SERVICE 키, 로봇 원점 · 전 축 정지 확인 뒤 가드 잠금 해제 (204.5 s · CAM_SERVICE)</sub></p>

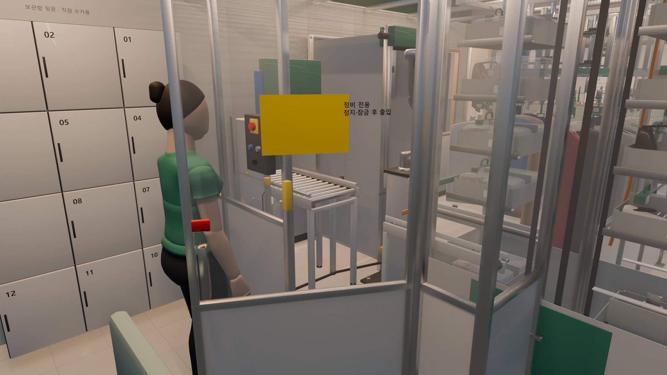
[picture p114: images/v2.0/5_service/5-2a_service_door_open.jpg]
정비 출입 ① — 정비문 개방(바깥 여닫이 60°)

<p align="center"><sub>5-2a 정비 출입 ① — 정비문 개방(바깥 여닫이 60°) (209.1 s · CAM_SERVICE)</sub></p>

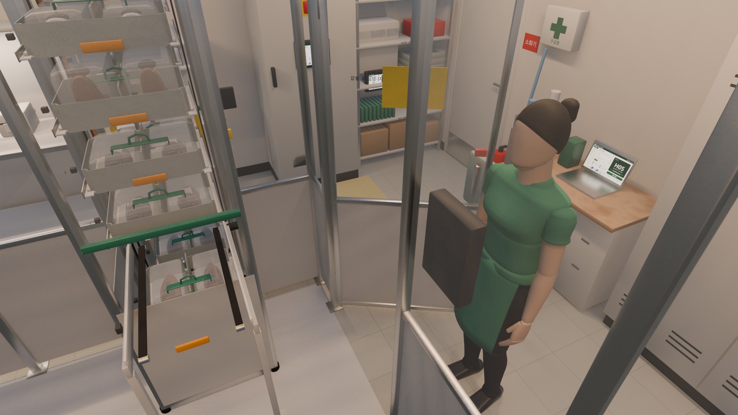
[picture p115: images/v2.0/5_service/5-2b_door_from_inside.jpg]
정비 출입 ② — 셀 안에서 본 열린 정비문과 공구함을 든 정비 담당자

<p align="center"><sub>5-2b 정비 출입 ② — 셀 안에서 본 열린 정비문과 공구함을 든 정비 담당자 (210.5 s · CAM_CELL_SE)</sub></p>

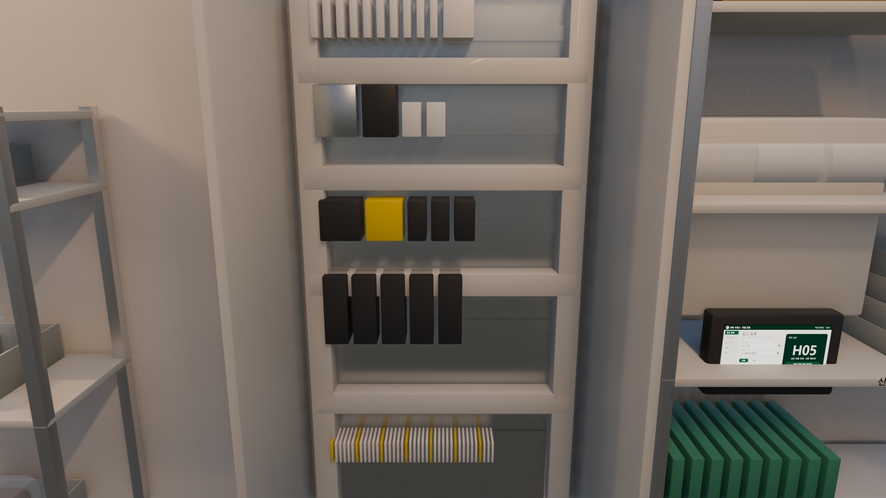
[picture p116: images/v2.0/5_service/5-2c_cabinet_inside.jpg]
정비 출입 ③ — C04 제어반 내부 (문을 연 상태로 렌더) · 셀 안 작업 전 주차단기에 LOTO

<p align="center"><sub>5-2c 정비 출입 ③ — C04 제어반 내부 (문을 연 상태로 렌더) · 셀 안 작업 전 주차단기에 LOTO (209.0 s · CAM_CABINET)</sub></p>

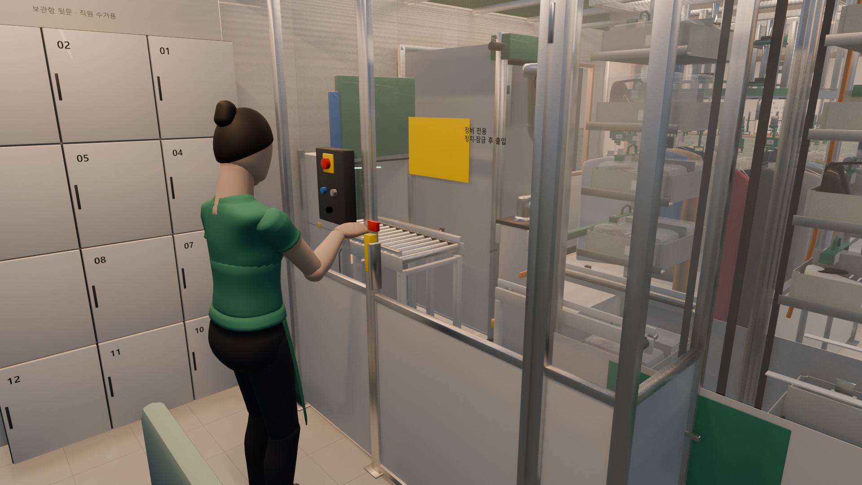
[picture p117: images/v2.0/5_service/5-3_close_and_reset.jpg]
복귀 · 리셋 — 문 닫힘 · 잠금 → AUTO 키 → 리셋(자동 재기동 없음)

<p align="center"><sub>5-3 복귀 · 리셋 — 문 닫힘 · 잠금 → AUTO 키 → 리셋(자동 재기동 없음) (215.5 s · CAM_SERVICE)</sub></p>
