lsy041015/capstone-design-hanyang-university/docs/v2.0_teaser.md

# V2.0 모션스터디 티저 — 샷별 설명

[process_v2.0_teaser_120s_1080p30.mp4](../videos/process_v2.0_teaser_120s_1080p30.mp4) · 2:00 · 1920×1080 · 30 fps · H.264 + AAC · 챕터 15개 ·
한국어 자막 [process_v2.0_ko.srt](../videos/process_v2.0_ko.srt)(외부 자막, 영상에는 넣지 않음) · 검증 기록 [v2.0_video_verification.json](v2.0_video_verification.json)

V2.0 통합 시연 모델(내부 버전 v8)의 **1:1 마스터 타임라인**(6,620프레임, 220.6초)에서 15개 샷을 잘라 만들었습니다.
직원 입고, 고객 인증·수령, 휠체어 사용자의 낮은 위치 수령, 정비 출입까지 사람과 기계가 만나는 지점을 보여 줍니다.
대기 구간만 1.2–2배로 압축했고, 압축한 샷에는 화면에 배속 표시가 붙습니다. 12번 샷(걸이 하강)은 A 수령함 동쪽 라이너만 숨긴
**단면 표현**이며 화면에 그렇게 표시했습니다. 기구는 옮기지 않았습니다.

## 샷 목록

화면 시간은 영상 재생 위치, 마스터 구간은 모델 타임라인 위치입니다. 둘 다 측정한 설비 사이클 타임이 아닙니다.

| # | 화면 시간 (s) | 샷 | 카메라 | 마스터 구간 (s) | 배속 |
|---|---|---|---|---|---|
| 1 | 0–6 | 오프닝 · 거리 파사드 | `CAM_STREET` | 0.0–6.0 | 1 |
| 2 | 6–14 | 매장 구조 · 절개 조감 | `CAM_ISO` | 37.5–45.5 | 1 |
| 3 | 14–26 | 직원 의류 보충 (라이트 커튼, RFID) | `CAM_STAFF_LOOP` | 8.7–20.7 | 1 |
| 4 | 26–34 | 직원 신발 보충 (VLM 베이) | `CAM_STAFF_VLM` | 25.1–41.1 | 2 |
| 5 | 34–41 | 고객 방문 | `CAM_ENTRY` | 38.0–45.0 | 1 |
| 6 | 41–47 | 키오스크 QR 인증 | `CAM_KIOSK` | 44.5–50.5 | 1 |
| 7 | 47–56 | 루프 인덱싱 · 탭 파지 | `CAM_TIP` | 51.0–60.0 | 1 |
| 8 | 56–64 | 인출 · 90° 이송 · A 거치 | `CAM_ROBOT` | 60.0–76.0 | 2 |
| 9 | 64–70 | 신발 포트 → B 컨베이어 | `CAM_PORT_B` | 75.6–87.6 | 2 |
| 10 | 70–81 | A 의류 수령, 높이 표시 | `CAM_A_CUST` | 77.7–88.7 | 1 |
| 11 | 81–89 | B 신발 수령 | `CAM_B_CUST` | 89.4–97.4 | 1 |
| 12 | 89–94 | 걸이 23 cm 하강 (단면) | `CAM_A_SECTION` | 151.7–159.2 | 1.5 |
| 13 | 94–102 | 휠체어 측면 접근 | `CAM_A_WHEEL` | 163.2–174.4 | 1.4 |
| 14 | 102–111 | 정비 모드 · 가드 잠금 | `CAM_SERVICE` | 203.7–214.5 | 1.2 |
| 15 | 111–120 | 요약 · 동선 트레일 | `CAM_ISO` | 211.4–220.4 | 1 |

## 내레이션

Windows Microsoft Heami Desktop 한국어 합성 음성입니다. 시작 시각은 화면 시간입니다.

| 시작 (s) | 대사 |
|---:|---|
| 0.6 | 세탁이 끝난 옷과 신발을, 스물네 시간 찾아가는 동네 수령소입니다. |
| 6.4 | 고객 로비와 셀프 빨래방, 가운데 보호된 자동화 셀, 뒤쪽 직원 공간으로 동선을 나눴습니다. |
| 14.6 | 직원은 검수한 의류를 보충창의 빈 어댑터에 겁니다. 손이 들어가면 체인은 멈춥니다. |
| 26.4 | 신발은 새들백에 담아 트레이에 올리고, 수직 보관기가 빈 칸에 넣습니다. |
| 36.0 | 고객은 QR이나 수령번호로 인증합니다. 주문이 확인되면 준비가 바로 시작됩니다. |
| 47.4 | 행거가 캐리어를 픽업 위치로 돌려 잠그면, 로봇은 옷이 아닌 어댑터의 고정 탭만 잡습니다. |
| 56.4 | 들어 올려 빼낸 뒤 방향을 돌려 수령함 걸이에 올리고, 래치가 잡은 뒤에 손을 놓습니다. |
| 64.2 | 그동안 신발 트레이는 수직 보관기에서 포트로 나오고, 로봇이 B 수령함으로 옮깁니다. |
| 71.0 | 내부 셔터가 닫혀야만 고객 문이 열립니다. 옷걸이는 1.43미터, 신발은 0.85미터 높이에서 받습니다. |
| 89.6 | 낮은 위치 모드를 고르면 걸이가 23센티미터 내려와, 휠체어에서도 옆으로 다가가 받을 수 있습니다. |
| 102.4 | 빈 운반구는 제자리로 돌아가고, 정비는 정지와 가드 잠금 해제 뒤에만 출입합니다. |
| 111.6 | 사람은 검수와 보충, 기계는 보관과 인계. 동선이 겹치지 않는 무인 세탁 수령소입니다. |

## 만든 방법

제작 스크립트는 저장소에 없습니다. 순서만 기록합니다.

1. 편집 목록(EDL)이 모델의 이벤트 시각에서 샷마다 마스터 구간을 계산합니다. 모델을 다시 만들면 편집도 따라갑니다.
2. 3,600프레임을 Blender 5.2.1 EEVEE(24 samples, 1920×1080)로 렌더합니다. 조감 샷에서는 천장과 상부 파사드 컬렉션을 숨깁니다.
3. 3D 주석점(걸이 높이, 라이트 커튼, 인덱스 휠 등)을 각 샷 카메라의 화면 좌표로 투영해 그래픽 위치를 정합니다.
4. 그래픽(상단 바, 장 표시, 하단 자막, 배속·단면 표시, 주석, 오프닝·엔딩 카드, 진행 막대)을 ASS 자막으로 만들어 영상에 입힙니다.
5. 내레이션과 NumPy 합성 배경음을 섞고(내레이션 구간 자동 감쇠), FFmpeg로 H.264·AAC 인코딩과 음량 정규화(−16 LUFS)를 합니다.

## 표현의 한계

- 사람은 동선·도달 검토용 양식화 인형입니다. 옷의 흔들림은 강체로 근사했습니다.
- 1:1 시간은 가정 축 속도로 계산한 값이며, 압축 샷은 표시했습니다. 측정된 처리 속도가 아닙니다.
- 로봇은 FR5e 적용 검토용 UR5 대체 형상입니다. 설계 신호·인터록은 Blender 논리 상태로만 표현했고, 실제 PLC·안전 회로·QR 서버는 없습니다.
- 시연 용량(의류 26, 신발 12)은 상용 매장 용량이나 사업성 가정이 아닙니다.
