lsy041015/capstone-design-hanyang-university/docs/v7_process_teaser.md

# v7 공정 설명 티저

[영상 보기](../videos/process_v7_teaser_120s_1080p30.mp4) · [프로젝트 소개](../README.md) · [한국어 자막](../videos/process_v7_ko.srt) · [English subtitles](../videos/process_v7_en.srt)

v7 공정 티저

## 프로젝트 컨셉

직원이 검수·포장·등록한 세탁 완료품을 보관하고, 고객 인증 후 해당 의류와 신발을 전달하는 소형 무인 수령 시스템이다. 고객이 물품을 가져간 뒤에는 빈 어댑터와 트레이를 회수한다. 시연 모델의 용량은 **의류 8슬롯·신발 트레이 4개·공용 직원 보충구 1개**다.

영상은 v7의 기구 형상을 사용한 **120초·1920×1080·30 fps·3,600프레임** 공정 설명이다. 한국어 설명 그래픽과 Microsoft Heami 합성 내레이션을 넣었다. 영문 자막과 한국어 대사는 별도 SRT로 제공하며, 필요한 언어의 파일을 재생기에서 함께 연다. 한국어 화면에 영문이 자동으로 겹치지 않도록 MP4 내부 자막 트랙은 넣지 않았다.

## 장면별 공정 설명

시간은 영상 재생 위치이며 설비의 실제 소요 시간이 아니다. C01~C07은 [프로젝트 기구 구분](../README.md#system-architecture)과 같다.

| 시간 | 공정 | 동작과 확인 조건 |
|---|---|---|
| 00:00–00:05 | 프로젝트 소개 | 보관·인증·출고·운반구 회수의 전체 셀과 시연 용량을 소개한다. |
| 00:05–00:12 | C07 직원 의류 보충 | 직원이 등록한 의류를 보충구 어댑터에 건다. 문이 열려 있는 동안 로봇은 정지한다. 문 닫힘·잠금·작업자 리셋을 요구한 뒤 C05가 어댑터를 집는다. |
| 00:12–00:16 | C01 의류 입고 | 어댑터를 빈 캐리어 지지부에 내려놓고 파지를 해제한다. 안착·물품 ID·슬롯 위치를 확인한 뒤 재고를 확정하는 설계다. 보충구에서 저장부까지의 이동은 컷 전환으로 요약했다. |
| 00:16–00:23 | C07 직원 신발 보충 | 접이식 선반에 표준 트레이를 놓고 신발을 적재한다. 작업자가 문을 닫고 리셋하면 로봇이 트레이 손잡이를 잡아 들어 올린다. |
| 00:23–00:28 | C03 신발 보관 | 승강대의 3단 포크가 트레이를 S02 위치로 밀어 넣고, 내려놓은 후 빠져나온다. 보충구·인피드 구간은 컷 전환으로 요약했다. |
| 00:28–00:33 | 고객 인증·예약 | 수령번호 또는 QR로 주문과 물품 위치를 확인하고 해당 재고를 예약하는 흐름을 설명한다. 화면은 목업이며 인증 서버와 연결돼 있지 않다. |
| 00:33–00:38 | C01 의류 인덱싱 | 요청한 의류의 캐리어를 로봇 픽업 위치로 보낸다. 정위치 잠금과 물품 ID 재확인 후 다음 동작을 허용한다. |
| 00:38–00:43 | C05 의류 파지 | 옷감을 직접 잡지 않고 단단한 어댑터 탭을 집는다. 파지 확인 후 지지 핀 위로 들어 올린다. |
| 00:43–00:48 | C02 수령대 인계 | 로봇이 어댑터를 수령대 받침에 내려놓는다. 받침이 하중을 인수하고 유지 래치가 잡은 다음 그리퍼가 열린다. |
| 00:48–00:54 | C02 Y–Z 이송 | 수령대와 Z 모듈이 함께 Y 방향 730 mm 이동한 뒤 Z 방향 300 mm 내려간다. 내부문 닫힘·잠금이 고객문 개방의 선행 조건이다. |
| 00:54–00:59 | C06 의류 수령 | 고객은 옷걸이와 의류를 가져간다. 운반 어댑터는 수령대에 남는다. 물품 제거와 고객문 닫힘을 확인해야 회수를 시작한다. |
| 00:59–01:05 | 빈 어댑터 회수 | 고객문이 잠긴 뒤 수령대가 복귀한다. 로봇이 빈 어댑터를 들어 원래 H05 캐리어에 재장착한다. |
| 01:05–01:12 | C03 신발 인출·승강 | 포크가 600 mm 뻗어 트레이를 받친다. 20 mm 들어 올려 회수하고, 승강대가 벨트 인계 높이로 이동한 후 내려놓는다. |
| 01:12–01:17 | C03 인피드 | 연결 롤러가 트레이를 픽업 스토퍼까지 운반한다. 위치·ID를 확인한 뒤 로봇이 손잡이를 집는다. |
| 01:17–01:23 | C05 트레이 중앙 이송 | 받침대를 피하도록 트레이를 들어 올리고 중앙을 통과한다. 출구 롤러에 내려놓은 뒤 파지를 풀고 로봇이 후퇴한다. |
| 01:23–01:28 | C06 신발함 투입 | 외부 셔터가 잠긴 동안 내부 셔터가 열린다. 트레이 진입 후 내부 셔터를 닫고 잠근다. |
| 01:28–01:33 | C06 신발 수령 | 고객이 신발만 가져가고 재사용 트레이는 남긴다. 물품 제거·손 감지 해제·외부 셔터 닫힘을 다음 동작의 조건으로 둔다. |
| 01:33–01:41 | 빈 트레이 반송 | 고객 측 셔터 잠금 후 내부 롤러가 트레이를 반송한다. 로봇이 들어 올려 인피드 롤러에 다시 내려놓는다. |
| 01:41–01:47 | C03 빈 트레이 재입고 | 벨트·승강대·포크가 빈 트레이를 S02로 돌려보낸다. 수령 완료와 빈 운반구 반환 기록을 마쳐 한 주문의 순환을 끝낸다. |
| 01:47–01:54 | C04 제어 조건 | 문 닫힘·잠금, 위치·ID, 파지·안착을 확인한다. 이상이 발생하면 정지 상태를 유지하고 작업자가 확인·리셋하는 조건을 설명한다. |
| 01:54–02:00 | 전체 공정 정리 | 직원 보충부터 고객 수령과 운반구 회수까지 연결된 흐름을 정리한다. |

### 사람과 설비가 맡는 일

직원은 검수, 포장, 물품 등록, 보충구 적재, 이상 확인과 리셋을 담당한다. 고객은 인증 후 의류 또는 신발을 가져간다. 영상에서 물품만 움직이는 보충·수령 장면은 사람의 작업을 생략해 표현한 것이다. 자동으로 옷을 걸거나 신발을 포장하는 기능을 의미하지 않는다.

자동화 셀은 어댑터와 트레이를 통해 보관·인계·수령 위치 이송·빈 운반구 반환을 수행하도록 설계했다. 문 잠금, ID, 물품 존재, 파지 확인은 실제 센서 입력으로 구현해야 하는 허용 조건이며, 영상의 문 애니메이션만으로 실물 안전성이 검증되지는 않는다.

## 검증 범위

| 확인 항목 | 근거와 범위 |
|---|---|
| 기존 v7 원본 보존 | 원본 Blender 파일의 SHA-256을 제작 전후 비교했다. 기존 31개 검사 포즈를 덮어쓰지 않고 별도 영상 파일을 만들었다. |
| 전체 프레임 계산 | 3,600개 명령 위치의 UR5 공칭 역기구학, 의류·신발 양쪽 문의 동시 개방 금지, 직원 보충구 개방 중 로봇 정지, 트레이 파지 오프셋을 검사했다. 공칭 TCP 최대 오차는 약 0.0248 mm다. 이는 수치 계산 잔차다. |
| 저장된 애니메이션 | 새 Blender 파일을 다시 열어 351개 표본 프레임의 TCP, 카메라 전환, Y–Z 연동과 의류 문 상태를 검사했다. 저장 좌표의 최대 TCP 잔차는 약 0.0198 mm다. |
| 선택한 강체 간섭 | 위 표본 프레임에서 표시되는 의류·트레이와 선택한 받침대·프레임·레일·로봇 링크 사이의 삼각형 교차는 검출되지 않았다. 검사 대상과 표본 사이를 포함한 전체 연속 충돌 검사는 아니다. |
| 영상 파일 | 게시 파일의 해상도·프레임 수·음성·자막·챕터·전체 디코딩 결과는 [게시 파일 검증 기록](v7_video_verification.json)에 기록했다. |

공정은 발표용으로 시간 압축했고, 일부 이동은 컷 전환으로 요약했다. 120초를 설비의 사이클 타임으로 사용할 수 없다. 전체 연속 궤적, 로봇 자가 충돌, 유연한 의류 거동, 하중·파지력·정지 거리, FR5e 실제 제어, PLC·독립 안전 회로와 인증 서버는 별도 검증이 필요하다.

## 모델과 자료 출처

FR5e 적용을 검토하는 프로젝트이며, 영상에는 **공식 UR5 CB-series의 단순화된 STL 대체 형상과 공칭 기구학**을 사용했다. UR5 형상이나 사양을 FR5e 성능으로 해석하지 않는다.

- 형상 제공자: [Universal Robots ROS 2 Description](https://github.com/UniversalRobots/Universal_Robots_ROS2_Description/tree/89bbe795f38a7ab00fb66fe8831dfff79dc99edf/meshes/ur5/collision)
- 출처 고정 커밋: `89bbe795f38a7ab00fb66fe8831dfff79dc99edf`
- 모델 라이선스: [BSD-3-Clause 고지](UR5_LICENSE.txt)
- 음성: Windows Microsoft Heami Desktop의 한국어 합성 음성. 별도 배경 음악은 사용하지 않았다.

## 버전 구분

- **v7 티저:** 현재 기구 형상, 21장면, 120초, 의류 8슬롯·트레이 4개·공용 보충구 1개.
- **v7 원본 검사 모델:** 기존 31개 정지 검사 포즈. 티저의 3,600프레임과 번호가 다르다.
- **v4 이전 영상:** 86개 세부 공정, 60초. 이전 형상과 용량을 사용하므로 현재 v7 소개 영상과 구분한다.
