lsy041015/capstone-design-hanyang-university/poc_2.5m_cell/renders/03_drive.jpg

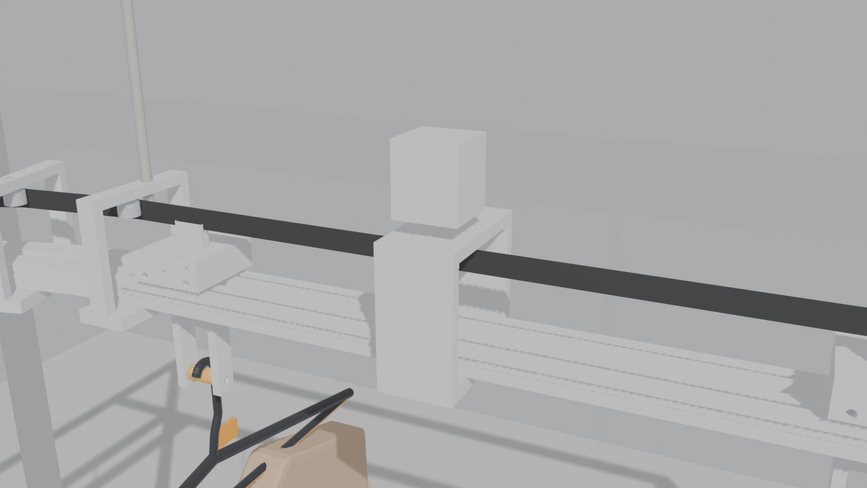
poc_2.5m_cell/renders/03_drive.jpg
