lsy041015/capstone-design-hanyang-university/poc_2.5m_cell/renders/04_pick.jpg

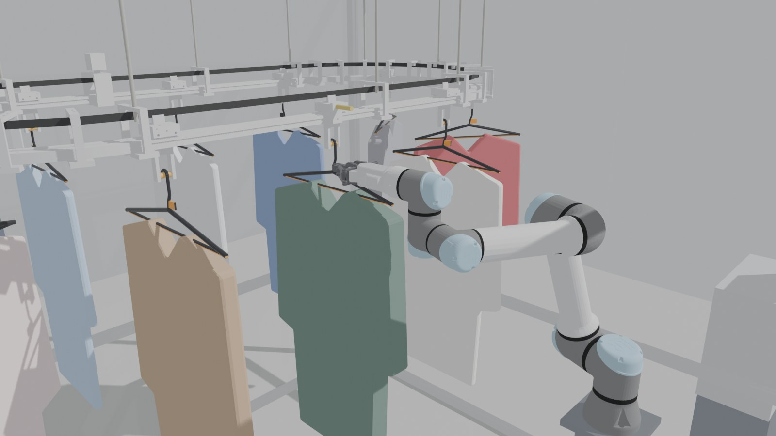
poc_2.5m_cell/renders/04_pick.jpg
