lsy041015/capstone-design-hanyang-university/poc_2.5m_cell/renders/05_pullout_turn.jpg

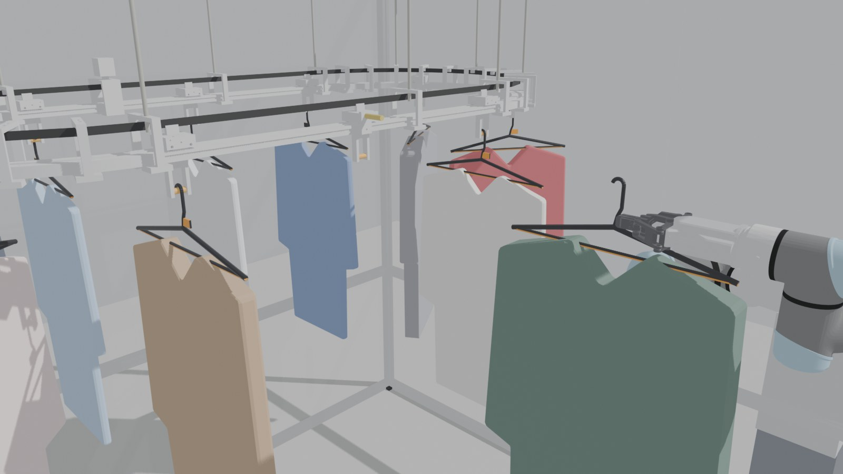
poc_2.5m_cell/renders/05_pullout_turn.jpg
