lsy041015/capstone-design-hanyang-university/poc_2.5m_cell/renders/06_place_shelf.jpg

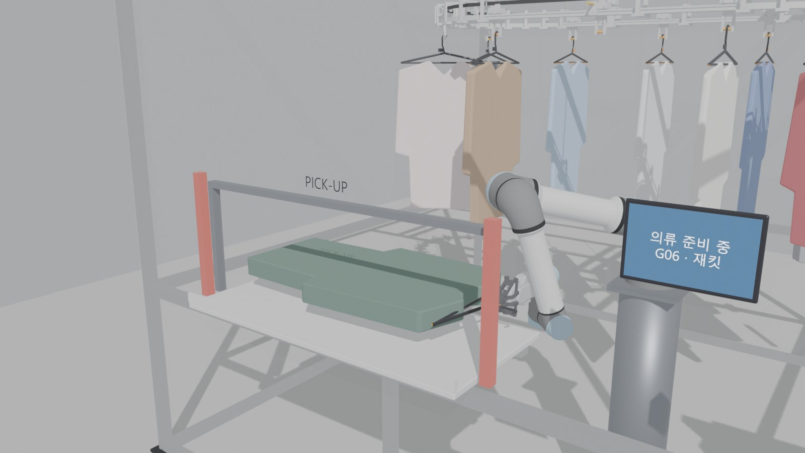
poc_2.5m_cell/renders/06_place_shelf.jpg
