lsy041015/capstone-design-hanyang-university/poc_2.5m_cell/renders/07_customer_pickup.jpg

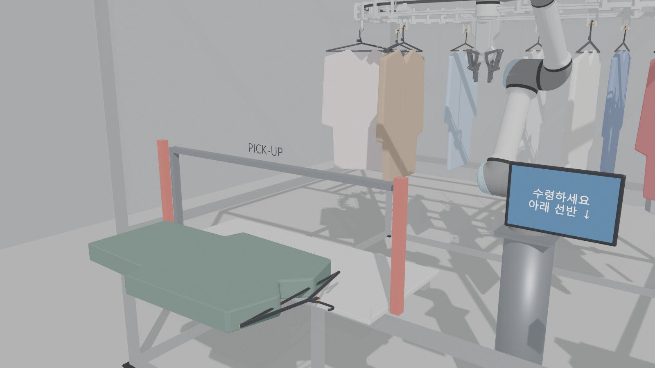
poc_2.5m_cell/renders/07_customer_pickup.jpg
