lsy041015/capstone-design-hanyang-university/poc_2.5m_cell/renders/08_dh_pgc_gripper.jpg

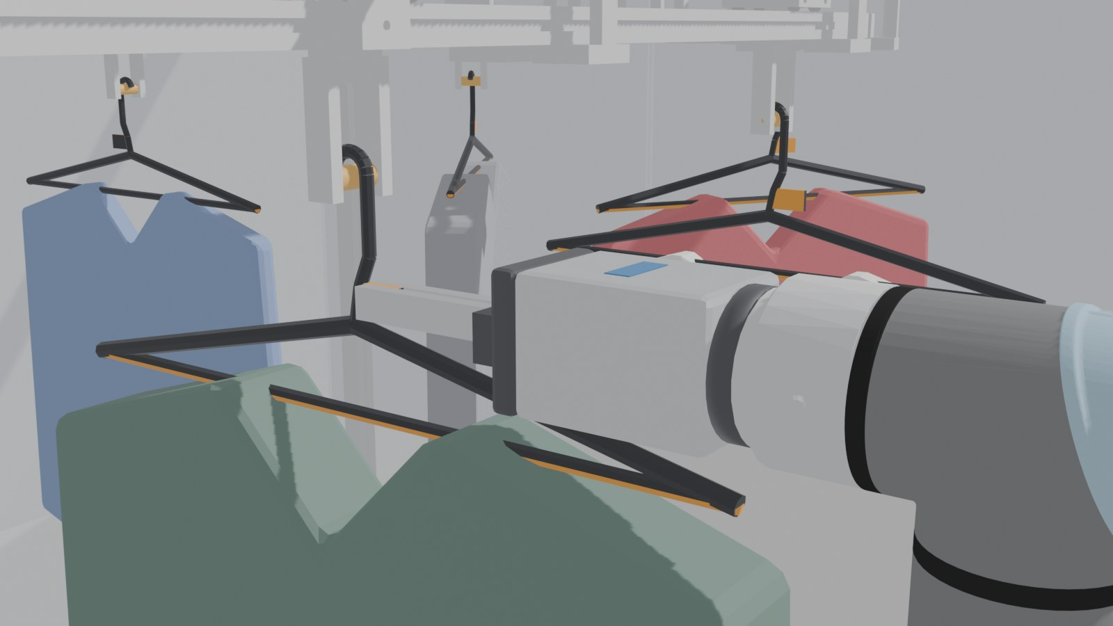
poc_2.5m_cell/renders/08_dh_pgc_gripper.jpg
