lsy041015/capstone-design-hanyang-university/poc_2.5m_cell/renders/center/C02_top.jpg

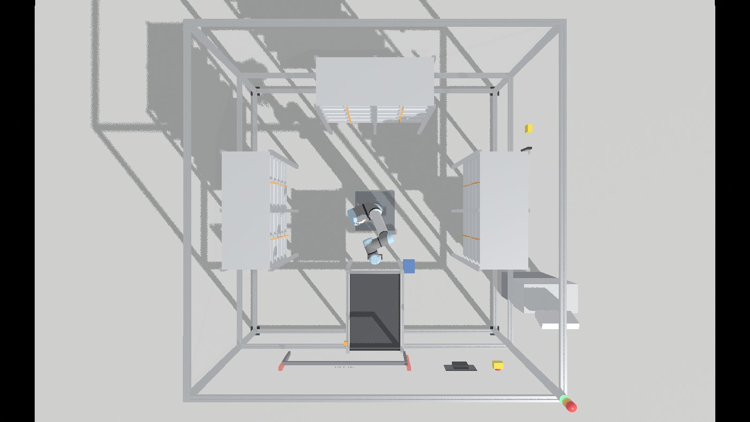
poc_2.5m_cell/renders/center/C02_top.jpg
