lsy041015/capstone-design-hanyang-university/poc_2.5m_cell/renders/center_photo/S03_high_corner_back_right.jpg

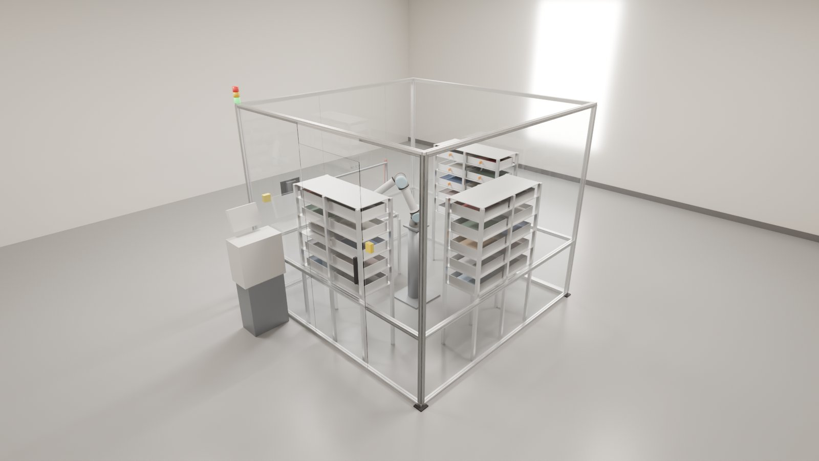
poc_2.5m_cell/renders/center_photo/S03_high_corner_back_right.jpg
