lsy041015/capstone-design-hanyang-university/poc_2.5m_cell/renders/center_photo/S05_left_side.jpg

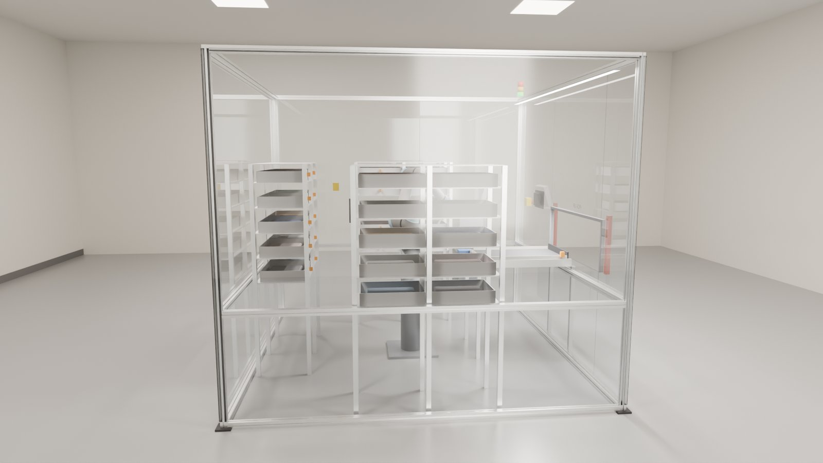
poc_2.5m_cell/renders/center_photo/S05_left_side.jpg
