lsy041015/capstone-design-hanyang-university/poc_2.5m_cell/renders/center_photo/S06_right_side.jpg

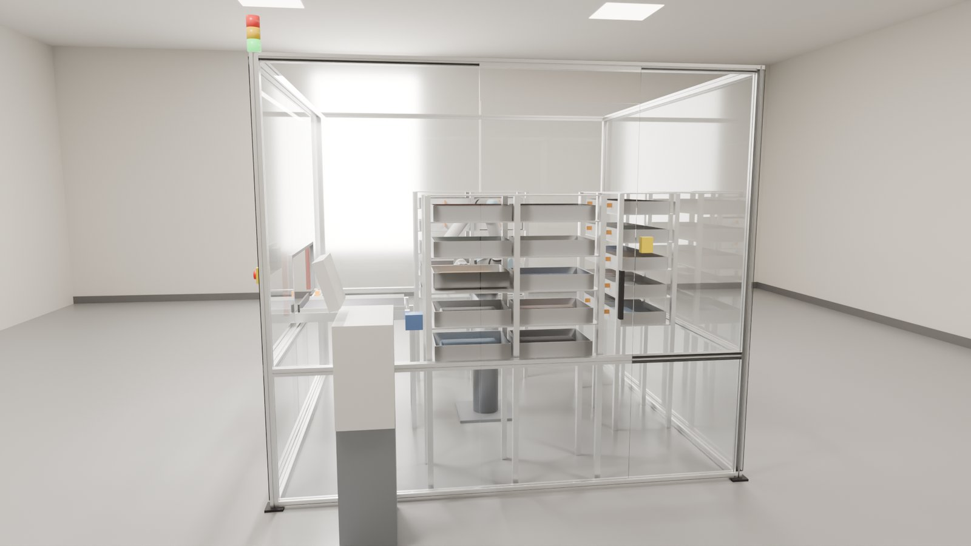
poc_2.5m_cell/renders/center_photo/S06_right_side.jpg
