lsy041015/capstone-design-hanyang-university/poc_2.5m_cell/renders/center_photo/S07_high_back_left.jpg

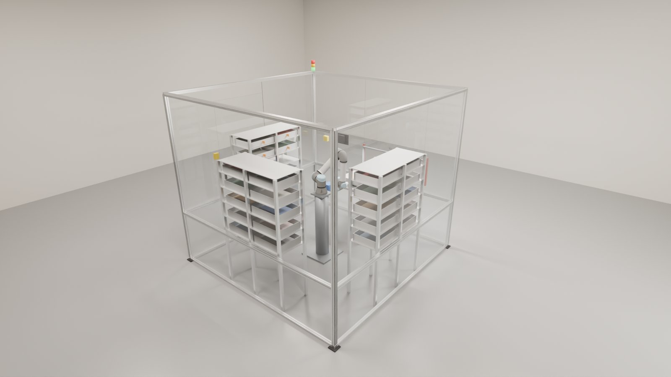
poc_2.5m_cell/renders/center_photo/S07_high_back_left.jpg
