lsy041015/capstone-design-hanyang-university/poc_2.5m_cell/renders/files_photo/F03_high_corner_back_right.jpg

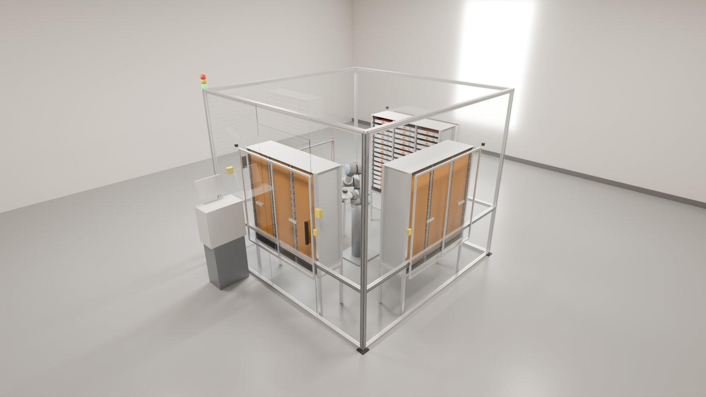
poc_2.5m_cell/renders/files_photo/F03_high_corner_back_right.jpg
