lsy041015/capstone-design-hanyang-university/poc_2.5m_cell/renders/photo/P04_right_service_side.jpg

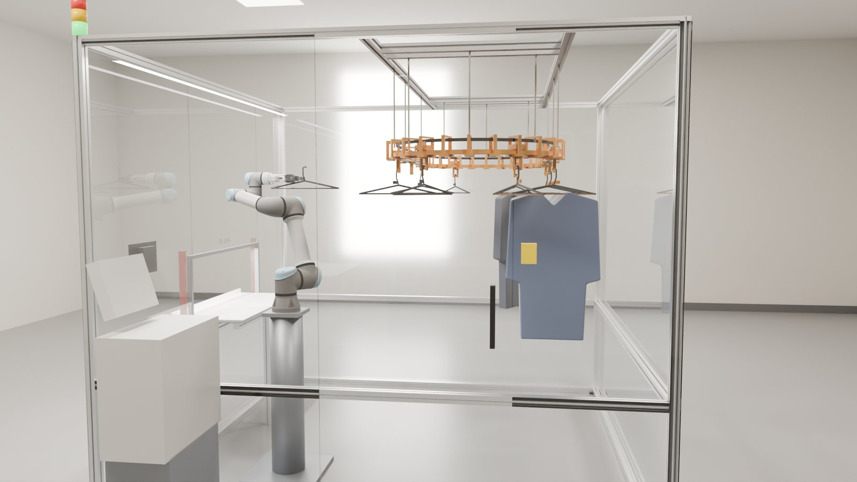
poc_2.5m_cell/renders/photo/P04_right_service_side.jpg
