lsy041015/capstone-design-hanyang-university/poc_2.5m_cell/renders/photo/P07_drive_unit.jpg

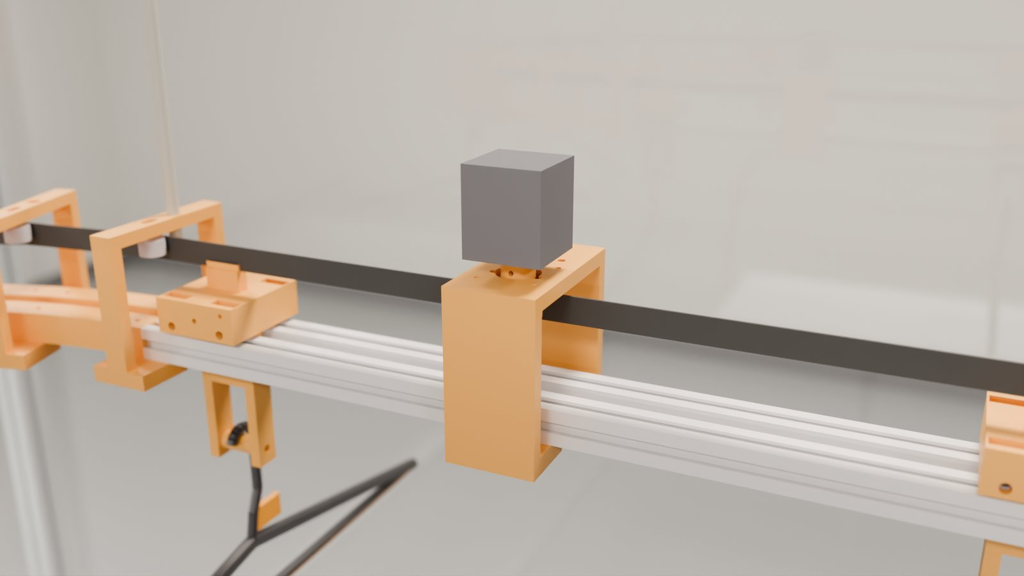
poc_2.5m_cell/renders/photo/P07_drive_unit.jpg
