lsy041015/capstone-design-hanyang-university/poc_2.5m_cell/renders/tray/T02_rack_pick.jpg

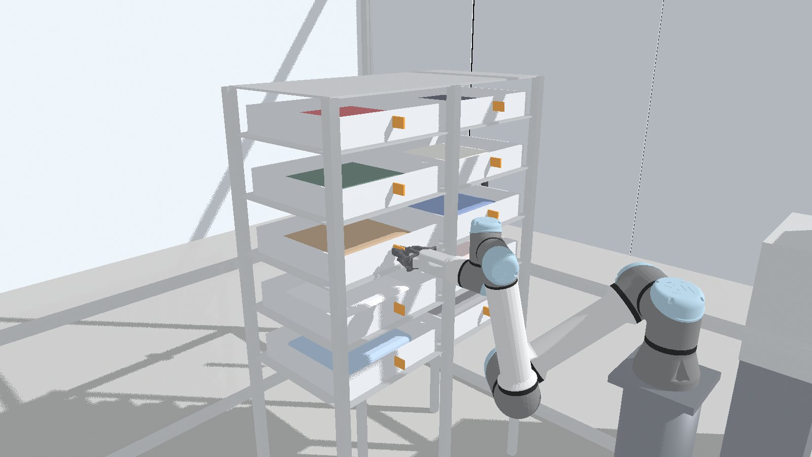
poc_2.5m_cell/renders/tray/T02_rack_pick.jpg
