lsy041015/capstone-design-hanyang-university/poc_2.5m_cell/renders/tray/T05_customer_pickup.jpg

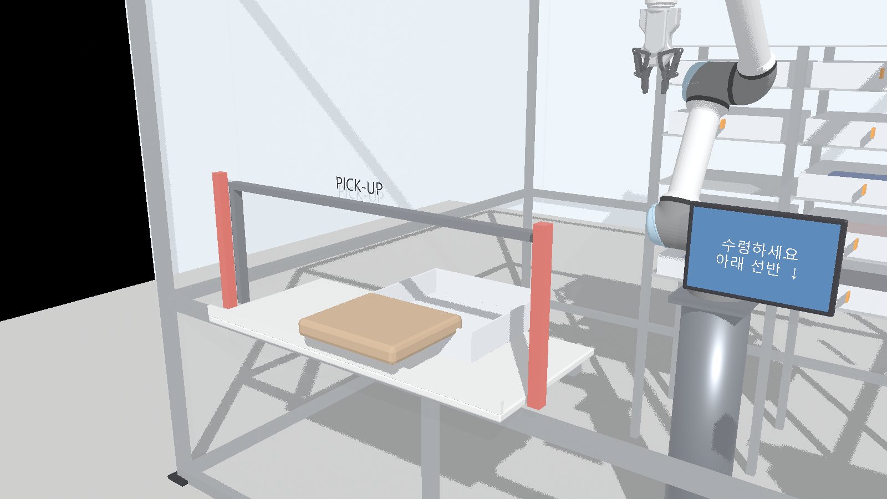
poc_2.5m_cell/renders/tray/T05_customer_pickup.jpg
