lsy041015/capstone-design-hanyang-university/poc_2.5m_cell/cad/step/pc_roller.stp

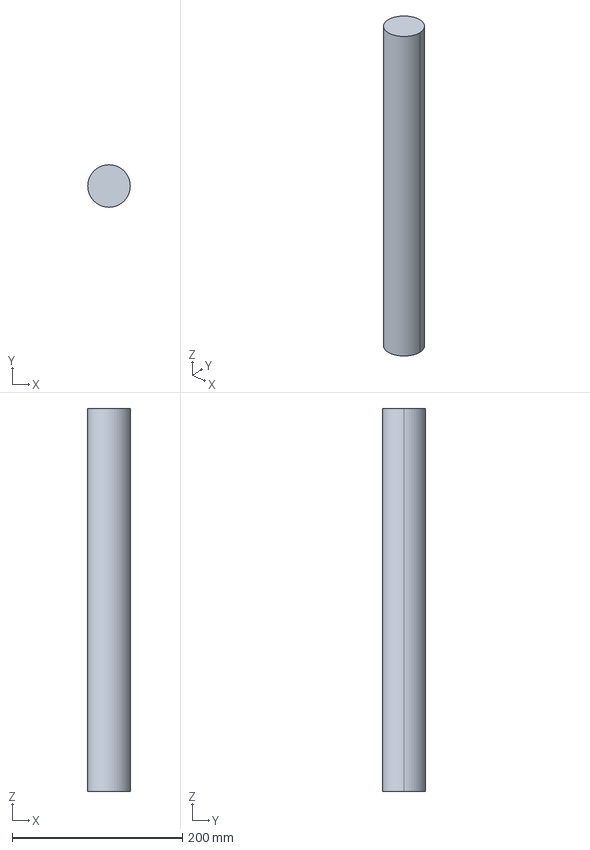
[picture p140: CAD file, 2026-11-13]
poc_2.5m_cell/cad/step/pc_roller.stp
50.0 x 50.0 x 450.0 mm
