lsy041015/capstone-design-hanyang-university/poc_2.5m_cell/cad/step/rk_post_3030_l1550.stp

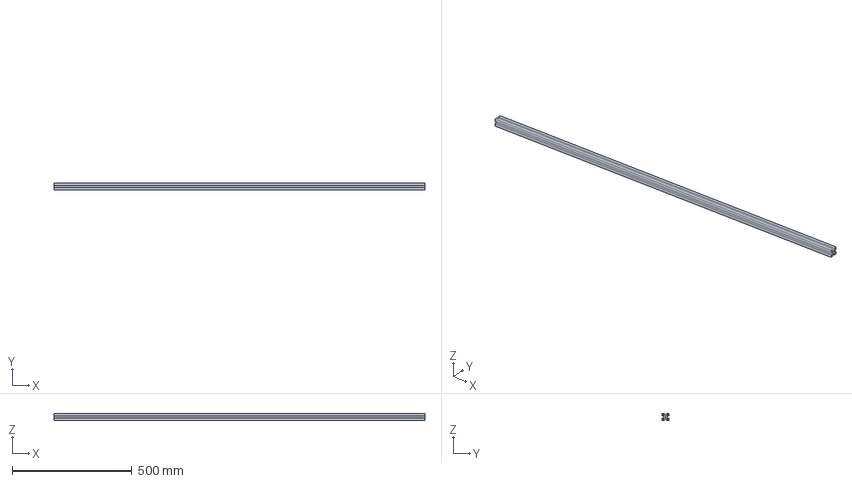
[picture p141: CAD file, 2026-11-13]
poc_2.5m_cell/cad/step/rk_post_3030_l1550.stp
1550.0 x 30.0 x 30.0 mm
