lsy041015/capstone-design-hanyang-university/poc_2.5m_cell/cad/step/pc_guide.stp

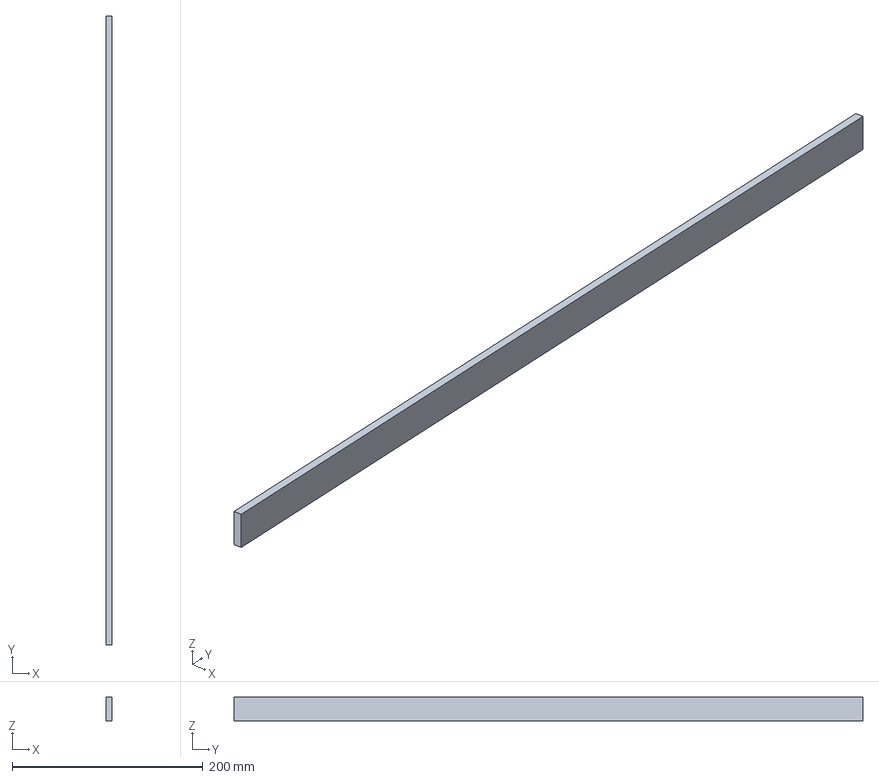
[picture p142: CAD file, 2026-11-13]
poc_2.5m_cell/cad/step/pc_guide.stp
6.00 x 660.0 x 25.0 mm
