lsy041015/capstone-design-hanyang-university/poc_2.5m_cell/cad/step/rk_tray.stp

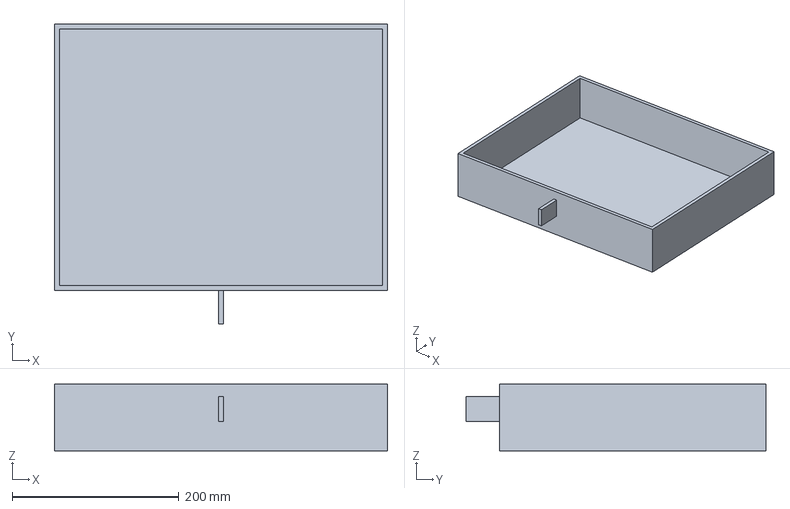
[picture p143: CAD file, 2026-11-13]
poc_2.5m_cell/cad/step/rk_tray.stp
400.0 x 360.0 x 80.0 mm
