lsy041015/capstone-design-hanyang-university/poc_2.5m_cell/cad/step/pc_motor.stp

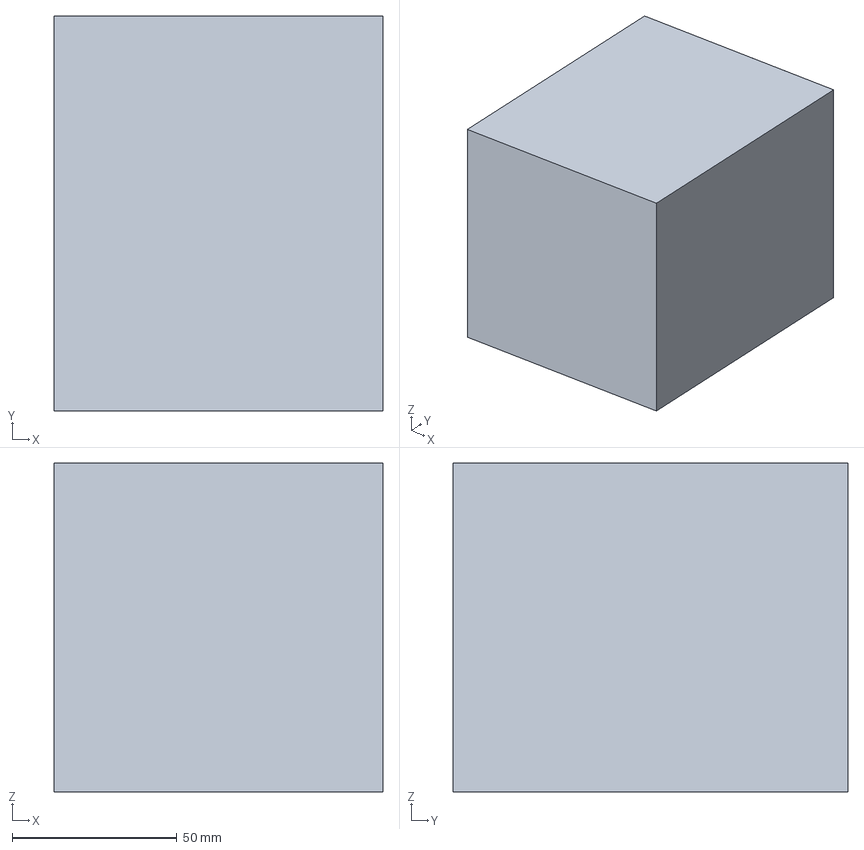
[picture p144: CAD file, 2026-11-13]
poc_2.5m_cell/cad/step/pc_motor.stp
100.0 x 120.0 x 100.0 mm
