lsy041015/capstone-design-hanyang-university/poc_2.5m_cell/cad/step/pc_end_stop.stp

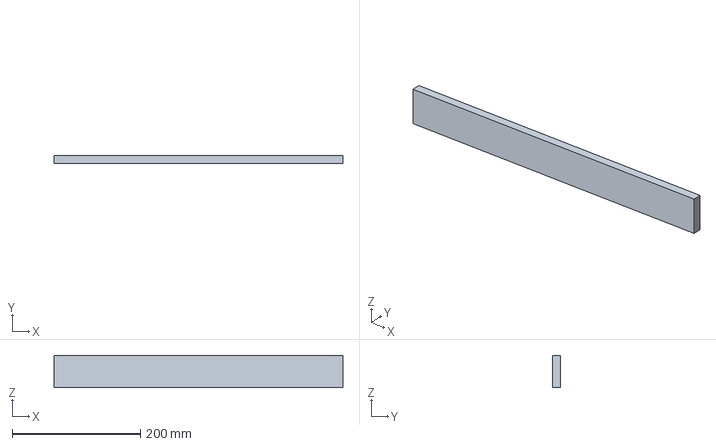
[picture p145: CAD file, 2026-11-13]
poc_2.5m_cell/cad/step/pc_end_stop.stp
450.0 x 12.0 x 50.0 mm
