lsy041015/capstone-design-hanyang-university/poc_2.5m_cell/cad/step/rk_shelf.stp

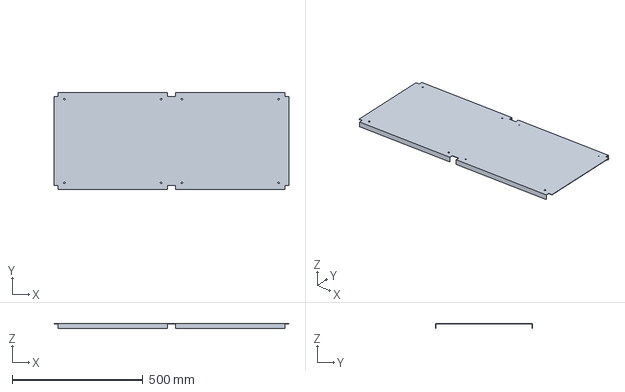
[picture p146: CAD file, 2026-11-13]
poc_2.5m_cell/cad/step/rk_shelf.stp
900.0 x 370.0 x 20.0 mm
