lsy041015/capstone-design-hanyang-university/poc_2.5m_cell/cad/step/pc_belt.stp

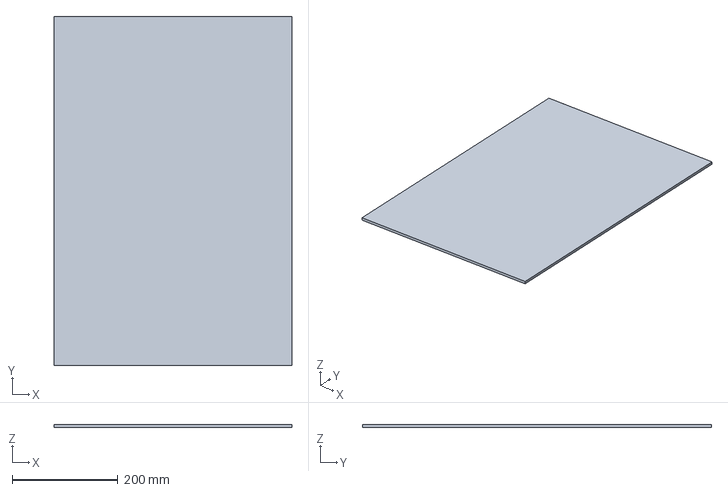
[picture p147: CAD file, 2026-11-13]
poc_2.5m_cell/cad/step/pc_belt.stp
450.0 x 660.0 x 6.00 mm
