lsy041015/capstone-design-hanyang-university/poc_2.5m_cell/cad/step/pc_side.stp

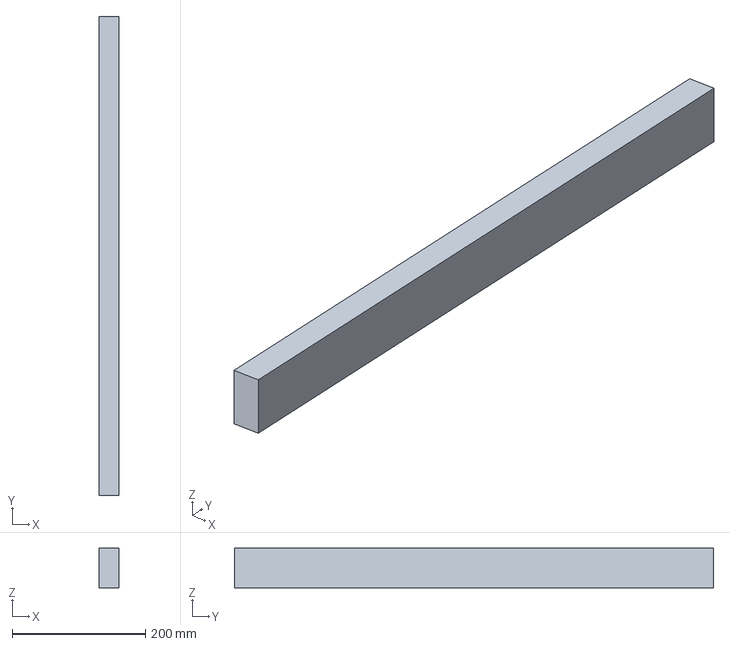
[picture p148: CAD file, 2026-11-13]
poc_2.5m_cell/cad/step/pc_side.stp
30.0 x 720.0 x 60.0 mm
