lsy041015/capstone-design-hanyang-university/poc_2.5m_cell/cad/step/pc_sensor.stp

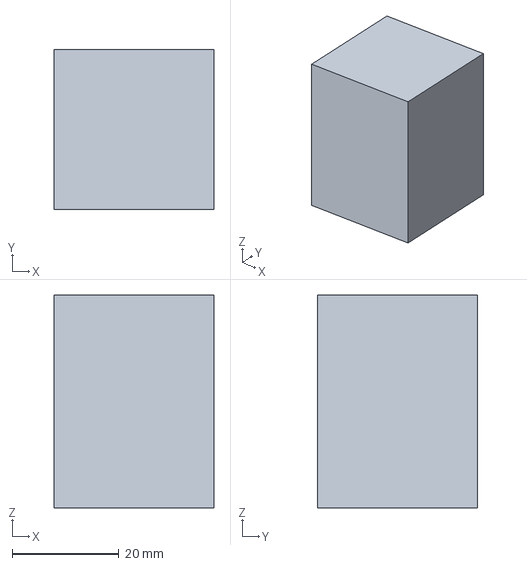
[picture p149: CAD file, 2026-11-13]
poc_2.5m_cell/cad/step/pc_sensor.stp
30.0 x 30.0 x 40.0 mm
