lsy041015/capstone-design-hanyang-university/poc_2.5m_cell/cad/step/pc_leg.stp

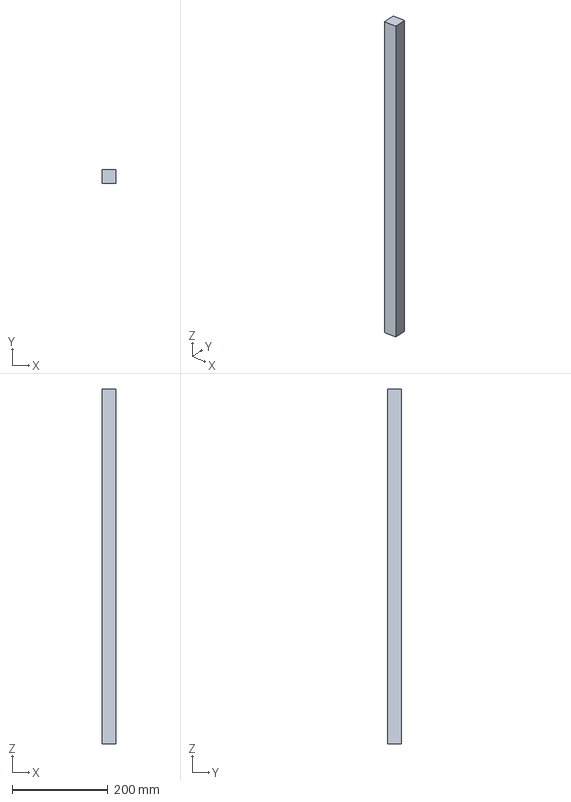
[picture p150: CAD file, 2026-11-13]
poc_2.5m_cell/cad/step/pc_leg.stp
30.0 x 30.0 x 740.0 mm
