lsy041015/capstone-design-hanyang-university/poc_2.5m_cell/cad/step/cv_cell.stp

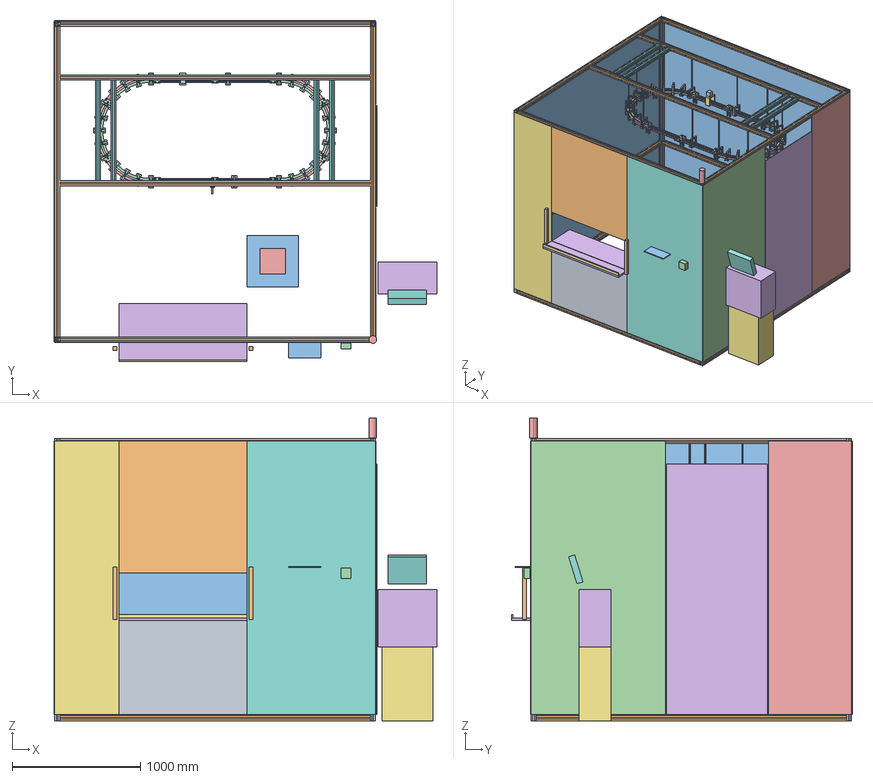
[picture p151: CAD file, 2026-11-08]
poc_2.5m_cell/cad/step/cv_cell.stp
2985.0 x 2655.0 x 2358.0 mm
FR_4040_L2200 x 4
PUR_4040_L2420 x 14
ACR_2500X2130 x 2
ACR_1050X2130
ACR_650X2130
ACR_790X1950
ACR_500X2130
ACR_1000X2130
ACR_1000X750
ACR_1000X1030
PED_PLATE
PED_COLUMN
PED_TOP
SHELF_PLATE
SHELF_LIP
FR_4040_L780
FR_4040_L960
LIGHT_CURTAIN_BAR x 2
GALAXY_TAB
ESTOP_BOX
STACK_LIGHT
UR_CONTROL_BOX
UR_CB_STAND
UR_TEACH_PENDANT
CV_BRIDGE x 28
PUR_625ZZ x 94
PUR_M8_ROD_L400 x 12
CV_RAIL_IN30 x 12
CV_RAIL_OUT30 x 12
PUR_2020_L1000 x 4
CV_DRIVE_BRIDGE
CV_PULLEY_GT2_40T
PUR_NEMA17
CV_SENSOR_BRACKET
PUR_LJ12A3
CV_TROLLEY x 10
CV_STEM x 10
CV_PIN_SLEEVE x 10
PUR_623ZZ x 20
PUR_4040_L784 x 4
IMP_UR5E_BASE_MESH
IMP_UR5E_SHOULDER_MESH
IMP_UR5E_UPPER_ARM_MESH
IMP_UR5E_WRIST_1_MESH
IMP_UR5E_WRIST_2_MESH
IMP_UR5E_WRIST_3_MESH
IMP_AG95_BASE
IMP_GRIP_AG95_F1_CRANK
IMP_GRIP_AG95_F1_ROD
IMP_GRIP_AG95_F1_PROXIMAL
IMP_GRIP_AG95_F1_DISTAL
IMP_GRIP_AG95_F2_CRANK
IMP_GRIP_AG95_F2_ROD
IMP_GRIP_AG95_F2_PROXIMAL
IMP_GRIP_AG95_F2_DISTAL
IMP_UR5E_FOREARM_MESH
