lsy041015/capstone-design-hanyang-university/poc_2.5m_cell/cad/step/pur_nema17.stp

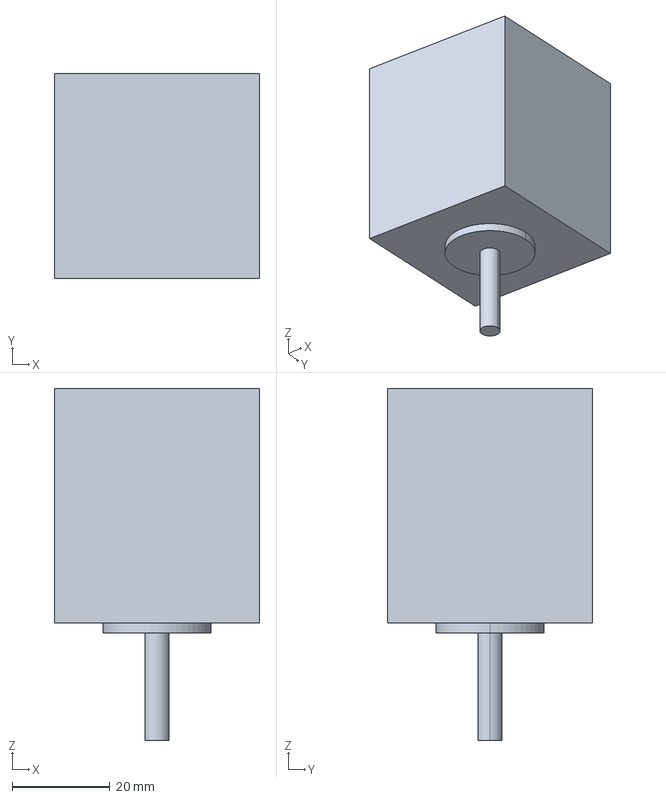
[picture p152: CAD file, 2026-11-08]
poc_2.5m_cell/cad/step/pur_nema17.stp
42.0 x 42.0 x 72.0 mm
