lsy041015/capstone-design-hanyang-university/poc_2.5m_cell/cad/step/cv_sensor_bracket.stp

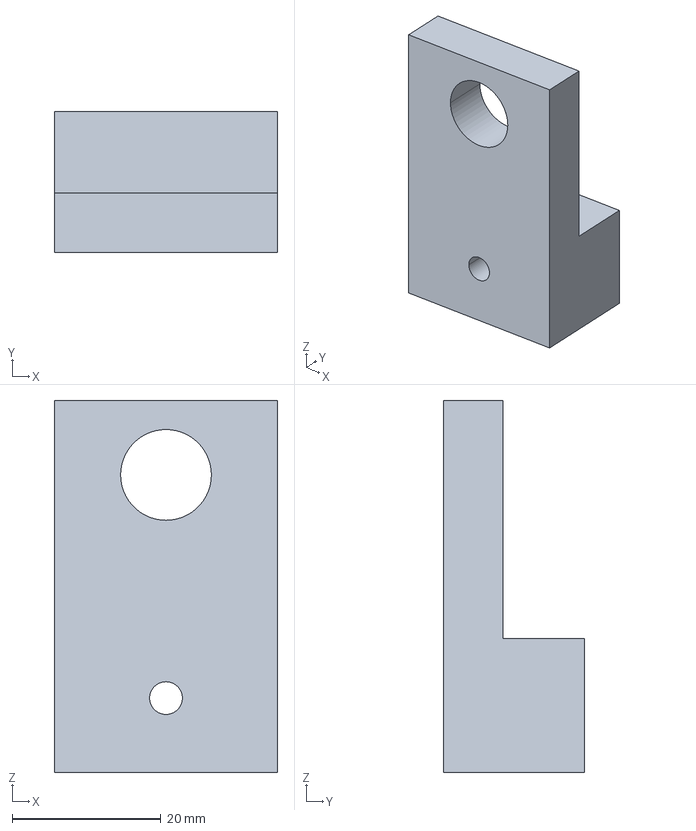
[picture p153: CAD file, 2026-11-08]
poc_2.5m_cell/cad/step/cv_sensor_bracket.stp
30.0 x 19.0 x 50.0 mm
