lsy041015/capstone-design-hanyang-university/poc_2.5m_cell/cad/step/pur_4040_l784.stp

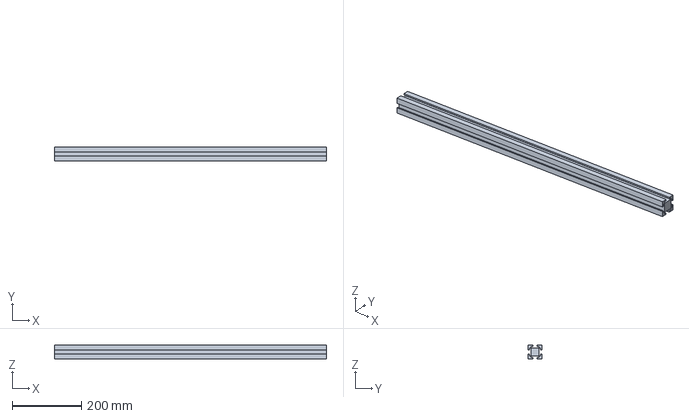
[picture p154: CAD file, 2026-11-08]
poc_2.5m_cell/cad/step/pur_4040_l784.stp
784.0 x 40.0 x 40.0 mm
