lsy041015/capstone-design-hanyang-university/poc_2.5m_cell/cad/step/pur_2020_l1000.stp

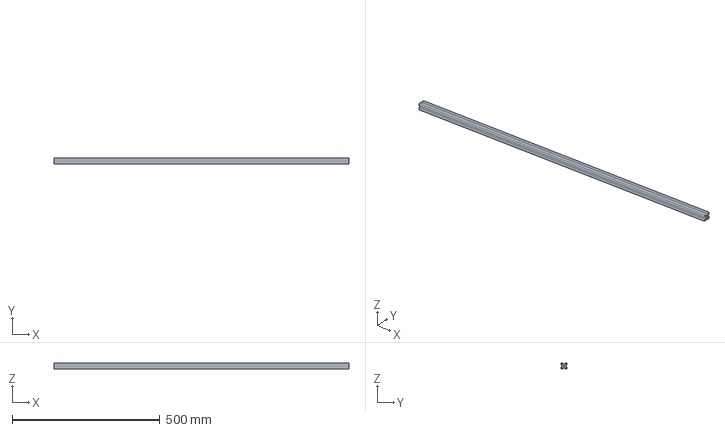
[picture p155: CAD file, 2026-11-08]
poc_2.5m_cell/cad/step/pur_2020_l1000.stp
1000.0 x 20.0 x 20.0 mm
