lsy041015/capstone-design-hanyang-university/poc_2.5m_cell/cad/step/cv_conveyor.stp

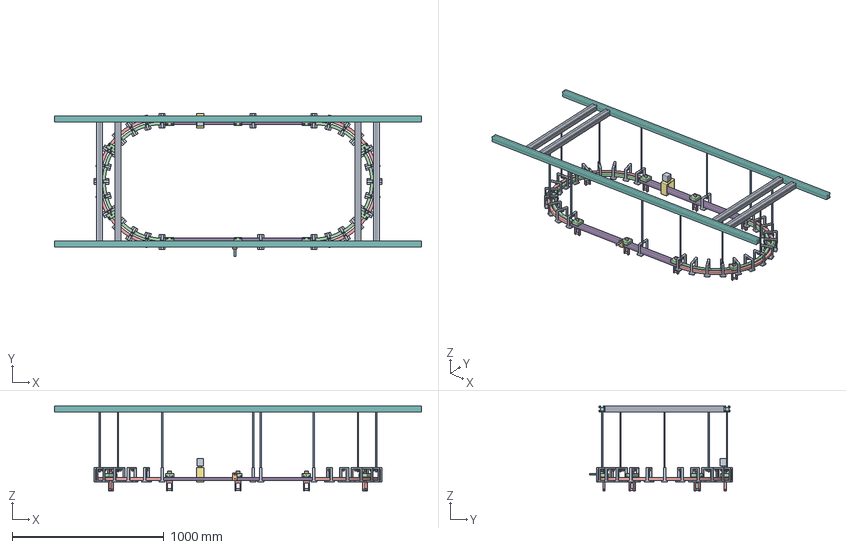
[picture p156: CAD file, 2026-11-08]
poc_2.5m_cell/cad/step/cv_conveyor.stp
2420.0 x 944.0 x 560.0 mm
CV_BRIDGE x 28
PUR_625ZZ x 94
PUR_M8_ROD_L400 x 12
CV_RAIL_IN30 x 12
CV_RAIL_OUT30 x 12
PUR_2020_L1000 x 4
CV_DRIVE_BRIDGE
CV_PULLEY_GT2_40T
PUR_NEMA17
CV_SENSOR_BRACKET
PUR_LJ12A3
CV_TROLLEY x 10
CV_STEM x 10
CV_PIN_SLEEVE x 10
PUR_623ZZ x 20
PUR_4040_L2420 x 2
PUR_4040_L784 x 4
