lsy041015/capstone-design-hanyang-university/poc_2.5m_cell/cad/step/pur_m8_rod_l400.stp

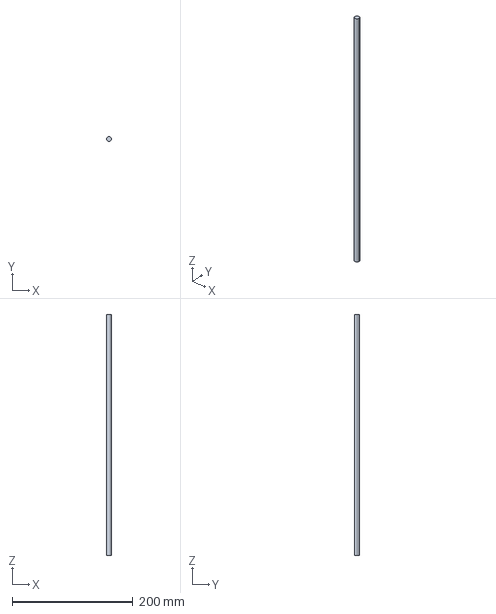
[picture p157: CAD file, 2026-11-08]
poc_2.5m_cell/cad/step/pur_m8_rod_l400.stp
8.00 x 8.00 x 400.0 mm
