lsy041015/capstone-design-hanyang-university/poc_2.5m_cell/cad/step/cv_drive_bridge.stp

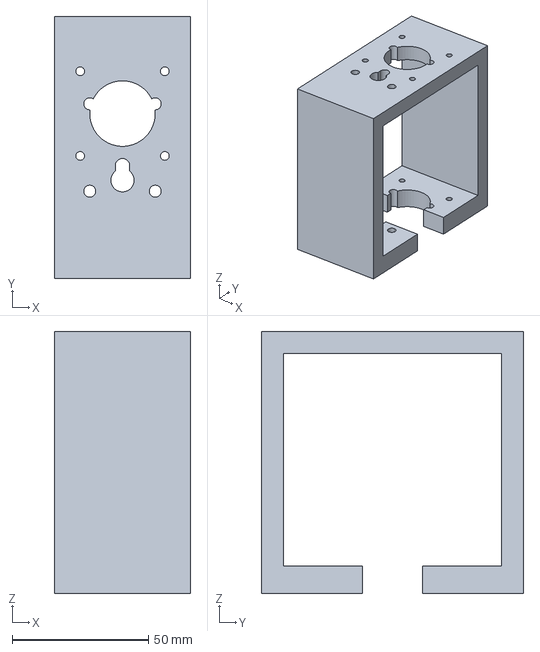
[picture p158: CAD file, 2026-11-08]
poc_2.5m_cell/cad/step/cv_drive_bridge.stp
50.0 x 96.0 x 96.0 mm
