lsy041015/capstone-design-hanyang-university/poc_2.5m_cell/cad/step/cv_pulley_gt2_40t.stp

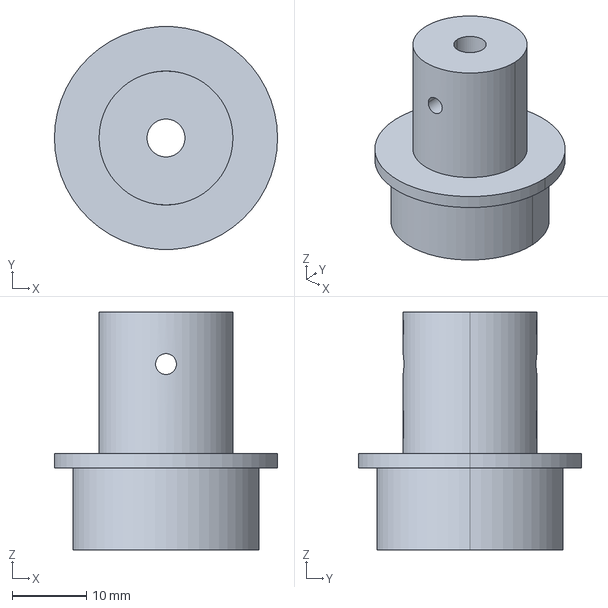
[picture p159: CAD file, 2026-11-08]
poc_2.5m_cell/cad/step/cv_pulley_gt2_40t.stp
30.0 x 29.9 x 32.0 mm
