lsy041015/capstone-design-hanyang-university/poc_2.5m_cell/cad/step/pur_623zz.stp

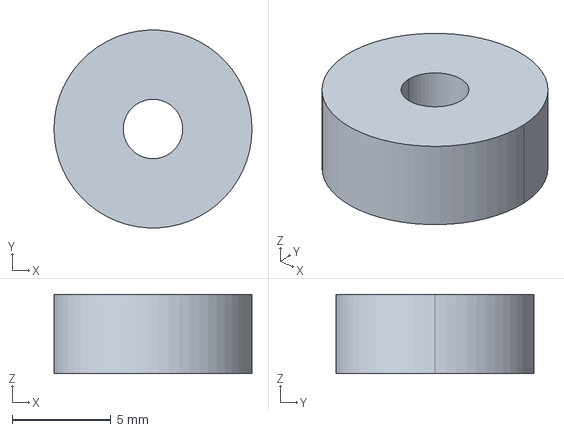
[picture p160: CAD file, 2026-11-08]
poc_2.5m_cell/cad/step/pur_623zz.stp
10.0 x 9.99 x 4.00 mm
