lsy041015/capstone-design-hanyang-university/poc_2.5m_cell/cad/step/pur_625zz.stp

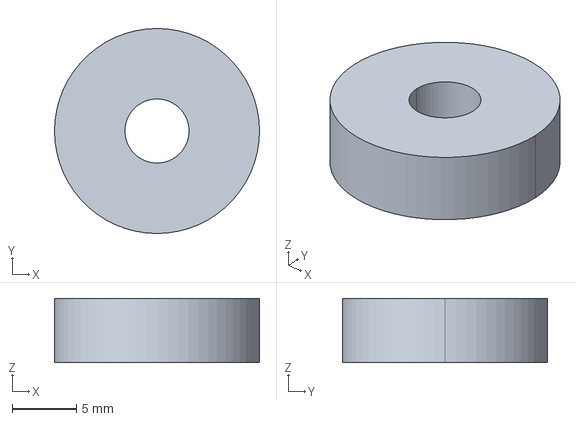
[picture p161: CAD file, 2026-11-08]
poc_2.5m_cell/cad/step/pur_625zz.stp
16.0 x 16.0 x 5.00 mm
