lsy041015/capstone-design-hanyang-university/poc_2.5m_cell/cad/step/cv_rail_out30.stp

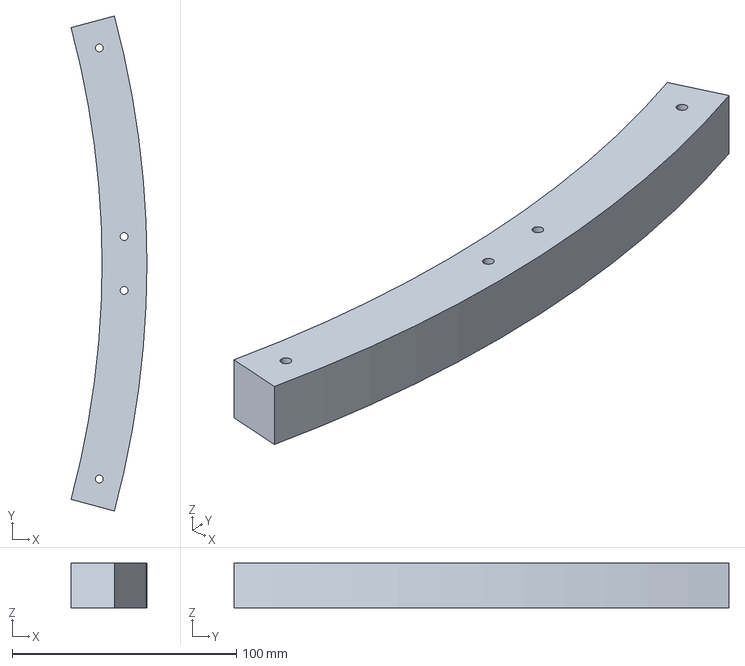
[picture p162: CAD file, 2026-11-08]
poc_2.5m_cell/cad/step/cv_rail_out30.stp
33.8 x 220.5 x 20.0 mm
