lsy041015/capstone-design-hanyang-university/poc_2.5m_cell/cad/step/cv_stem.stp

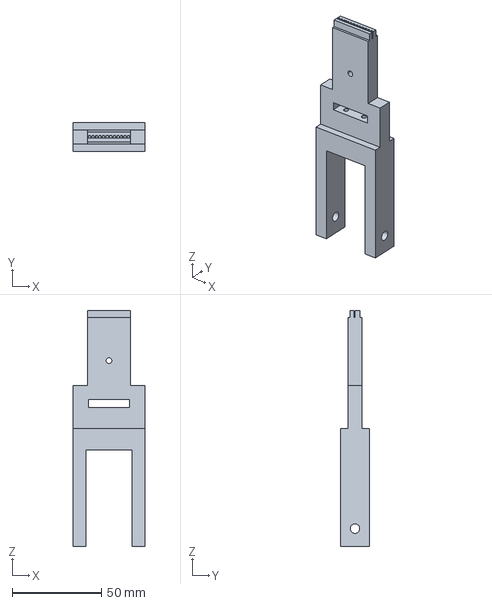
[picture p163: CAD file, 2026-11-08]
poc_2.5m_cell/cad/step/cv_stem.stp
40.0 x 16.0 x 132.0 mm
