lsy041015/capstone-design-hanyang-university/poc_2.5m_cell/cad/step/cv_rail_in30.stp

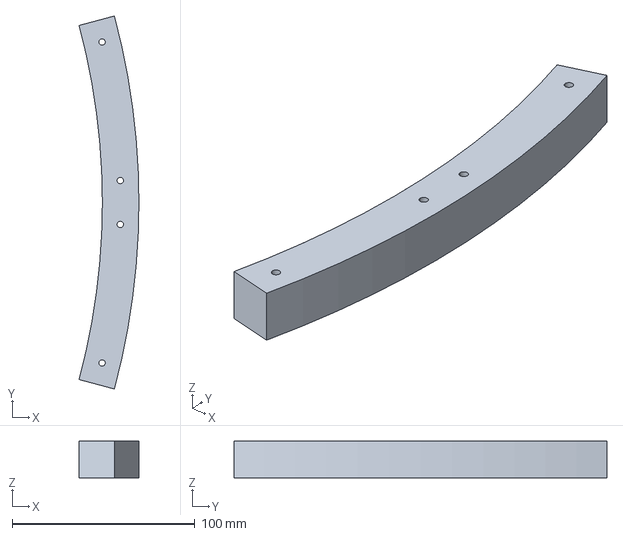
[picture p164: CAD file, 2026-11-08]
poc_2.5m_cell/cad/step/cv_rail_in30.stp
32.7 x 203.9 x 20.0 mm
