lsy041015/capstone-design-hanyang-university/poc_2.5m_cell/cad/step/cv_bridge.stp

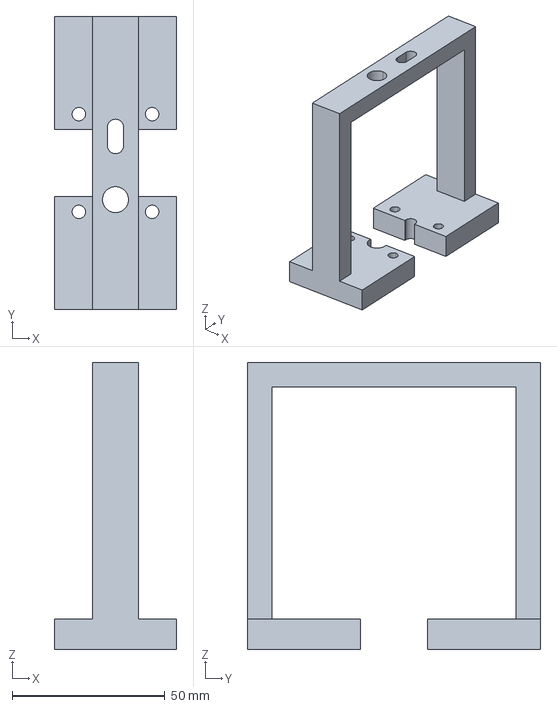
[picture p165: CAD file, 2026-11-08]
poc_2.5m_cell/cad/step/cv_bridge.stp
40.0 x 96.0 x 94.0 mm
