lsy041015/capstone-design-hanyang-university/poc_2.5m_cell/cad/step/cv_pin_sleeve.stp

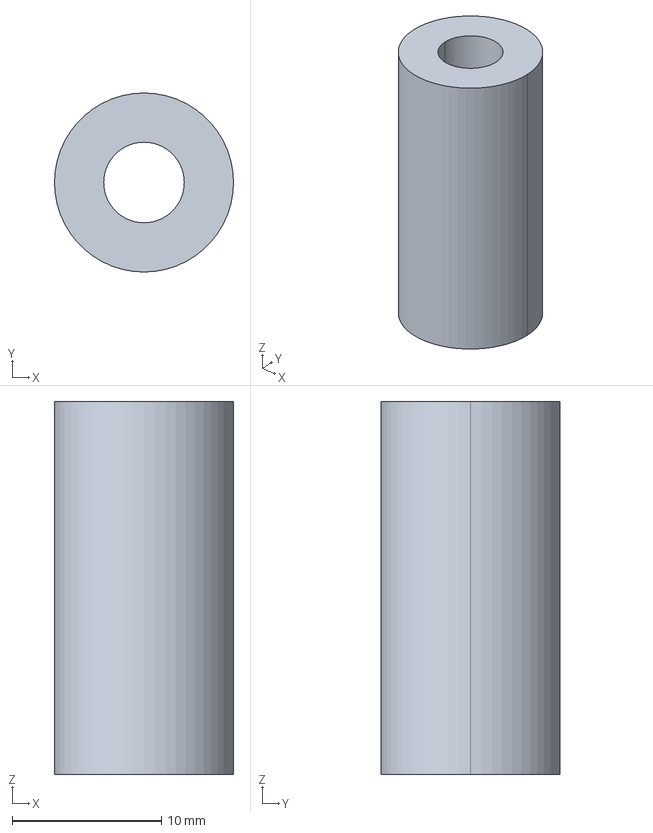
[picture p166: CAD file, 2026-11-08]
poc_2.5m_cell/cad/step/cv_pin_sleeve.stp
12.0 x 12.0 x 25.0 mm
