lsy041015/capstone-design-hanyang-university/poc_2.5m_cell/cad/step/pur_lj12a3.stp

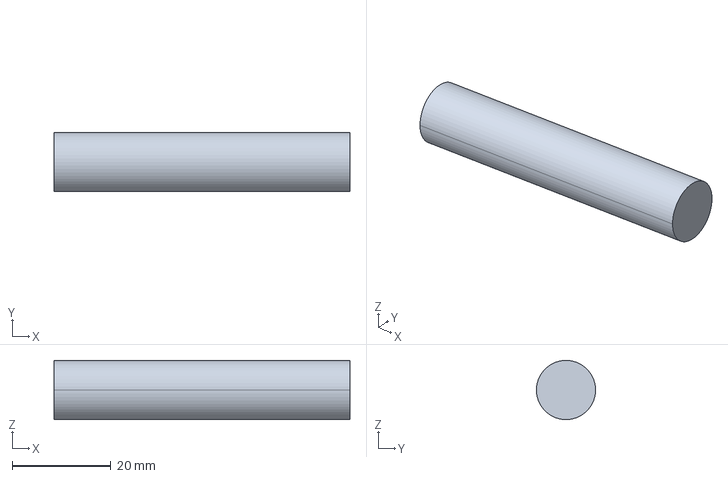
[picture p167: CAD file, 2026-11-08]
poc_2.5m_cell/cad/step/pur_lj12a3.stp
60.0 x 12.0 x 12.0 mm
