lsy041015/capstone-design-hanyang-university/poc_2.5m_cell/cad/step/cv_trolley.stp

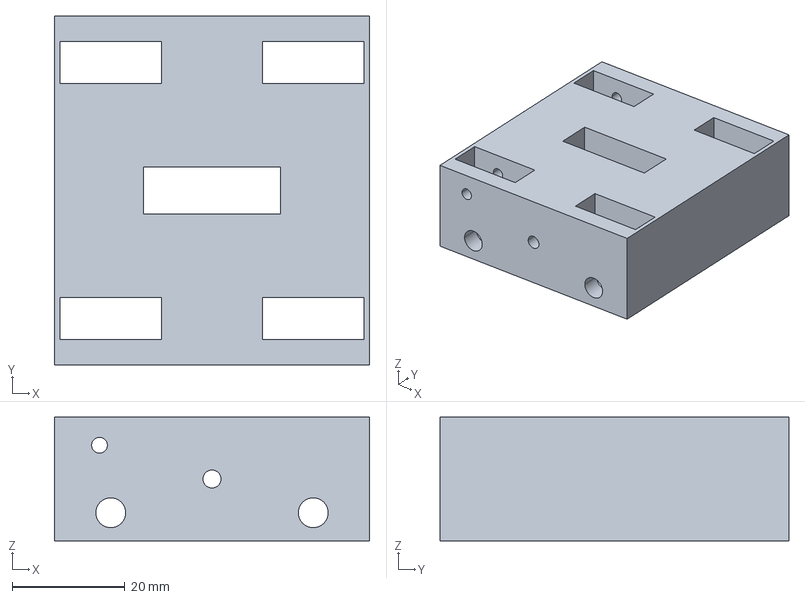
[picture p168: CAD file, 2026-11-08]
poc_2.5m_cell/cad/step/cv_trolley.stp
56.0 x 62.0 x 22.0 mm
