lsy041015/capstone-design-hanyang-university/poc_2.5m_cell/cad/step/pur_4040_l2420.stp

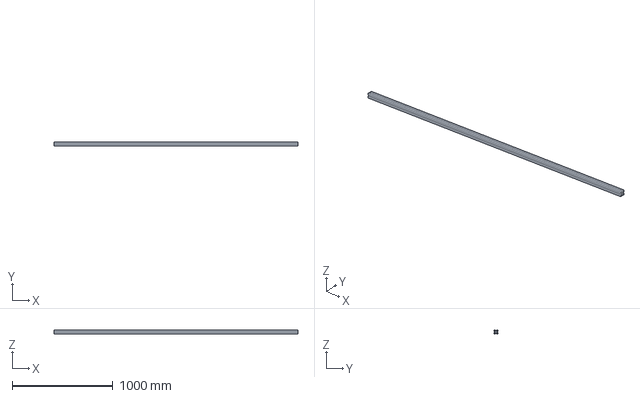
[picture p169: CAD file, 2026-11-08]
poc_2.5m_cell/cad/step/pur_4040_l2420.stp
2420.0 x 40.0 x 40.0 mm
