lsy041015/capstone-design-hanyang-university/(list of files, cad)

Other CAD files:
poc_2.5m_cell/cad/stl/cv_bridge.stl
poc_2.5m_cell/cad/stl/cv_drive_bridge.stl
poc_2.5m_cell/cad/stl/cv_pin_sleeve.stl
poc_2.5m_cell/cad/stl/cv_pulley_gt2_40t.stl
poc_2.5m_cell/cad/stl/cv_rail_in30.stl
poc_2.5m_cell/cad/stl/cv_rail_out30.stl
poc_2.5m_cell/cad/stl/cv_sensor_bracket.stl
poc_2.5m_cell/cad/stl/cv_stem.stl
poc_2.5m_cell/cad/stl/cv_trolley.stl
poc_2.5m_cell/cad/stl/pur_2020_l1000.stl
poc_2.5m_cell/cad/stl/pur_4040_l2420.stl
poc_2.5m_cell/cad/stl/pur_4040_l784.stl
poc_2.5m_cell/cad/stl/pur_623zz.stl
poc_2.5m_cell/cad/stl/pur_625zz.stl
poc_2.5m_cell/cad/stl/pur_lj12a3.stl
poc_2.5m_cell/cad/stl/pur_m8_rod_l400.stl
poc_2.5m_cell/cad/stl/pur_nema17.stl
