lsy041015/capstone-design-hanyang-university/docs/v2.0_verification.md

# V2.0 검증 기록 (통합 시연 모델 v8)

대상: `무인세탁소_통합시연_v8.blend`(Blender 5.2.1, 6,620프레임, 오브젝트 3,056) · 검사 스크립트: `verify_v8.py`(저장소에는 없음) · 원자료: [v2.0_verification.json](v2.0_verification.json)

검사는 저장한 파일을 다시 열어 프레임을 실제로 평가하는 방식이다. Blender 안의 형상·논리 상태만 확인한다. 실물 하중, 구매품 정격, PLC·안전 회로, FR5e 실측 기구학은 검사 대상이 아니다.

## 1. 자동 검사 (7/7 통과)

| 검사 | 기준 | 결과 |
|---|---|---|
| 드라이버 | 모두 유효 + 단순식(Python 자동 실행 불필요) | 223개, 오류 0, 비단순식 0 |
| 기구 연동 | 휠 각 = s/R, 캐리어 = 경로 위치, Y 풀리 = −y/r, Z 스크루 = z/리드×2π, 롤러 = x/r, 승강 = z (414 샘플) | 최대 오차 캐리어 0.024 mm, 스크루 1.4×10⁻⁵ rad, 기타 ≤ 1.2×10⁻⁶ |
| 로봇 리그 | Blender TCP = numpy 공칭 순기구학(15프레임마다) | 최대 1.2×10⁻⁶ m |
| 관절 한계·속도 | ±360°, ≤ 180°/s (UR5 CB 공칭) | 최대 관절 속도 72°/s, TCP 최대 1.08 m/s(빈손 이동) |
| 화물 인계 연속성 | 모든 소켓 전환 순간의 위치 차 < 2 mm | 31회, 최대 0.78 mm (직원이 포장대에서 새들백을 드는 순간) |
| 인터록 논리 | 전 프레임: 내부 셔터 미폐쇄 중 고객문 개방 금지, 고객문 열림 중 Y·컨베이어 구동 금지, 인덱스 핀 체결·라이트 커튼 차단 중 체인 구동 금지, 추출기 전개 중 승강 금지, 정비문 개방 중 축 구동 금지, 셔터 완전 개방 전 그리퍼의 A 진입 금지 | 6,620프레임 위반 0 |
| 로봇 간섭 | 로봇 모션 3,012프레임 중 3프레임마다(1,004), 로봇 7링크 + 그리퍼 + 들고 있는 화물(어댑터와 옷 전체 길이, 트레이와 새들백)의 삼각형 vs 반경 2 m 안의 모든 메시 | 1,004프레임 교차 0 (검사 126.7 s) |
| 루프 의류 간격 | 체인 위치 12곳 × 의류 26벌 상호 교차 | 2,680쌍, 교차 0 |

허용 접촉: 핑거 인서트 ↔ 잡는 화물 탭, 화물 바닥 ↔ 레일·벨트·롤러·핀(설계상 받침), 로봇 베이스 ↔ 받침대 상판.

## 2. 사람 모형 검사 (`test_people.py`, 저장소에는 없음)

| 항목 | 결과 |
|---|---|
| 접지 중 발 미끄럼 | 0.00 mm (접지 구간 195개) |
| 손·손가락 끝 ↔ 목표 (접촉·유지 중) | ≤ 0.01 mm (938프레임) |
| 무릎 / 팔꿈치 각도 | 8.9–84.7° / 9.1–132.2° |
| 보행·주행 속도 오차 | 0.0 % (1.0–1.3 m/s), 보폭 0.61–0.66 m |

통합 빌드 경고: 몇몇 도달 목표가 팔 길이보다 7–18 mm 멀어 상체 기울기로 보정됐다(손잡이·레일 접촉 위치). 이 차이는 운반 트랙의 시작·끝 스냅(0.35 s)으로 화물 자세 연속성에 영향을 주지 않는다(1장 인계 검사).

## 3. 화면 확인

- 26개 카메라 샷의 중간 프레임과 티저 15개 샷을 1080p로 렌더해 형상·가림·동작·주석 위치를 눈으로 확인했다. 그 과정에서 고친 문제: 벽 속 카메라 4대, 고객 등이 화면을 가리는 샷 3개, 셔터가 닫혀 걸이 하강이 안 보이는 샷(단면 카메라로 교체), 흰 셔츠가 흰 셔터 앞에서 식별되지 않는 문제(색 변경), 수령 물품이 1프레임부터 숨겨지던 가시성 버그, 새들백 손잡이의 도달 거리(0.75 → 0.43 m).
- V2.0 공개 전 추가 점검(2026-09-29): 카메라–사람 간격 검사(`camera_clearance.py`, 저장소에는 없음, 카메라와 사람 기준점의 수평 거리 ≥ 0.5 m)로 `CAM_STAFF_VLM`이 직원 경로 위(최소 0.02 m, 티저 4번 샷에 약 0.5초 검은 화면)에 있던 것을 찾아 (8.30, 7.25, 2.00)으로 옮겼다(경로와 0.98 m). 두 번째 주문(231-418, 의류만, 낮은 위치)용 키오스크 화면 3장을 추가하고, 보충창·VLM 베이·직원 단말 화면 표시를 공정 값(H05, T04, 231-452)에 맞췄다. 바뀐 화면이 보이는 티저 3·4번 샷을 다시 렌더했고, 나머지 샷은 재빌드 모델과 픽셀 차이 ≤ 2레벨(화면이 멀리 보이는 1·2·15번 샷은 11–15 px)임을 확인해 그대로 썼다.
- 초기 검사에서 드러나 설계를 바꾼 항목: 로봇 팔이 A 수령함 모서리 기둥을 지나가던 관절 경로(팔꿈치-상향 해 우선), 그리퍼가 내부 셔터 평면에 걸치던 후퇴 거리(0.16 → 0.40 m), 정비문이 셀 안쪽으로 열려 VLM과 겹치던 방향(바깥 여닫이), 루프 회전부 의류와 운반 의류의 간섭(피치 8링크·루프 위치 조정).

## 4. 영상

[v2.0_video_verification.json](v2.0_video_verification.json) — 판정 `PASS`. 1920×1080, 30 fps, 120.0초, 3,600프레임 전체 디코딩 오류 0, H.264 yuv420p + AAC 48 kHz 2채널, 챕터 15개, 36.9 MB. 음량 평균 -18.7 dB · 최대 -1.5 dB(loudnorm 목표 −16 LUFS). SHA-256 `cc1de31781b3d6f44fb71add3e39f160d9b1e261e67612fb068f222f72957e5d`. 확인용 프레임 15장(저장소에는 없음)에서 그래픽·주석 위치를 눈으로 확인했다.

## 5. 검사하지 않은 것

연속 시간 사이(3프레임 간격 사이)의 순간 접촉, 의류의 유연 변형, 로봇 자기 충돌, 동역학(가감속 중 화물 흔들림), 실제 센서 응답, 안전 기능의 성능 수준(PL), 정지 거리, 전장 설계, FR5e 형상 적용 후의 재검증.
