lsy041015/capstone-design-hanyang-university/poc_2.5m_cell/drawings/CV_CELL_LAYOUT.pdf

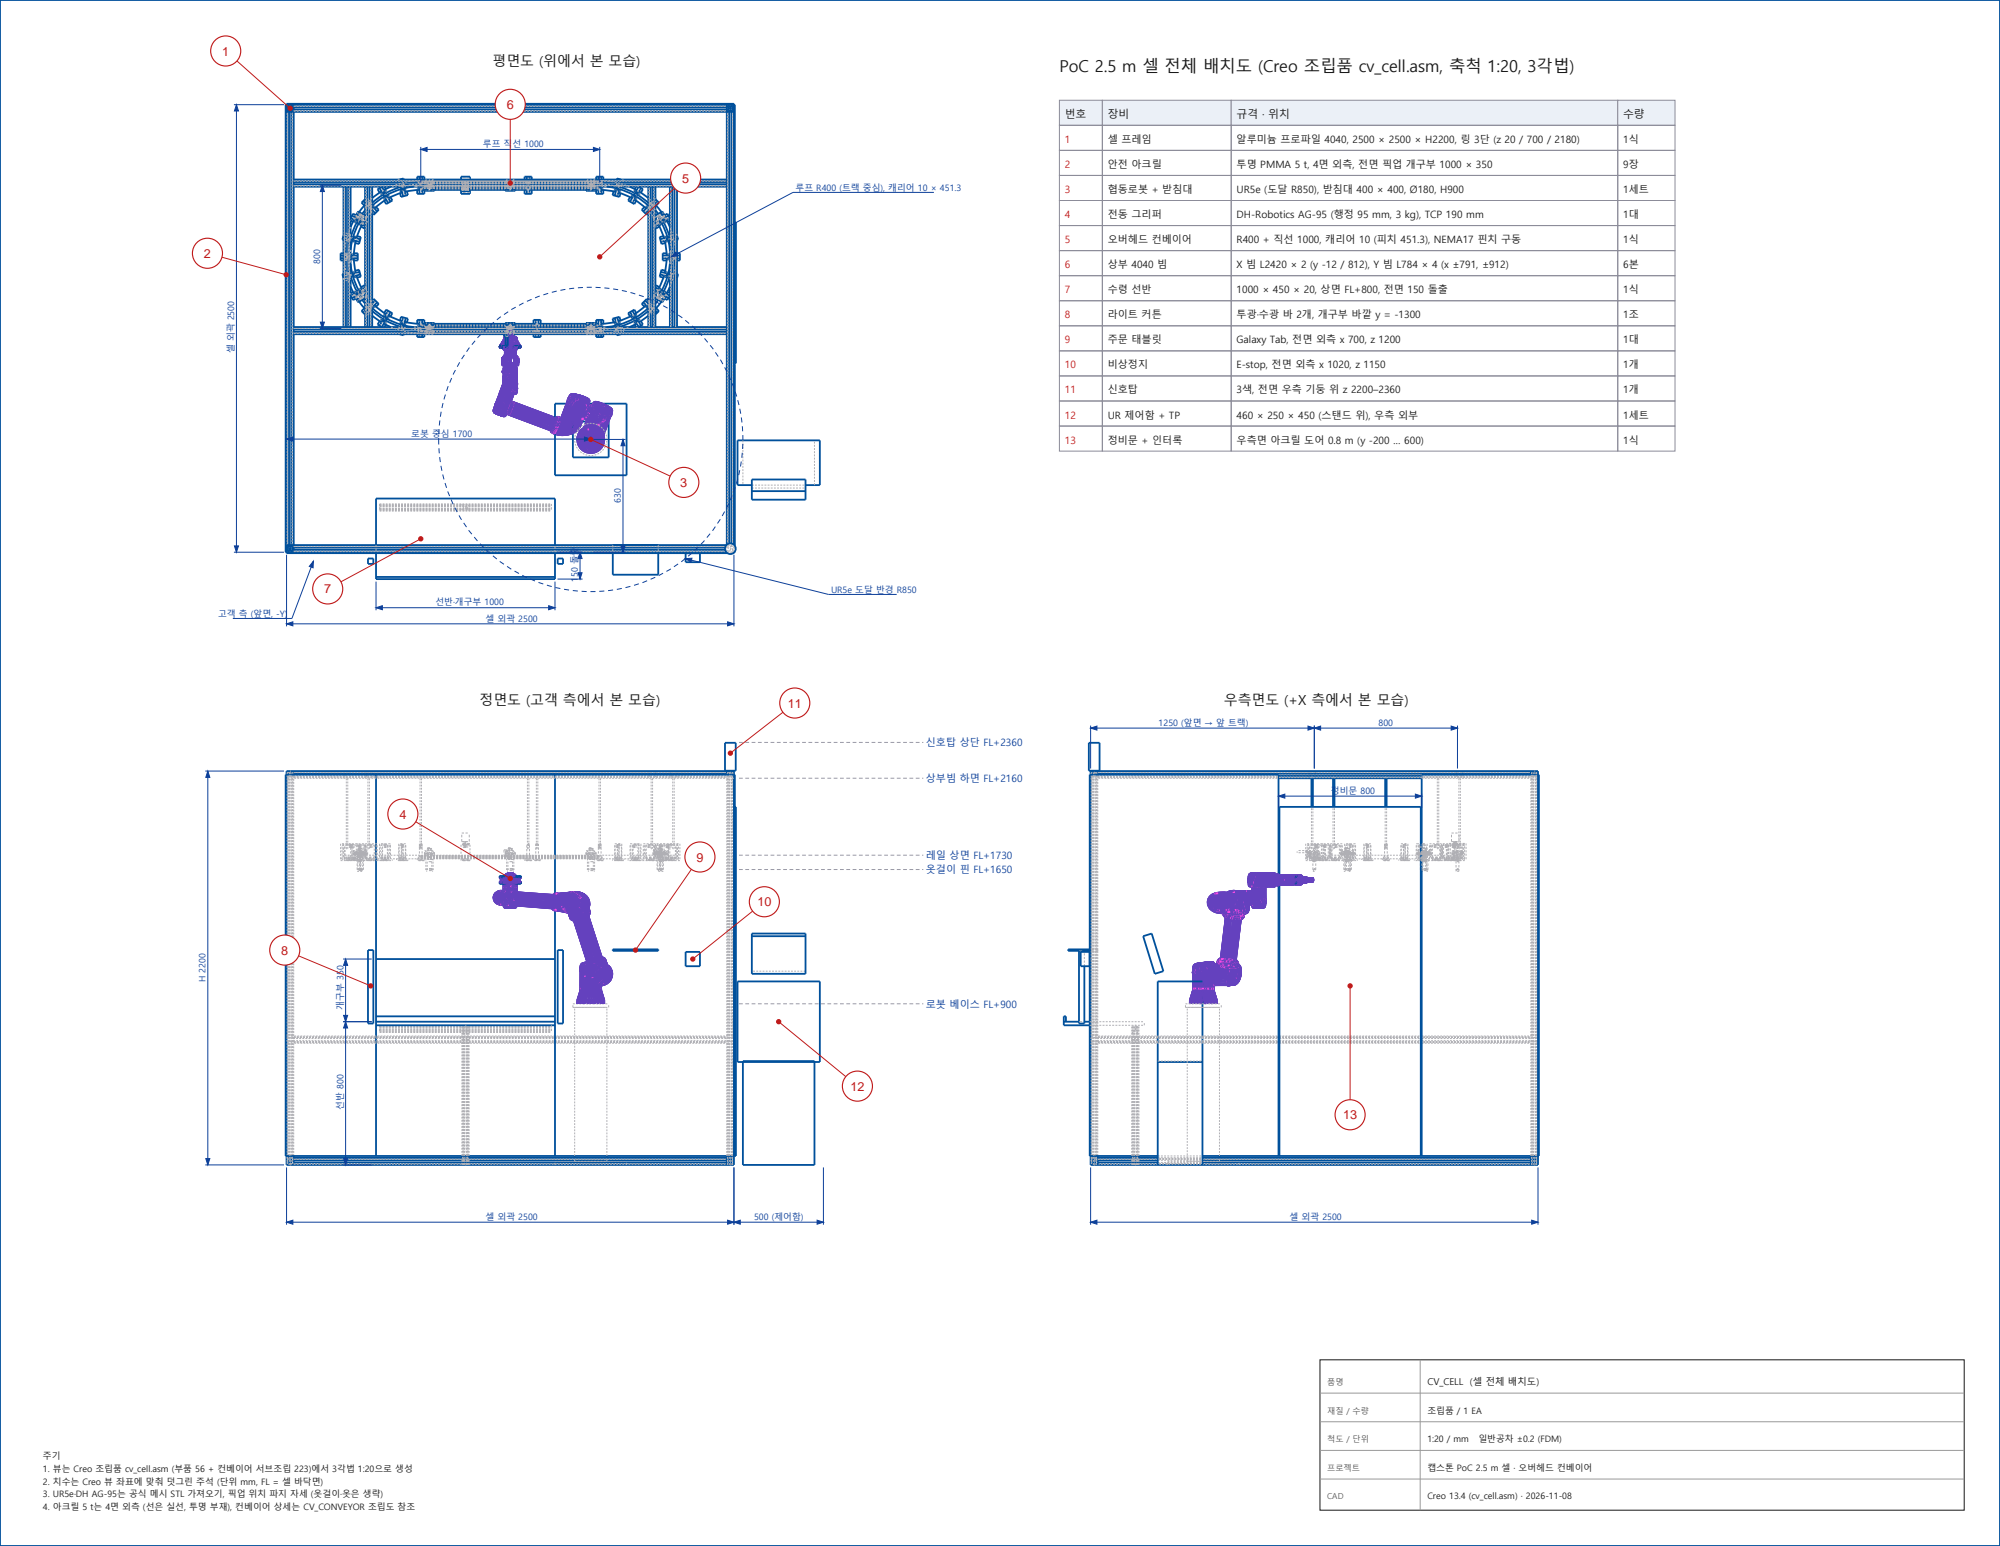
[picture p190: page 1]
선반·개구부 1000; 선반 800 개구부 350; 500 (제어함); 정비문 800; 정면도 (고객 측에서 본 모습); 우측면도 (+X 측에서 본 모습); 셀 프레임; 알루미늄 프로파일 4040, 2500 × 2500 × H2200, 링 3단 (z 20 / 700 / 2180); 안전 아크릴; 투명 PMMA 5 t, 4면 외측, 전면 픽업 개구부 1000 × 350; 협동로봇 + 받침대; UR5e (도달 R850), 받침대 400 × 400, Ø180, H900; 전동 그리퍼; DH-Robotics AG-95 (행정 95 mm, 3 kg), TCP 190 mm; 오버헤드 컨베이어; R400 + 직선 1000, 캐리어 10 (피치 451.3), NEMA17 핀치 구동; 라이트 커튼; 투광·수광 바 2개, 개구부 바깥 y = -1300; 주문 태블릿; Galaxy Tab, 전면 외측 x 700, z 1200; 비상정지; E-stop, 전면 외측 x 1020, z 1150; 신호탑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

평면도 (위에서 본 모습)

PoC 2.5 m 셀 전체 배치도 (Creo 조립품 cv_cell.asm, 축척 1:20, 3각법)

루프 R400 (트랙 중심), 캐리어 10 × 451.3

신호탑 상단 FL+2360

상부빔 하면 FL+2160

옷걸이 핀 FL+1650

로봇 베이스 FL+900

1. 뷰는 Creo 조립품 cv_cell.asm (부품 56 + 컨베이어 서브조립 223)에서 3각법 1:20으로 생성
2. 치수는 Creo 뷰 좌표에 맞춰 덧그린 주석 (단위 mm, FL = 셀 바닥면)
3. UR5e·DH AG-95는 공식 메시 STL 가져오기, 픽업 위치 파지 자세 (옷걸이·옷은 생략)
4. 아크릴 5 t는 4면 외측 (선은 실선, 투명 부재), 컨베이어 상세는 CV_CONVEYOR 조립도 참조
