lsy041015/capstone-design-hanyang-university/poc_2.5m_cell/drawings/CV_BRIDGE.pdf

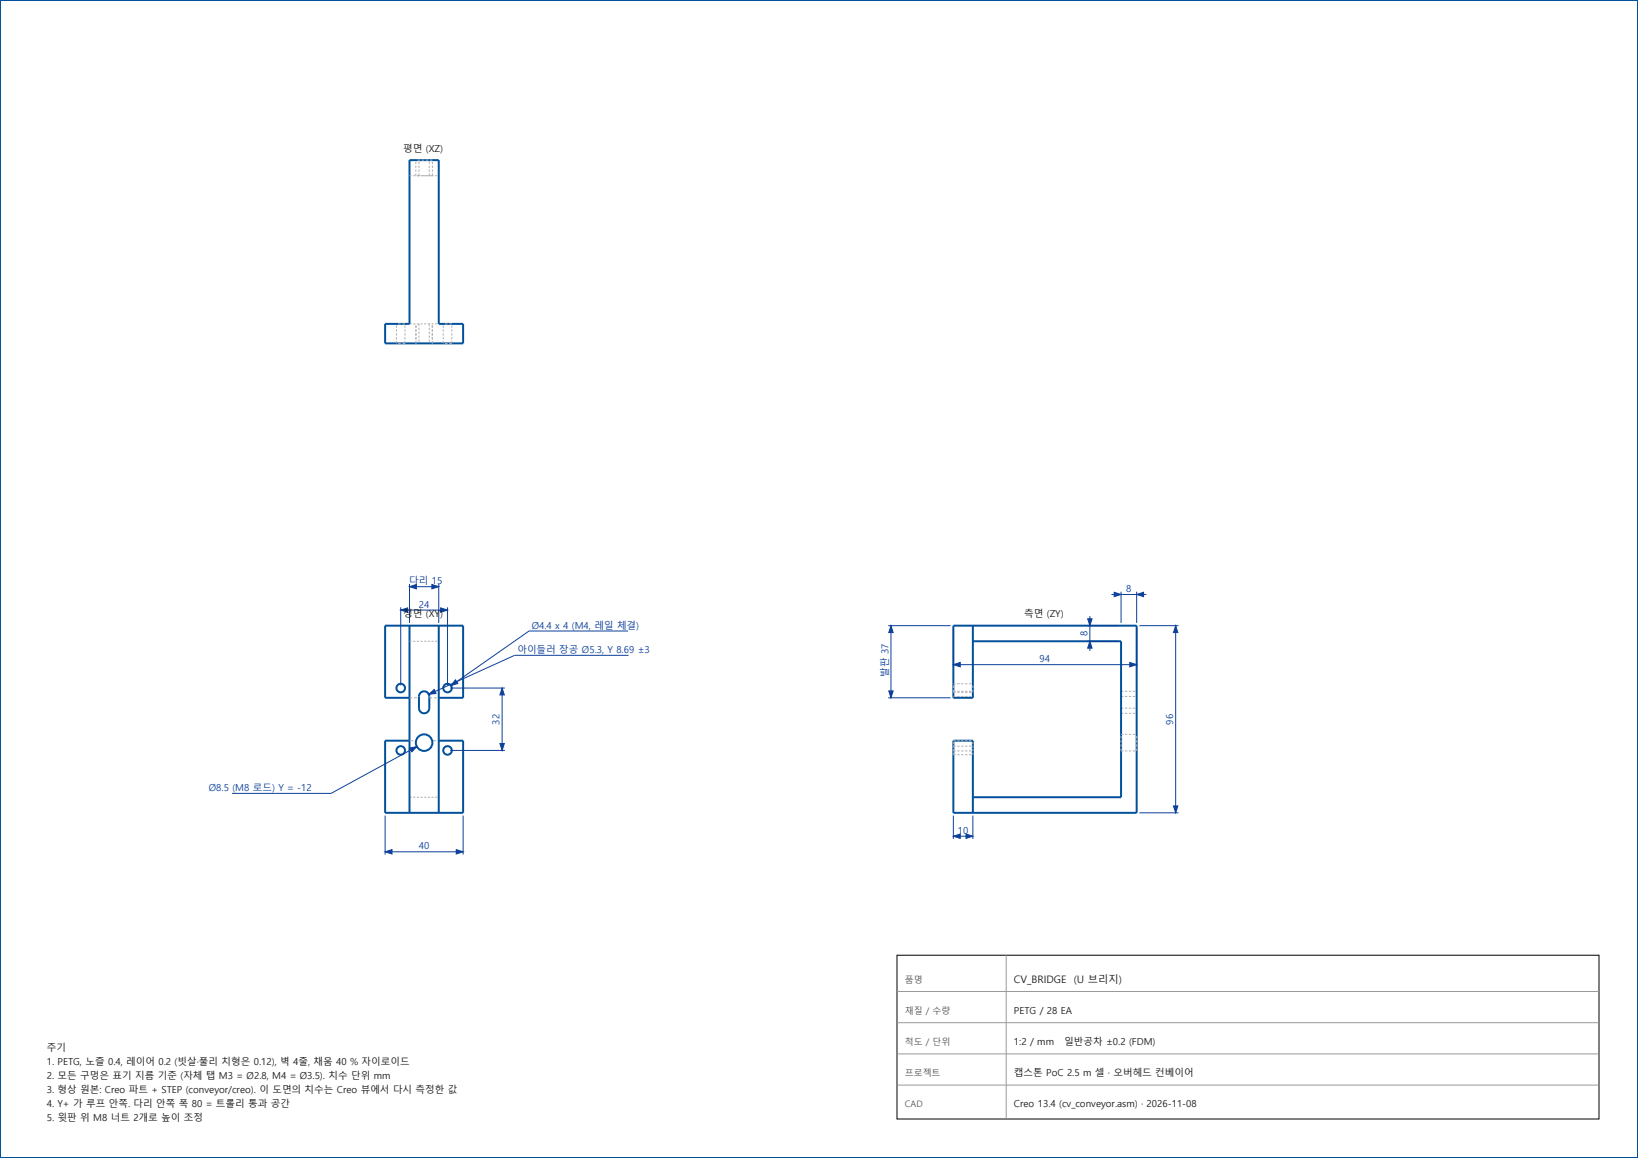
[picture p191: page 1]
아이들러 장공 Ø5.3, Y 8.69 ±3

품명 | CV_BRIDGE (U 브리지)

재질 / 수량 | PETG / 28 EA

척도 / 단위 | 1:2 / mm 일반공차 ±0.2 (FDM)

1. PETG, 노즐 0.4, 레이어 0.2 (빗살·풀리 치형은 0.12), 벽 4줄, 채움 40 % 자이로이드
2. 모든 구멍은 표기 지름 기준 (자체 탭 M3 = Ø2.8, M4 = Ø3.5). 치수 단위 mm
3. 형상 원본: Creo 파트 + STEP (conveyor/creo). 이 도면의 치수는 Creo 뷰에서 다시 측정한 값
4. Y+ 가 루프 안쪽. 다리 안쪽 폭 80 = 트롤리 통과 공간

프로젝트 | 캡스톤 PoC 2.5 m 셀 · 오버헤드 컨베이어

CAD | Creo 13.4 (cv_conveyor.asm) · 2026-11-08
