lsy041015/capstone-design-hanyang-university/poc_2.5m_cell/drawings/CV_STEM.pdf

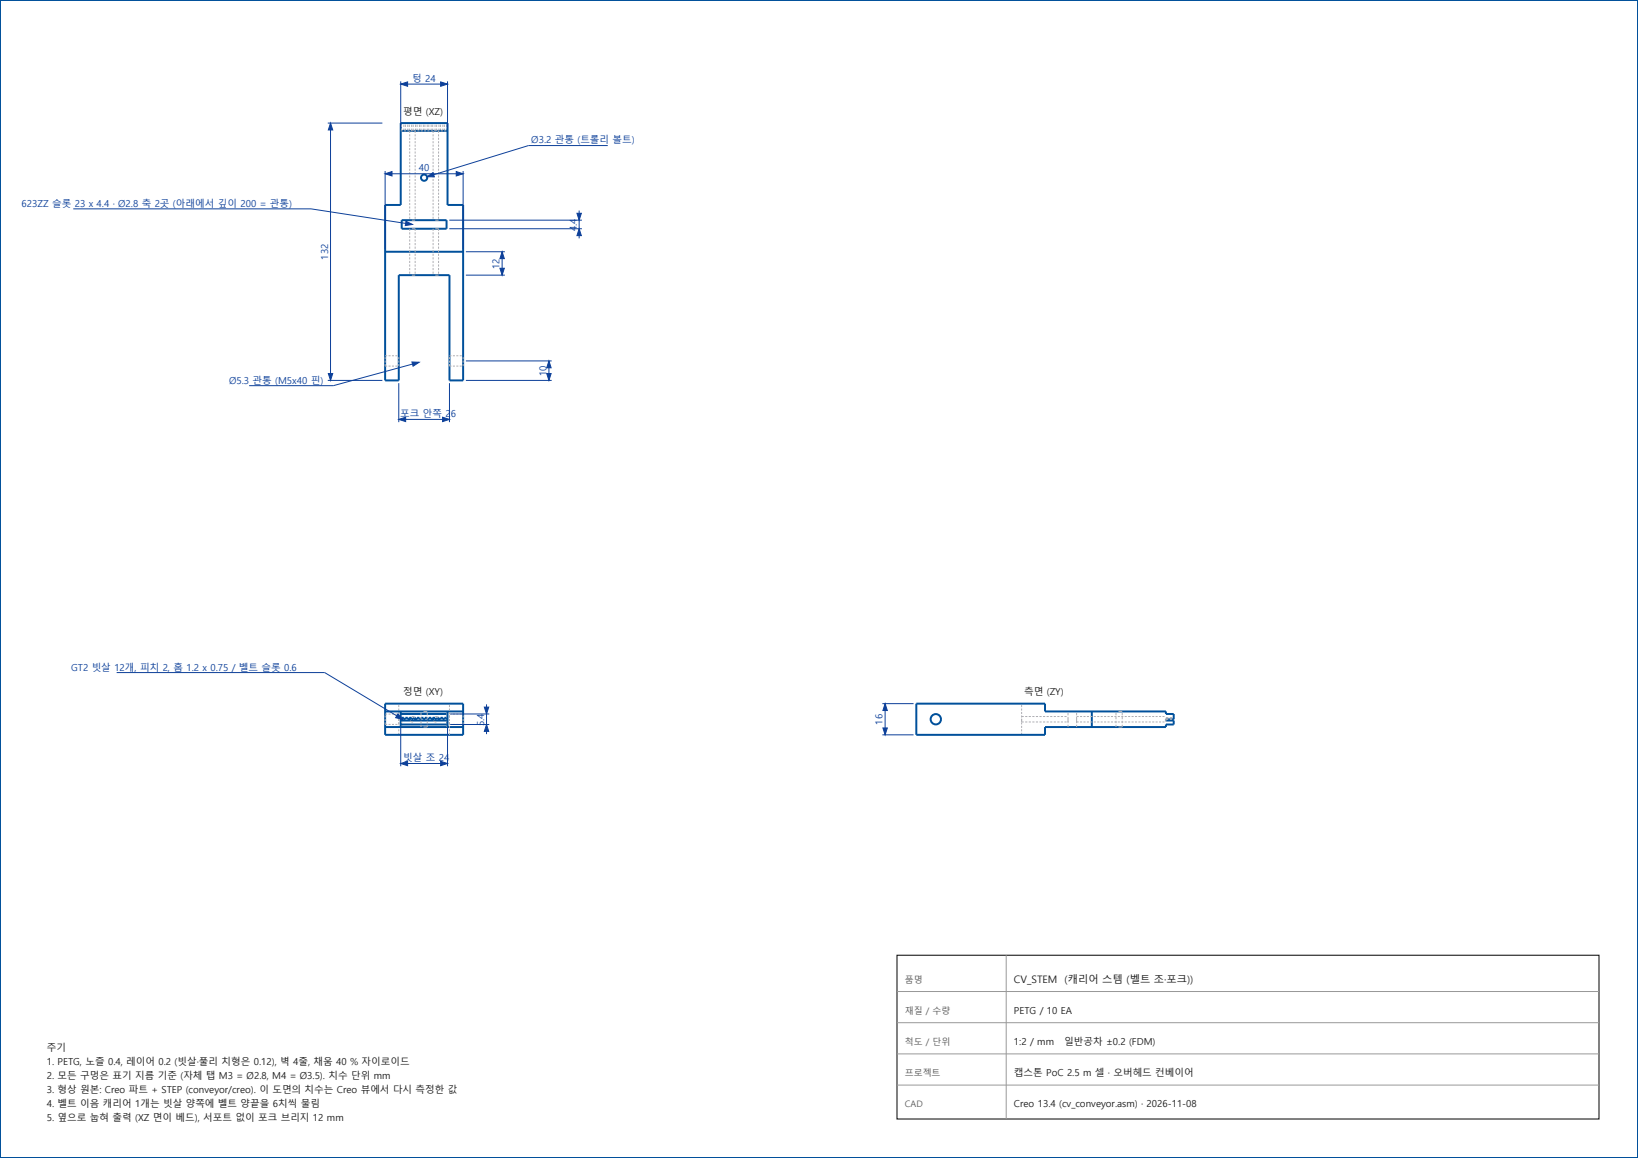
[picture p192: page 1]

Ø3.2 관통 (트롤리 볼트)

623ZZ 슬롯 23 x 4.4 · Ø2.8 축 2곳 (아래에서 깊이 200 = 관통)

품명 | CV_STEM (캐리어 스템 (벨트 조·포크))

재질 / 수량 | PETG / 10 EA

척도 / 단위 | 1:2 / mm 일반공차 ±0.2 (FDM)

1. PETG, 노즐 0.4, 레이어 0.2 (빗살·풀리 치형은 0.12), 벽 4줄, 채움 40 % 자이로이드
2. 모든 구멍은 표기 지름 기준 (자체 탭 M3 = Ø2.8, M4 = Ø3.5). 치수 단위 mm
3. 형상 원본: Creo 파트 + STEP (conveyor/creo). 이 도면의 치수는 Creo 뷰에서 다시 측정한 값
4. 벨트 이음 캐리어 1개는 빗살 양쪽에 벨트 양끝을 6치씩 물림
5. 옆으로 눕혀 출력 (XZ 면이 베드), 서포트 없이 포크 브리지 12 mm

프로젝트 | 캡스톤 PoC 2.5 m 셀 · 오버헤드 컨베이어

CAD | Creo 13.4 (cv_conveyor.asm) · 2026-11-08
