lsy041015/capstone-design-hanyang-university/poc_2.5m_cell/drawings/rack_center/RK_SHELF.pdf

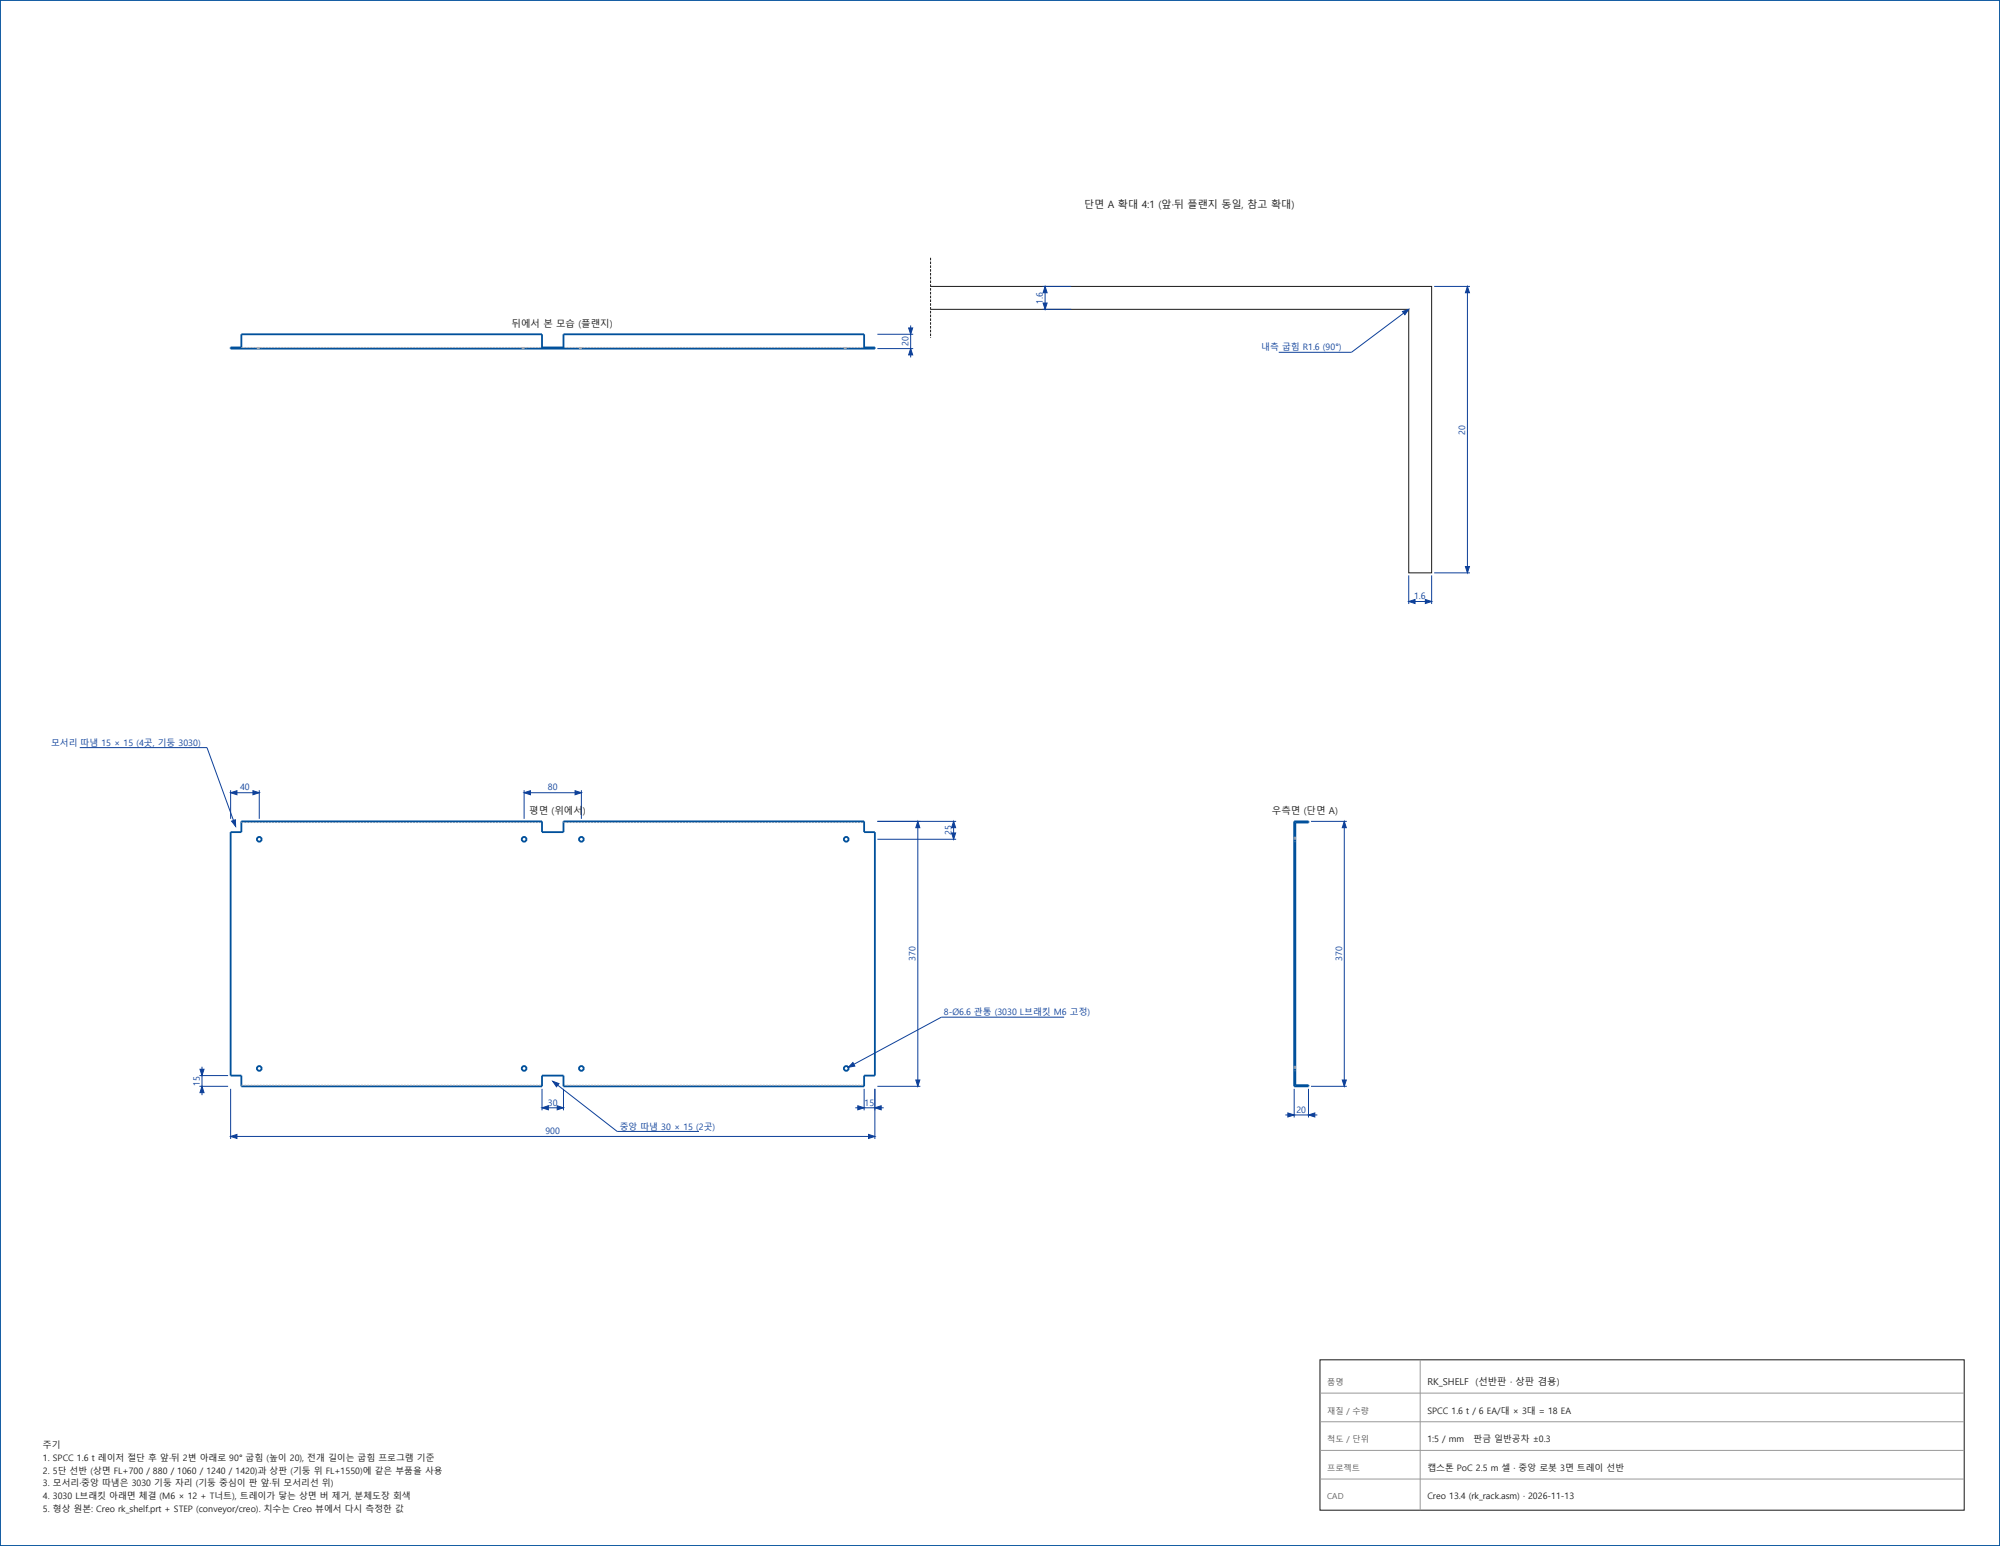
[picture p193: page 1]
평면 (위에서); 우측면 (단면 A)

단면 A 확대 4:1 (앞·뒤 플랜지 동일, 참고 확대)

뒤에서 본 모습 (플랜지)

모서리 따냄 15 × 15 (4곳, 기둥 3030)

8-Ø6.6 관통 (3030 L브래킷 M6 고정)

품명 | RK_SHELF (선반판 · 상판 겸용)

재질 / 수량 | SPCC 1.6 t / 6 EA/대 × 3대 = 18 EA

1. SPCC 1.6 t 레이저 절단 후 앞·뒤 2변 아래로 90° 굽힘 (높이 20), 전개 길이는 굽힘 프로그램 기준
2. 5단 선반 (상면 FL+700 / 880 / 1060 / 1240 / 1420)과 상판 (기둥 위 FL+1550)에 같은 부품을 사용
3. 모서리·중앙 따냄은 3030 기둥 자리 (기둥 중심이 판 앞·뒤 모서리선 위)
4. 3030 L브래킷 아래면 체결 (M6 × 12 + T너트), 트레이가 닿는 상면 버 제거, 분체도장 회색
5. 형상 원본: Creo rk_shelf.prt + STEP (conveyor/creo). 치수는 Creo 뷰에서 다시 측정한 값

척도 / 단위 | 1:5 / mm 판금 일반공차 ±0.3

프로젝트 | 캡스톤 PoC 2.5 m 셀 · 중앙 로봇 3면 트레이 선반

CAD | Creo 13.4 (rk_rack.asm) · 2026-11-13
