lsy041015/capstone-design-hanyang-university/poc_2.5m_cell/drawings/rack_center/CC_CELL.pdf

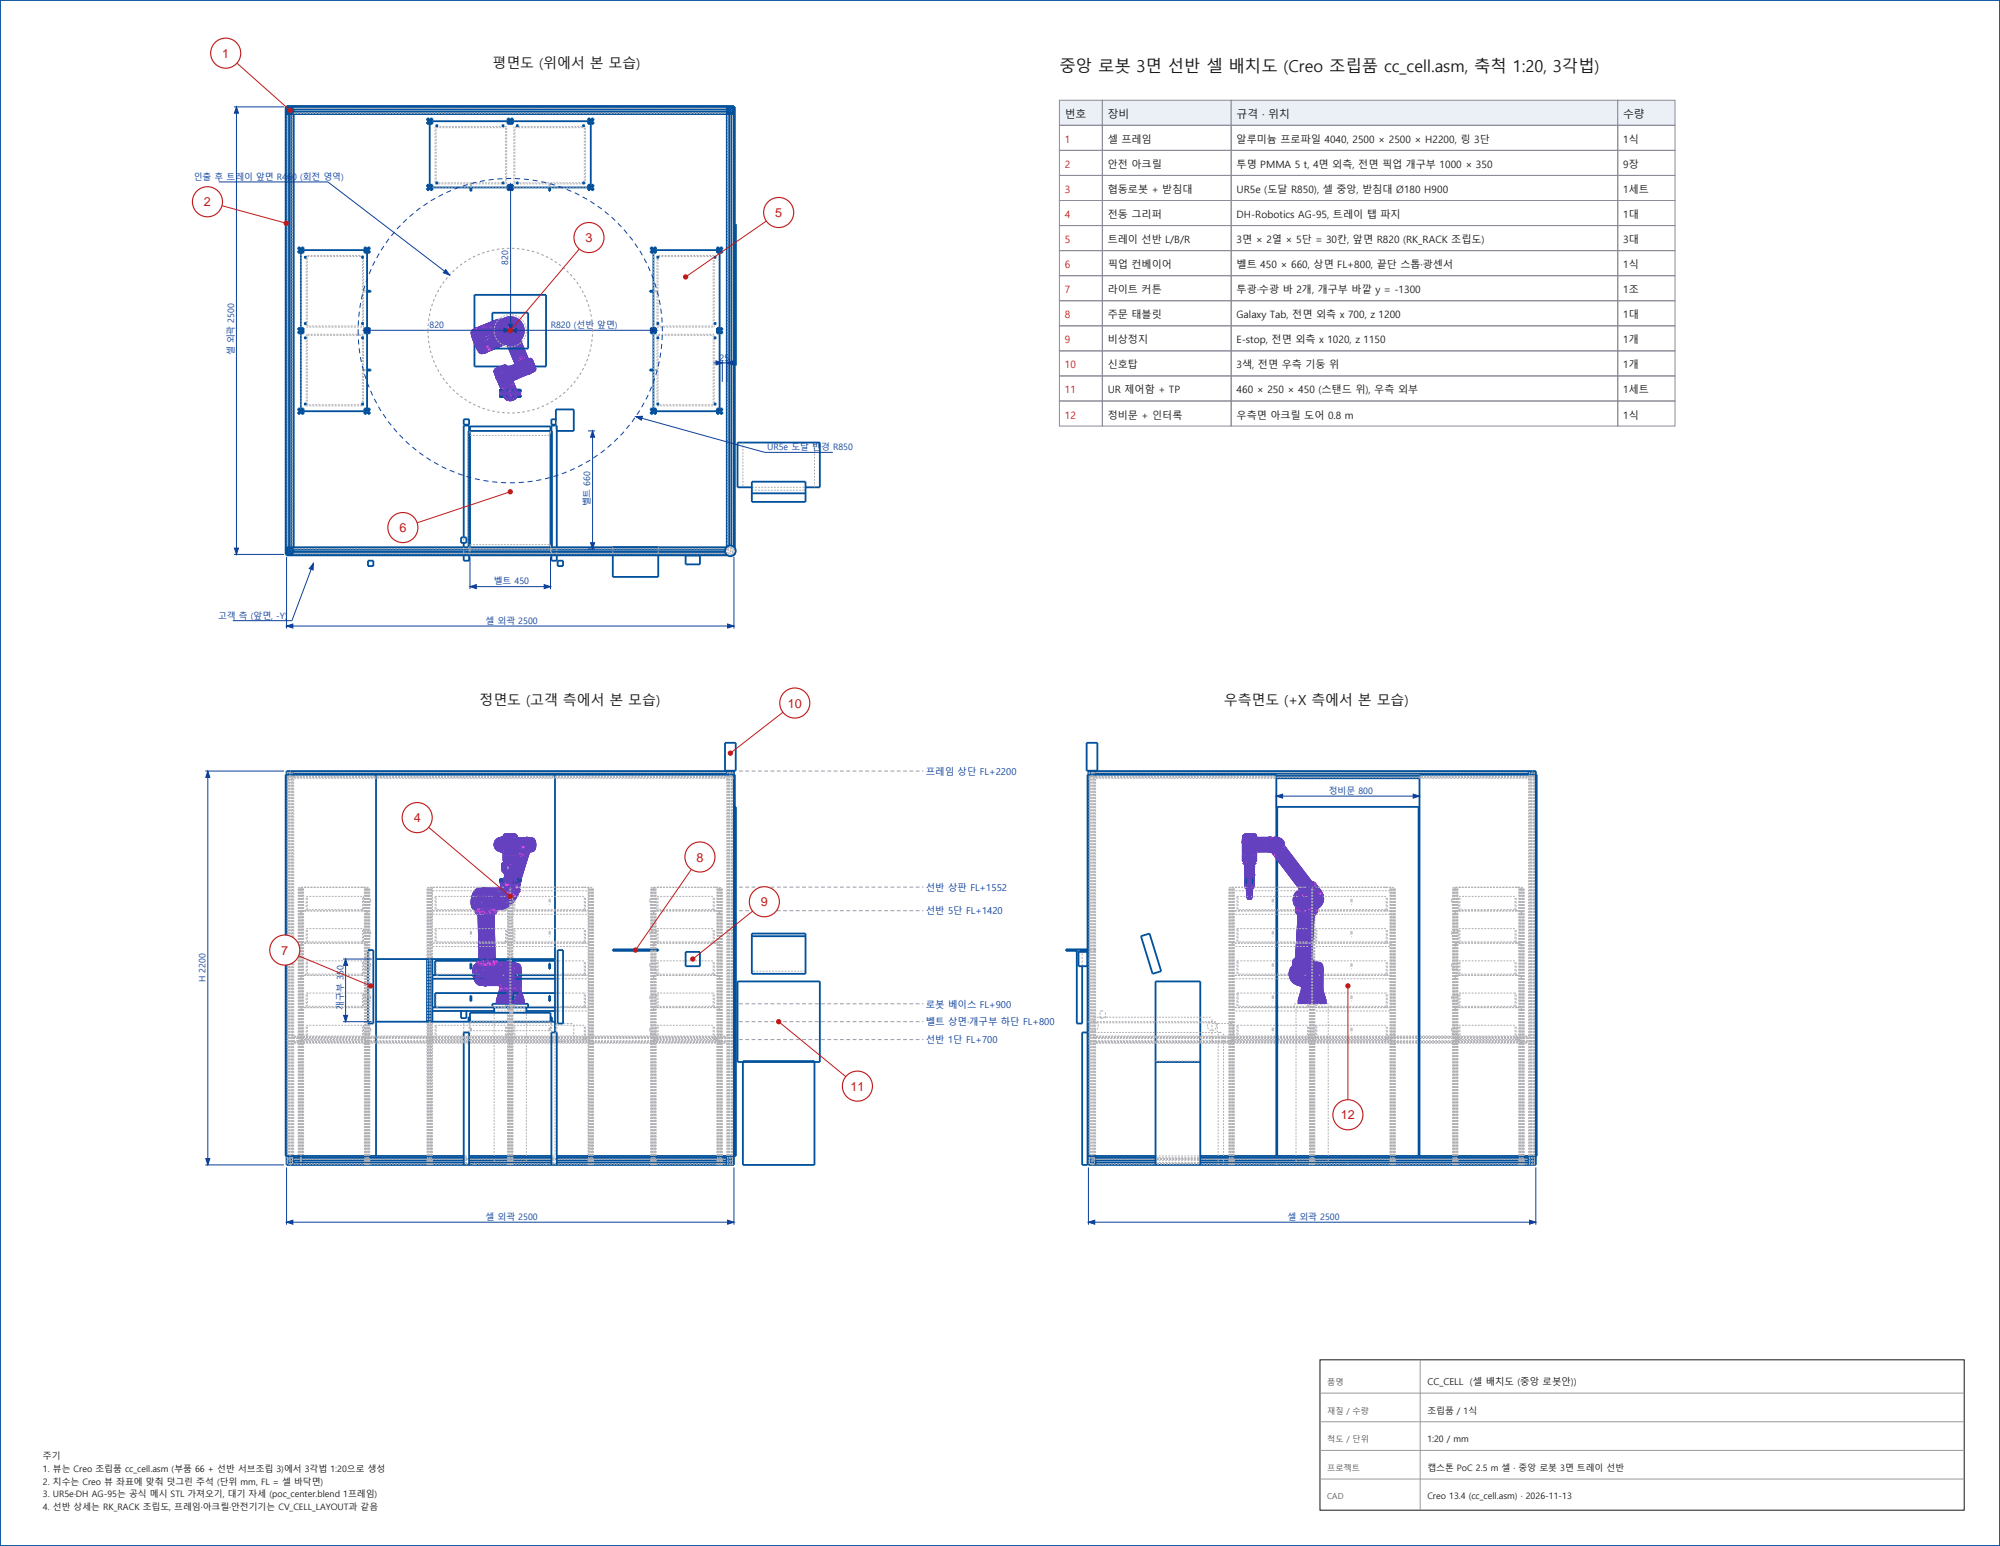
[picture p194: page 1]
개구부 350; 정비문 800; 정면도 (고객 측에서 본 모습); 우측면도 (+X 측에서 본 모습); 셀 프레임; 알루미늄 프로파일 4040, 2500 × 2500 × H2200, 링 3단; 안전 아크릴; 투명 PMMA 5 t, 4면 외측, 전면 픽업 개구부 1000 × 350; 협동로봇 + 받침대; UR5e (도달 R850), 셀 중앙, 받침대 Ø180 H900; 전동 그리퍼; DH-Robotics AG-95, 트레이 탭 파지; 트레이 선반 L/B/R; 3면 × 2열 × 5단 = 30칸, 앞면 R820 (RK_RACK 조립도); 픽업 컨베이어; 벨트 450 × 660, 상면 FL+800, 끝단 스톱·광센서; 라이트 커튼; 투광·수광 바 2개, 개구부 바깥 y = -1300; 주문 태블릿; Galaxy Tab, 전면 외측 x 700, z 1200; 비상정지; E-stop, 전면 외측 x 1020, z 1150; 신호탑; UR 제어함 + TP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

평면도 (위에서 본 모습)

중앙 로봇 3면 선반 셀 배치도 (Creo 조립품 cc_cell.asm, 축척 1:20, 3각법)

인출 후 트레이 앞면 R460 (회전 영역)

프레임 상단 FL+2200

로봇 베이스 FL+900
벨트 상면·개구부 하단 FL+800

1. 뷰는 Creo 조립품 cc_cell.asm (부품 66 + 선반 서브조립 3)에서 3각법 1:20으로 생성
2. 치수는 Creo 뷰 좌표에 맞춰 덧그린 주석 (단위 mm, FL = 셀 바닥면)
3. UR5e·DH AG-95는 공식 메시 STL 가져오기, 대기 자세 (poc_center.blend 1프레임)
4. 선반 상세는 RK_RACK 조립도, 프레임·아크릴·안전기기는 CV_CELL_LAYOUT과 같음
