lsy041015/capstone-design-hanyang-university/(commit log)

2026-09-26 docs: add v4 process video and flow details
2026-09-29 feat: publish V2.0 whole-store demo with process images and teaser
    - 42 process stills in six process folders (images/v2.0/), indexed in
    docs/v2.0_process_images.md with per-process contact sheets
    - V2.0 motion-study teaser (2:00, 1920x1080, 30 fps) and Korean subtitles
    - process design, model verification (7/7), video verification and the
    design-signal, parts/maintenance and control-property lists
    - README and README.en rewritten for V2.0; the v7 READMEs are archived as
    docs/v7_overview.md and docs/v7_overview.en.md, v7/v4 media unchanged
    [v2.0_control_properties.csv, v2.0_io_signals.csv, v2.0_parts_maintenance.csv]
2026-11-08 feat: add the 2.5 m PoC cell with a self-designed overhead conveyor
    Garment pickup step alone in a 2.5 m x 2.5 m profile cell: UR5e with a
    DH-Robotics PGC-50-35 gripper, 0.8 m pickup shelf through the acrylic,
    and an overhead conveyor (10 carriers, GT2 belt, printed slot track)
    designed in Creo: 17 parts, assembly, 9 dimensioned drawings, STEP/STL
    and BOM. Sampled interference checks: 0 hits.
2026-11-08 feat: switch the PoC gripper to the DH-Robotics AG-95
    AG-95 (95 mm stroke, 45-160 N per jaw, 3 kg rated) with custom fingertip
    pads keeps the 200 mm TCP; the sampled cycle still shows 0 interference
    hits. Renders and READMEs updated.
2026-11-08 feat: use the official DH-Robotics AG-95 URDF meshes on the PoC gripper
    Base and five linkage meshes from DH-Robotics/dh_gripper_ros (BSD per
    package.xml), driven by the URDF mimic ratios; TCP 190 mm, tab grip at
    0.615 rad. Shelf release reworked for the vertical fingers (TCP 80 mm
    above the shelf, 16 mm opening, lift, then full open). Sampled cycle:
    0 interference hits.
2026-11-08 docs: add the conveyor manual, exploded views and assembly drawing
    24-page Korean manual (operating principle diagrams, exploded views,
    BOM, calculations, assembly steps, verification, 10 A3 drawings),
    four exploded views with BOM balloons, the 1:10 overall assembly
    drawing, and renders with clearer acrylic panels.
2026-11-08 feat: add the Creo whole-cell assembly and layout drawing
    cv_cell.asm: 23 new cell parts (4040 frame, 5 mm acrylic, pedestal,
    shelf, safety/IO), the conveyor sub-assembly and the UR5e + DH AG-95
    meshes imported as STL in the pick pose. ANSI C 1:20 third-angle
    layout (plan, front, right) with dimensions and a 13-item equipment
    list; whole-cell STEP and third-party mesh notices.
2026-11-13 docs: add tray, centre-robot and file-drawer PoC variants to the READMEs
    Add variants B (tray rack), C (centre robot, 3-side racks, pickup belt) and
    D (file-drawer racks, 135 slots, QR check) with photo renders, the Creo
    drawings of the C-variant racks and their STEP files, and refresh the PoC
    callouts in README.md and README.en.md.
2026-11-13 docs: lead the front-page README with the latest 2.5 m PoC
    Add a "latest" section before the V2.0 content in README.md and
    README.en.md: hero photo, 4-variant table, photo grid and clickable
    thumbnails of the cell layouts and assembly drawings (new
    poc_2.5m_cell/drawings/preview/), with links to the drawing bundles.
